joshellissh/UltimaGC/ultima-app/assets/images/car_lights_off.png

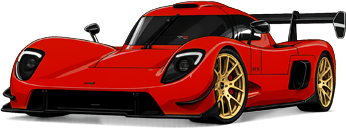
ultima-app/assets/images/car_lights_off.png
