joshellissh/UltimaGC/ultima-app/assets/images/car_lights_on.png

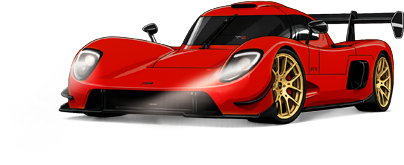
ultima-app/assets/images/car_lights_on.png
