joshellissh/UltimaGC/camdriver/nvp6324-1080p25-regseq.md

# NVP6324 — AHD20_1080P_25P register sequence (porting spec for nvp6324.c)

Validated extraction from the vendor reference (chip-only files) for **channel 0,
AHD 2.0 1080p25, 4-lane MIPI CSI-2 UYVY**. This is the spec to port into
`nvp6324_setup_mipi()` / `nvp6324_setup_channel()` (replacing the M0 stubs).

Format: `{bank, reg} = value`. Slave 0x60 (7-bit 0x30 in the ref; **this board is
0x31**). Bank select = reg 0xFF. 8-bit/8-bit. **Order matters** where noted.

## Critical gotchas (do these right)
- **OMIT the test pattern.** The ref calls `vd_pattern_enable()` unconditionally
  (bank0 0x1C-0x1F=0x1A; bank5/6/7/8 0x6A=0x80) → color bars. Do NOT port it, or we
  get bars instead of live video.
- **Use the net-final values** (List 4) where the EQ stage overwrites a seq value —
  a regmap driver writes each reg once.
- **`h_mask_sel` is bank(0x05+ch) 0x38 bits[3:0]=0x03, NOT bank0 0x8E** (my
  `nvp6324_regs.h` comment was wrong — fix it). `ahd_mode`=bank0 0x08=0x03 ✓,
  `burst_dec_c`=bank5 0xD1=0x30 ✓.
- **Bank-cache bug in the ref** (do the intended thing): CLK_AUTO must clear
  **bank1 0x7C bit(ch)** — the ref accidentally writes it in bank 0x13. Program
  bank1 0x7C[ch]=0 explicitly.
- Bitfield writes = `regmap_update_bits` (RMW): 01/7C[ch], 05/69[0], 05/38[4] &
  [3:0], 00/14[4]+CHID, 05/53[3:2], EQ 00/6C[3:0], bank13 0x30/0x31/0x32
  (clear bit ch & ch+4), bank21 0x3E nibble, bank20 0x01 [2ch +:2].

## Channel-index arithmetic (ch0 → ch1-3)
- per-ch decoder bank = `0x05 + ch`; bank0 color/timing regs `addr + ch`
  (0x00,0x08,0x14,0x20,0x68 families); bank9 H-scaler `addr + 0x20*ch`,
  FSC_EXT_VAL `0x50 + 4*ch`, FSC_DET `0x40+ch`; bank1 clocks `addr + ch`
  (0x84,0x88,0x8C,0xC8,0xCC,0xEC), CLK_AUTO 0x7C bit(ch); bankA/B EQ
  `bank = 0x0A + ((ch)/2)`, `addr = base + (ch%2)*0x80`; MIPI datatype 0x38+ch;
  arb enable `en_param |= 0x11 << ch`.

---

## LIST 1 — COMMON init (once)

### 1A video_decoder_init
- bank0x04: 0xA0..0xC3 = 0x24 (36 writes)
- bank0x01: 0xCC,0xCD,0xCE,0xCF = 0x64  (later zeroed by 1D — net 0x00)
- bank0x21: 0x07=0x80 then 0x07=0x00 (MIPI reset pulse)
- bank0x0A: 0x77=0x8F, 0xF7=0x8F ; bank0x0B: 0x77=0x8F, 0xF7=0x8F

### 1B mipi_tx_init (1080p / ~1242 MHz) — KEEP THIS ORDER (0x44/0x49 is a lock pulse)
bank0x21:
```
40=B4 41=00 42=03 43=43            (PLL)
11=08 10=13 12=0B 13=12 17=02 18=12 15=07 14=2D 16=0B 19=09 1A=15 1B=11 1C=0E  (D-PHY timing)
44=00 49=F3 49=F0 44=02            (PLL/reset latch pulse)
08=40 0F=01                        (frame-cnt en)
38=1E 39=1E 3A=1E 3B=1E            (VC0-3 datatype YUV422)
07=0F                              (4-lane enable)
2D=01
```

### 1C arb_init
bank0x20: 00=00 ; 40=01 ; 0F=00 ; 0D=01 ; 40=00 ; 00=en_param (0x11 ch0-only, 0xFF all 4)

### 1D disable_parallel
bank0x01: 0xC8..0xCF = 0x00 (8 writes)

### 1E vd_pattern_enable — **DO NOT PORT** (test pattern)

---

## LIST 2 — PER-CHANNEL (ch0, 1080p25), full-byte unless [pos:size]
(values already reconciled = final; †marked ones get overwritten by EQ → see LIST 4)
```
00/00=10                           per-ch soft-set
00/18=13                           EX_CBAR_ON
05/00=D0  05/01=A2†  05/92=00      AFE single-ended (05/01 → 2C final)
01/EC=00  01/C8=30                 VO yc-merge, vport_out_sel=4mux
13/30 &= ~0x11  13/31 &= ~0x11  13/32 &= ~0x01   (det-en clear, ch0)  [manual RMW]
01/7C[0]=0                         CLK_AUTO_1 off (bank1! see gotcha)
05/32=10  05/B9=B2†  05/6E=00 05/6F=00           (05/B9 → 72 final)
09/44=00
05/00=D0 05/02=0C 05/1E=00 05/58=00† 05/59=00 05/5A=00 05/5B=41 05/5C=78 05/94=00 05/95=00 05/65=80†   (vafe seq2; 58→77, 65→00 final)
00/10=20  00/0C=00  00/04=00  00/08=03  05/69[0]=0  05/62=20   (format seq3; ahd_mode=03)
00/5C=82  05/28=90†  05/25=DC  05/90=01                        (chroma; 28→80 final)
00/68=48  00/6C=00  00/60=10  00/78=80†  05/38[4]=1 05/38[3:0]=3  00/64=00†  00/14[4]=0  05/64=00 05/47=EE 05/A9=00   (h-timing; 78→21,64→05 final,05/38→0x13)
05/53[3:2]=0  09/96=00 09/97=00 09/98=00 09/99=00 09/9E=00      (h-scaler seq6)
05/50=C6  05/B8=39  05/BB=0F  05/B7=FC                          (hpll seq7)
00/20=00 00/24=86 00/28=80 00/58=80 00/40=00 00/44=00 00/48=00 00/4C=F8† 00/50=F8† 05/2B=A8 05/24=2A 05/5F=00 05/D1=30   (color seq8; 4C→FE,50→FB final)
09/44=00 09/50=30 09/51=6F 09/52=67 09/53=48                    (FSC_EXT_VAL)
05/26=40  05/B8=39  09/40=00  05/B5=80
00/14 = (old&0x10)|CHID(0)                                       (port ch id, RMW)
01/84=44†  01/88=01  01/8C=02  05/01=2C  05/05=24  05/1D=0C     (clock seq9; 84→04 final)
# then per-ch mipi glue:
21/3E low-nibble=0 (RMW)   20/01 [1:0]=0 (RMW, arb_scale=0)
```

## LIST 3 — Cable-EQ (STAGE_0/CABLE_A/SINGLE_ENDED, ch0) — runs AFTER list 2
```
05/65=00 05/58=77 05/5C=78 0A/3D=00 0A/3C=00
0A/30=AC 0A/31=78 0A/32=17 0A/33=C1 0A/34=40 0A/35=00 0A/36=C3 0A/37=0A 0A/38=00 0A/39=02 0A/3A=00 0A/3B=B2   (deqA_01..12)
00/24=86 00/30=00 00/34=00 05/31=82 00/5C=82 00/40=00 00/44=00 00/48=00 00/4C=FE 00/50=FB 00/28=80 05/27=57 05/28=80 05/2B=A8 05/24=2A 05/5F=00 05/D1=30 05/D5=80 0A/25=10 0A/27=1E   (color)
00/68=48 05/38=13 00/6C[3:0]=0 00/64=05          (timing_a)
01/84=04 01/88=01 01/8C=02                        (clk — 84→04 wins)
09/96..9E=00 (9 regs) 09/40=00 05/90=01 05/B9=72 05/57=00 05/25=DC 00/04=00 00/08=03 00/0C=00 00/78=21 05/1D=0C 05/01=2C 05/05=24   (timing_b)
```

## LIST 4 — net-final where seq vs EQ disagree (use these)
01/84=04 · 05/65=00 · 05/58=77 · 05/01=2C · 05/B9=72 · 05/28=80 · 00/4C=FE · 00/50=FB · 00/64=05 · 00/78=21

Source refs: mipi_dev_nvp6324.c:139-415, jaguar1_mipi.c:157-257, jaguar1_video.c:790-893,
jaguar1_video_table.h:773-853, jaguar1_video_eq.c:166-210, jaguar1_cableA_video_eq_table.h:741-830.
