joshellissh/UltimaGC/PSD Files/360 car.png

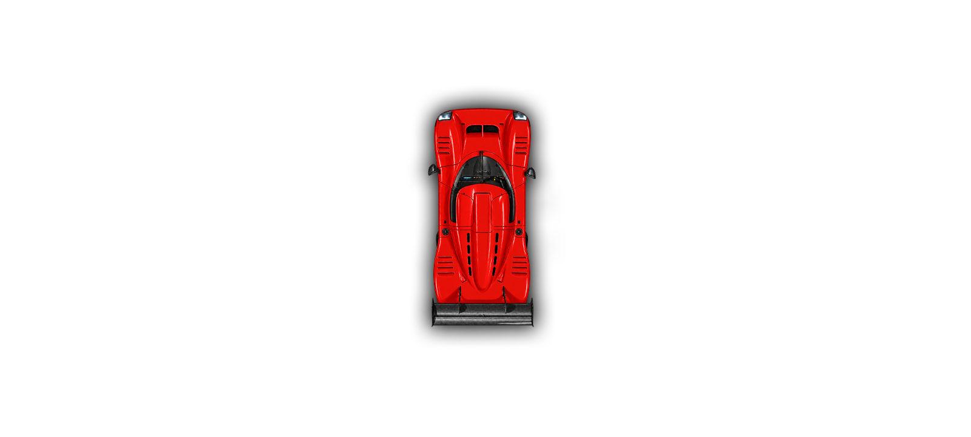
PSD Files/360 car.png
