joshellissh/UltimaGC/PSD Files/360 Top View.png

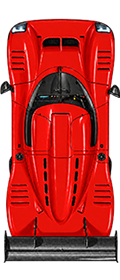
PSD Files/360 Top View.png
