joshellissh/UltimaGC/PSD Files/background overlay.png

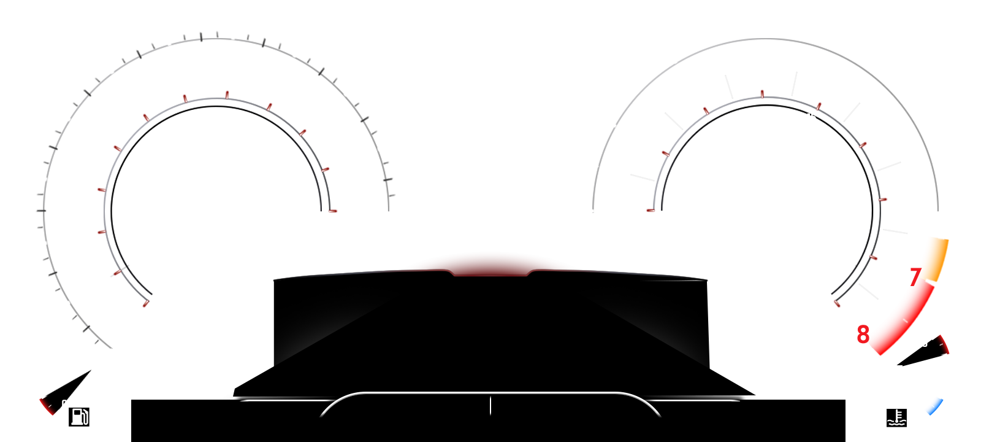
PSD Files/background overlay.png
