joshellissh/UltimaGC/PSD Files/boost circle.png

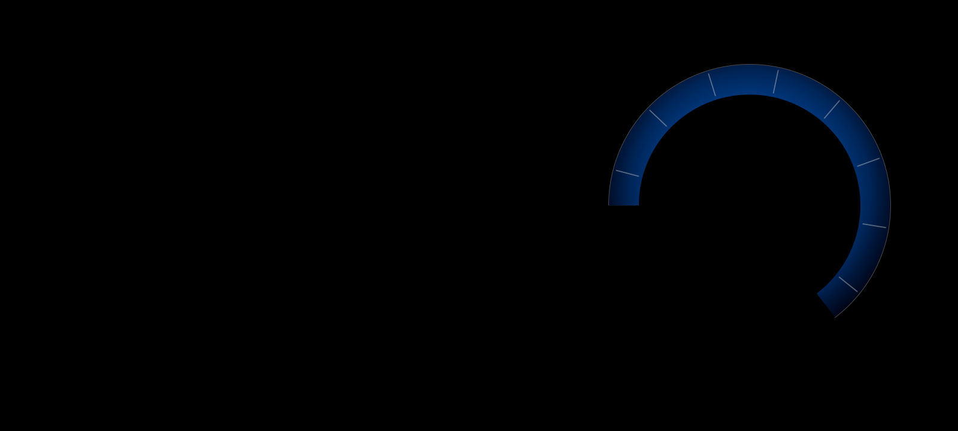
PSD Files/boost circle.png
