joshellissh/UltimaGC/PSD Files/car lights off.png

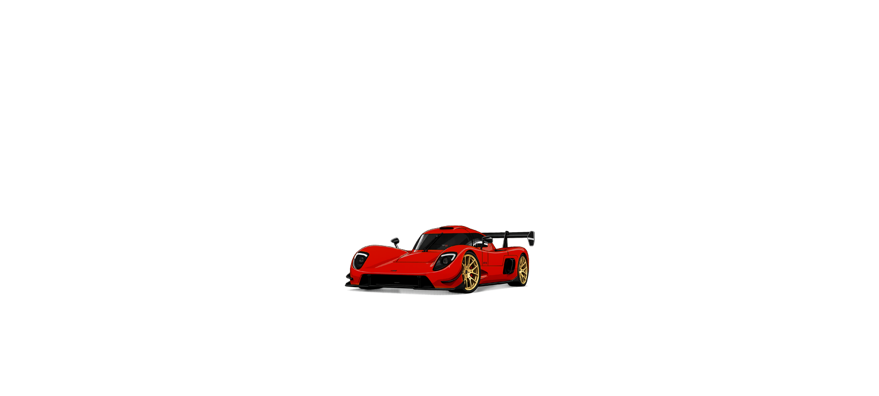
PSD Files/car lights off.png
