joshellissh/UltimaGC/PSD Files/cel shaded Ultima.png

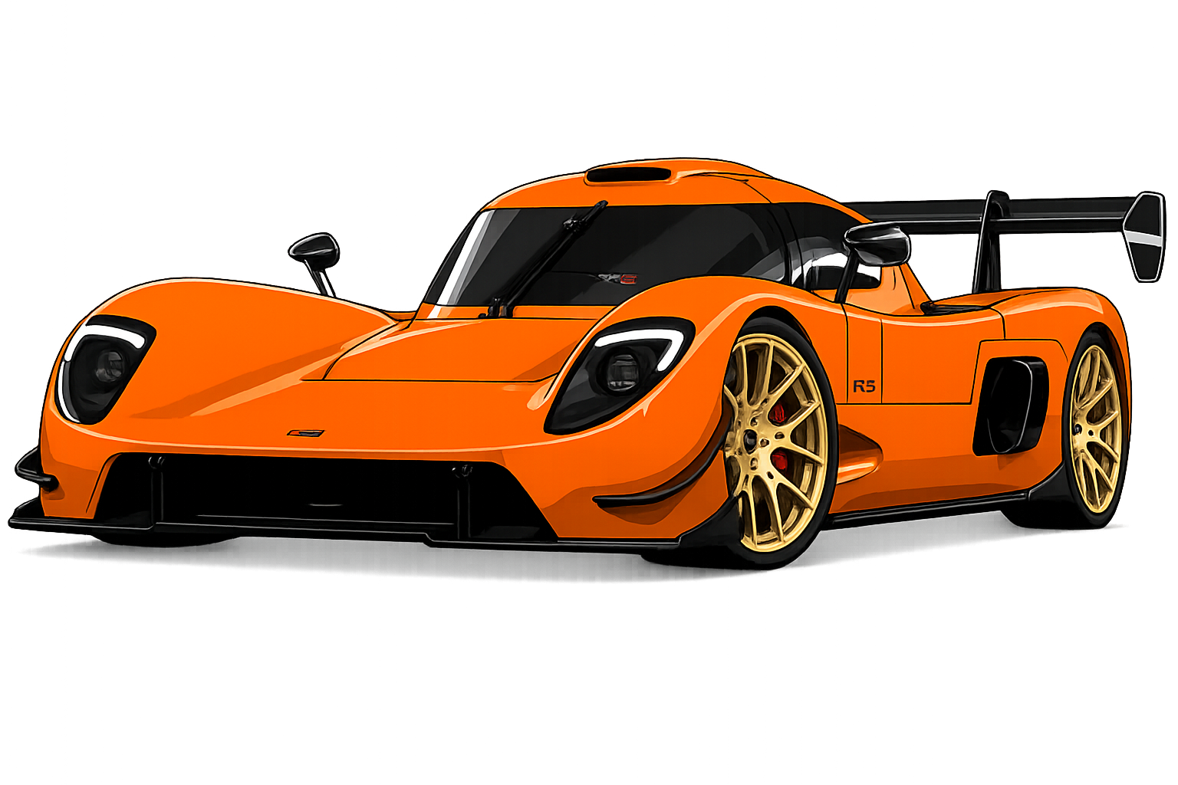
PSD Files/cel shaded Ultima.png
