joshellissh/UltimaGC/PSD Files/ChatGPT Image Jul 31, 2026, 09_45_48 AM.png

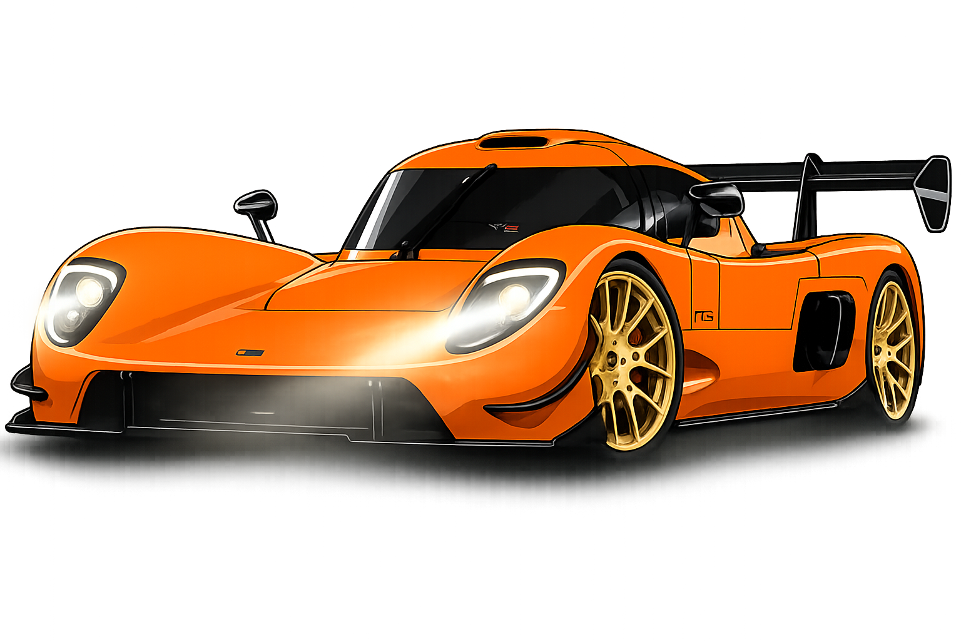
PSD Files/ChatGPT Image Jul 31, 2026, 09_45_48 AM.png
