joshellissh/UltimaGC/PSD Files/RS top view.png

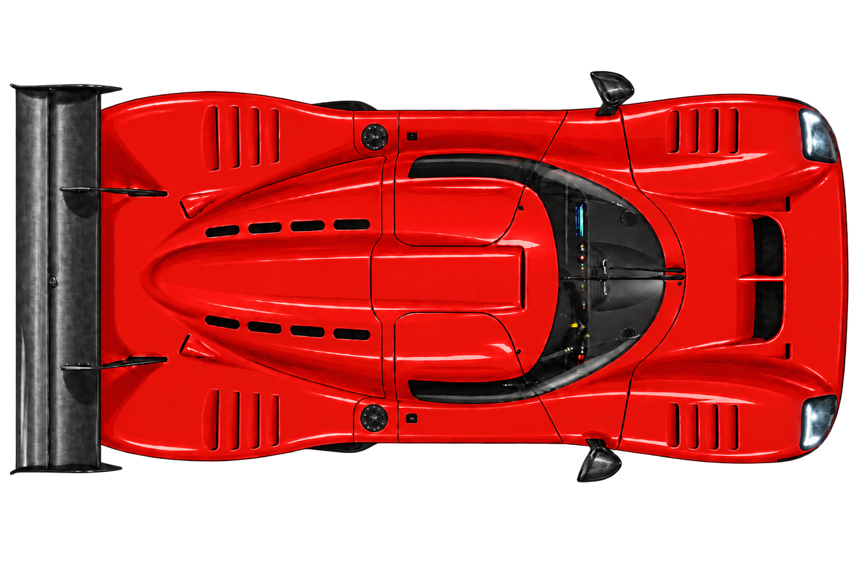
PSD Files/RS top view.png
