joshellissh/UltimaGC/PSD Files/three quarter wireframe outline.png

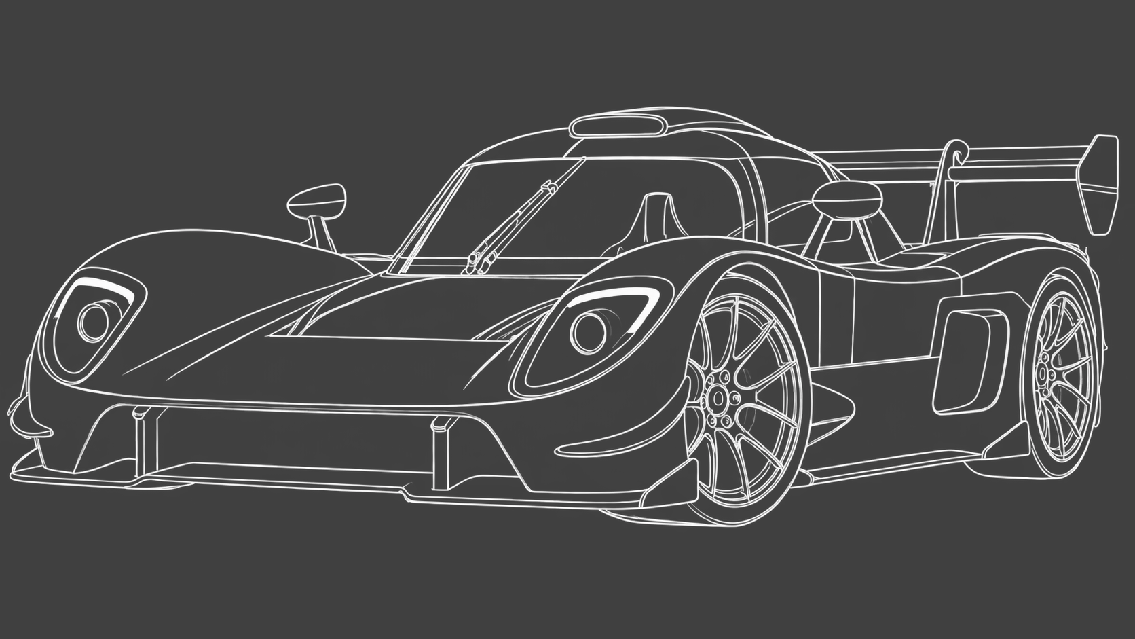
PSD Files/three quarter wireframe outline.png
