joshellissh/UltimaGC/enclosure/MCE18 Dummy.stl

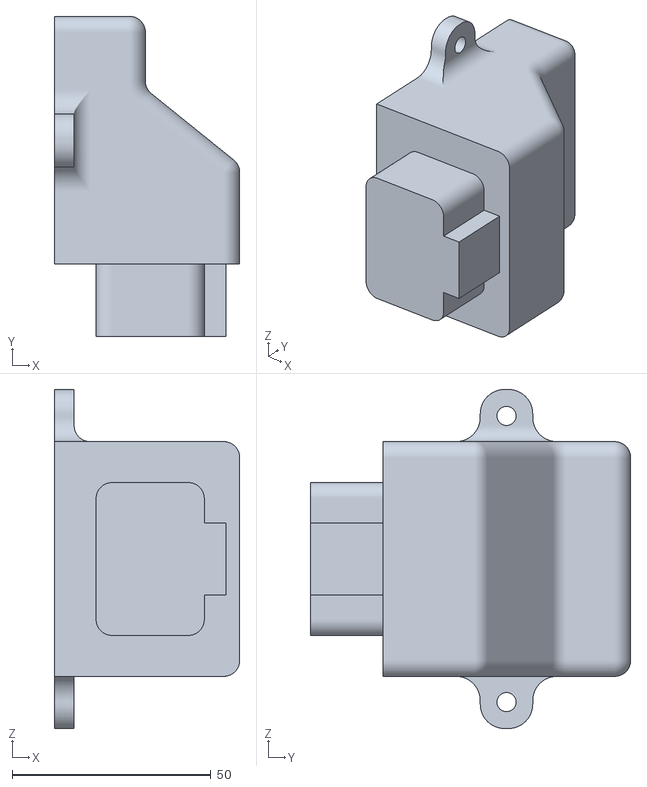
[picture p12: CAD file, 2026-08-24, last stored version]
enclosure/MCE18 Dummy.stl
46.6 x 80.5 x 85.2
