joshellissh/UltimaGC/enclosure/print files/Enclosure Base.step

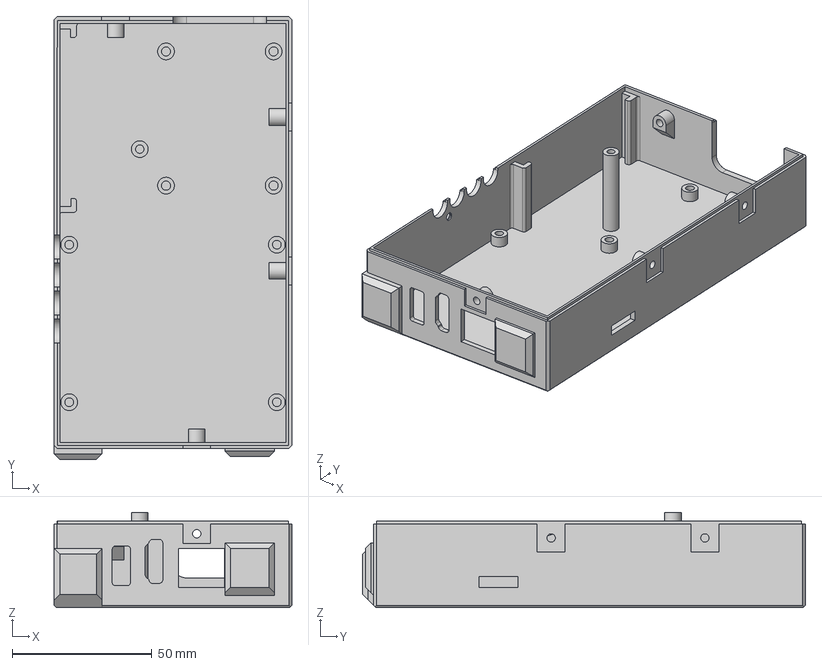
[picture p13: CAD file, 2026-08-26, last stored version]
enclosure/print files/Enclosure Base.step
85.0 x 158.5 x 34.0 mm
