joshellissh/UltimaGC/enclosure/print files/MY-CAM Holder bottom.step

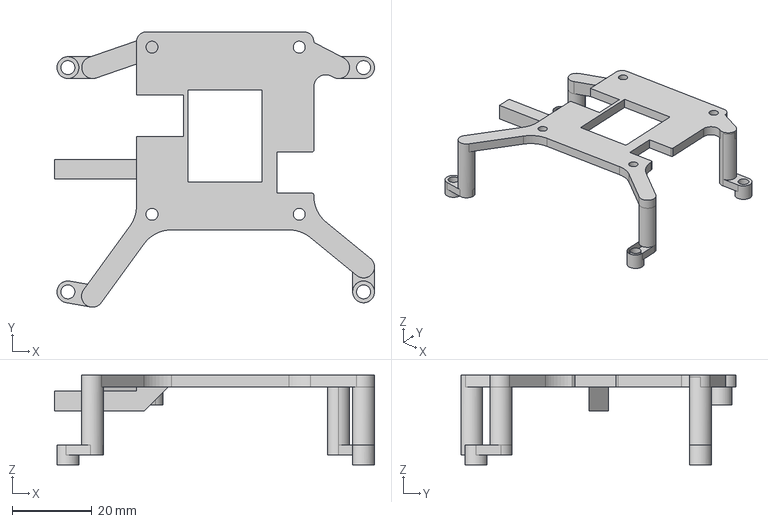
[picture p14: CAD file, 2026-08-25, last stored version]
enclosure/print files/MY-CAM Holder bottom.step
80.4 x 69.2 x 22.5 mm
