joshellissh/UltimaGC/enclosure/CAN_SPI_click_3.3V_v100.step

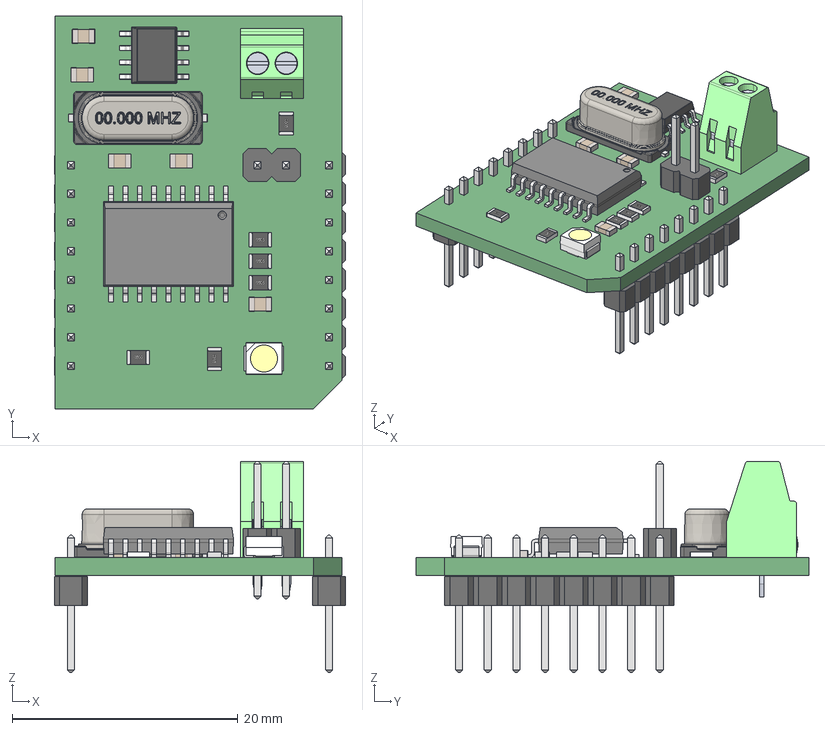
[picture p15: CAD file, 2026-08-24, last stored version]
enclosure/CAN_SPI_click_3.3V_v100.step
25.8 x 34.8 x 18.7 mm
Board
User_Library-SOIC18-300
User_Library-SMD_CAPACITOR0805 x 5
User_Library-Pin_Header_Strip_1x2 x 9
ScrewTerminal_2.54
SOIC08_narrow
User_Library-Everlight_67-21SRC-TR8_Imported
User_Library-Everlight_67-21SRC-TR8_Imported_2
User_Library-Everlight_67-21SRC-TR8_Imported_3
User_Library-Everlight_67-21SRC-TR8_Imported_4
User_Library-HC-49S
User_Library-R_0805 x 6
