joshellissh/UltimaGC/enclosure/print files/MY-CAM Holder.step

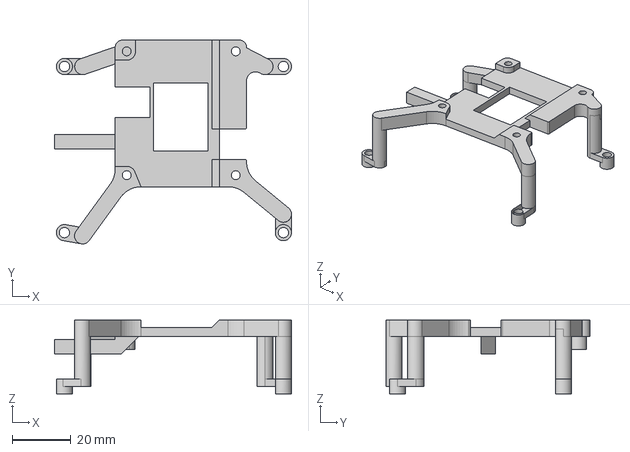
[picture p16: CAD file, 2026-08-25, last stored version]
enclosure/print files/MY-CAM Holder.step
80.4 x 69.2 x 25.0 mm
