joshellissh/UltimaGC/enclosure/print files/MY-CAM Holder Top.step

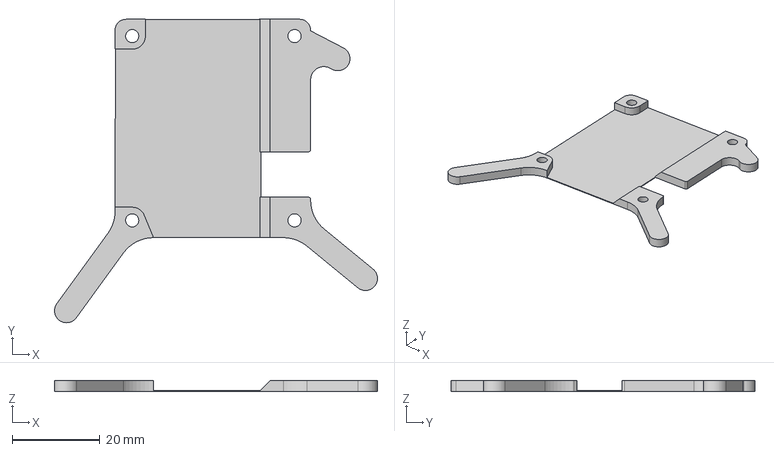
[picture p17: CAD file, 2026-08-25, last stored version]
enclosure/print files/MY-CAM Holder Top.step
73.6 x 69.2 x 2.50 mm
