joshellissh/UltimaGC/enclosure/pxc_1803277_05_01_MC-1-5-2-G-3-81_3D.stp

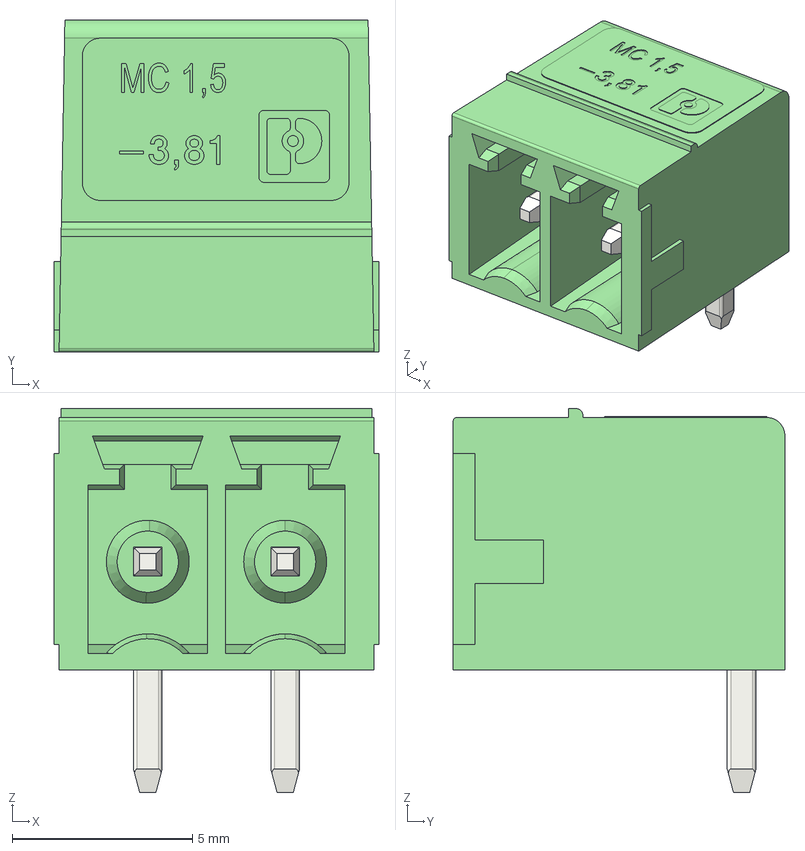
[picture p18: CAD file, 2026-08-24, last stored version]
enclosure/pxc_1803277_05_01_MC-1-5-2-G-3-81_3D.stp
9.01 x 9.20 x 10.7 mm
