joshellissh/UltimaGC/enclosure/Enclosure rev1.step

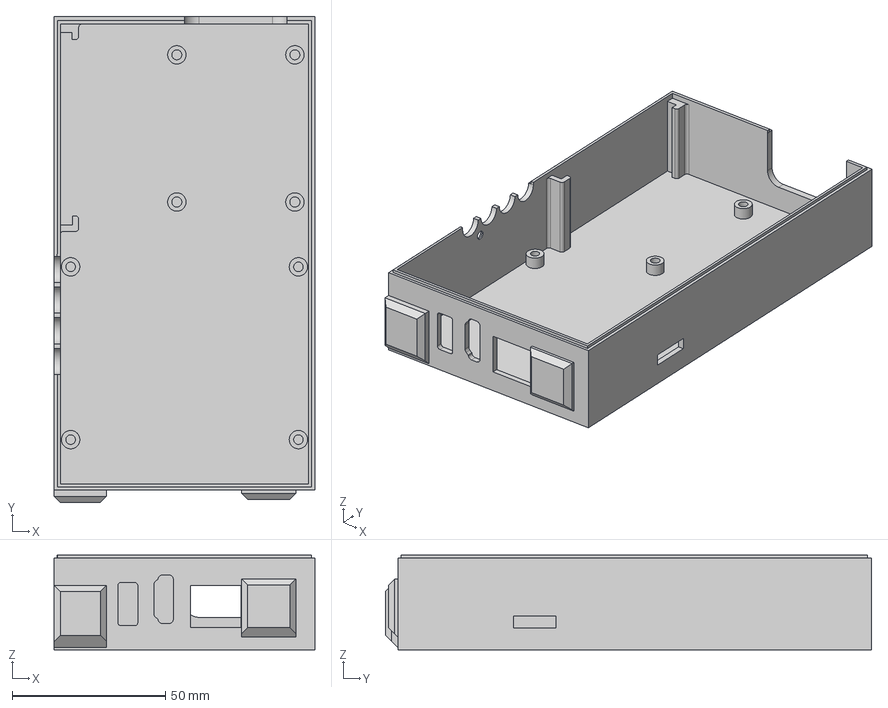
[picture p19: CAD file, 2026-08-24, last stored version]
enclosure/Enclosure rev1.step
85.0 x 158.5 x 30.9 mm
