joshellissh/UltimaGC/enclosure/print files/bust_1.stl

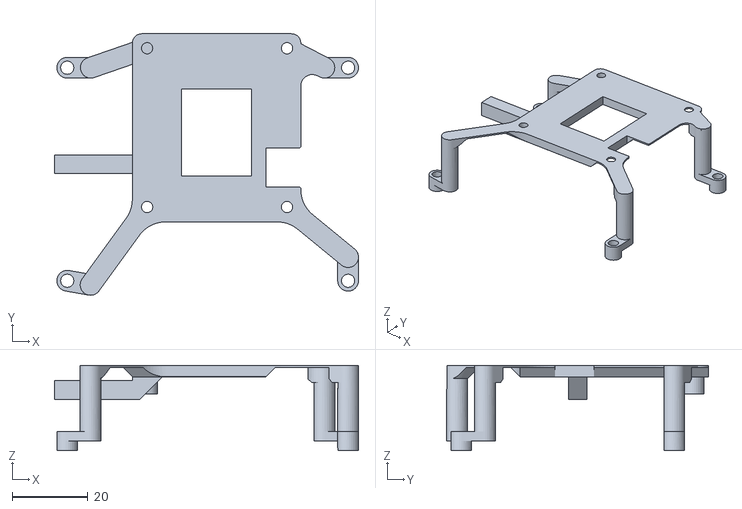
[picture p20: CAD file, 2026-08-25, last stored version]
enclosure/print files/bust_1.stl
80.4 x 69.2 x 22.5
