joshellissh/UltimaGC/enclosure/print files/USB Hub Support.step

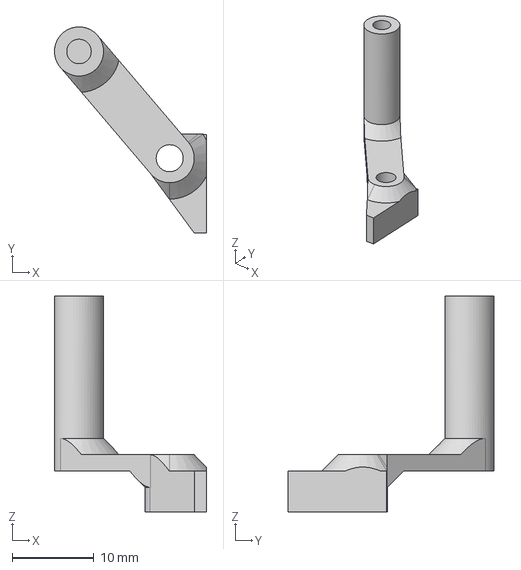
[picture p21: CAD file, 2026-08-25, last stored version]
enclosure/print files/USB Hub Support.step
18.6 x 25.2 x 26.4 mm
