joshellissh/UltimaGC/enclosure/TE 6437288-1.stp

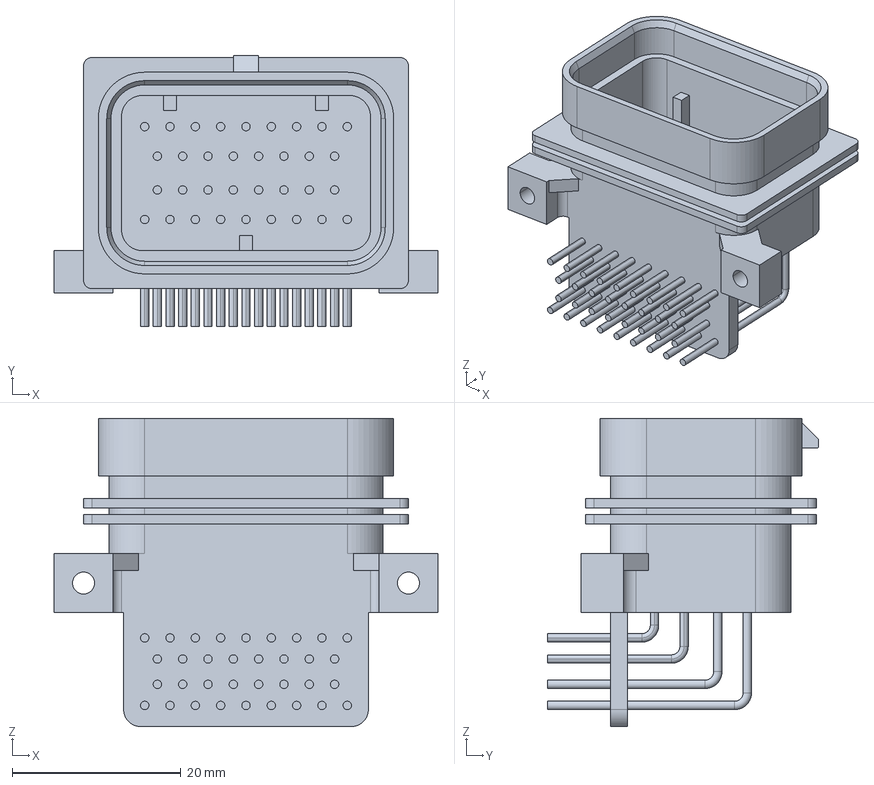
[picture p22: CAD file, 2026-08-24, last stored version]
enclosure/TE 6437288-1.stp
45.5 x 32.1 x 36.5 mm
