joshellissh/UltimaGC/enclosure/MY-CAM004M_PCB_65x50x1p6.step

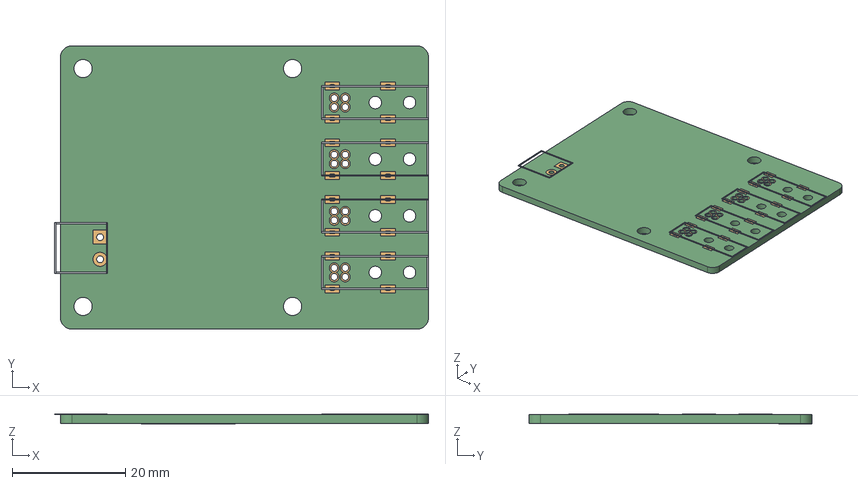
[picture p23: CAD file, 2026-08-24, last stored version]
enclosure/MY-CAM004M_PCB_65x50x1p6.step
66.0 x 50.0 x 1.84 mm
PCB
CON1_outline_1
CON1_outline_2
CON1_outline_3
CON1_outline_4
CON1_pinpad_1
CON1_pinpad_2
CON1_pinpad_3
CON1_pinpad_4
CON1_slotpad_1
CON1_slotpad_2
CON1_slotpad_3
CON1_slotpad_4
CON2_outline_1
CON2_outline_2
CON2_outline_3
CON2_outline_4
CON2_pinpad_1
CON2_pinpad_2
CON2_pinpad_3
CON2_pinpad_4
CON2_slotpad_1
CON2_slotpad_2
CON2_slotpad_3
CON2_slotpad_4
CON3_outline_1
CON3_outline_2
CON3_outline_3
CON3_outline_4
CON3_pinpad_1
CON3_pinpad_2
CON3_pinpad_3
CON3_pinpad_4
CON3_slotpad_1
CON3_slotpad_2
CON3_slotpad_3
CON3_slotpad_4
CON4_outline_1
CON4_outline_2
CON4_outline_3
CON4_outline_4
CON4_pinpad_1
CON4_pinpad_2
CON4_pinpad_3
CON4_pinpad_4
CON4_slotpad_1
CON4_slotpad_2
CON4_slotpad_3
CON4_slotpad_4
J6_outline_1
J6_outline_2
J6_outline_3
J6_outline_4
J6_pin1_pad
J6_pin2_pad
J7_outline_1
J7_outline_2
J7_outline_3
J7_outline_4
J7_pad_01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
