joshellissh/UltimaGC/enclosure/print files/bust_2.stl

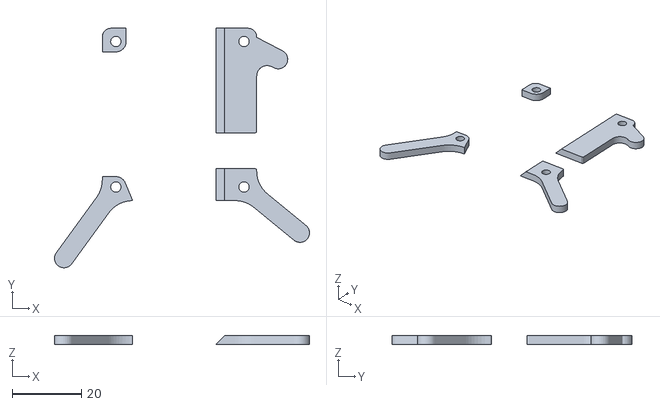
[picture p24: CAD file, 2026-08-25, last stored version]
enclosure/print files/bust_2.stl
73.6 x 69.2 x 2.50
