joshellissh/UltimaGC/enclosure/SJ-43514-SMT-TR--3DModel-STEP-1.STEP

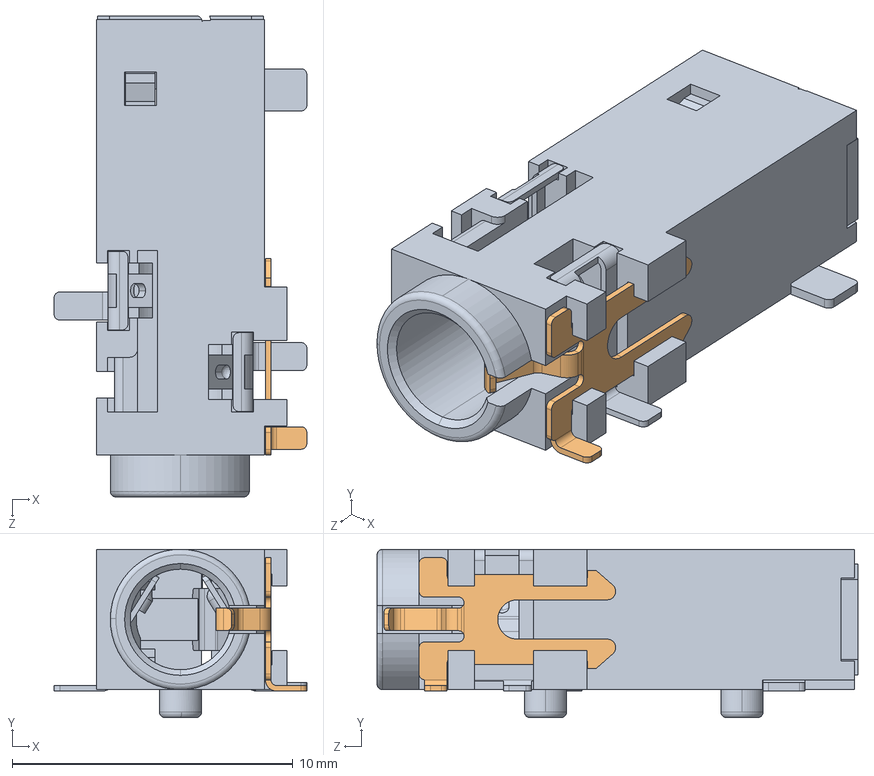
[picture p25: CAD file, 2026-08-24, last stored version]
enclosure/SJ-43514-SMT-TR--3DModel-STEP-1.STEP
9.00 x 6.00 x 17.1 mm
