joshellissh/UltimaGC/enclosure/FH12-24S-0.5SH.stp

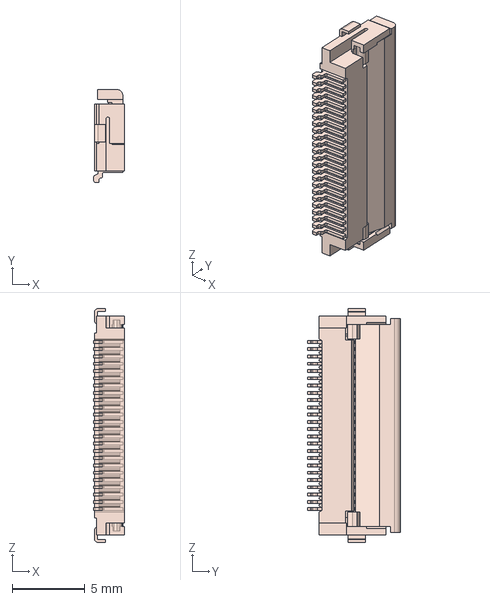
[picture p26: CAD file, 2026-08-24, last stored version]
enclosure/FH12-24S-0.5SH.stp
2.10 x 6.40 x 16.1 mm
