joshellissh/UltimaGC/enclosure/usb_hub_pcb_40x30_fused.step

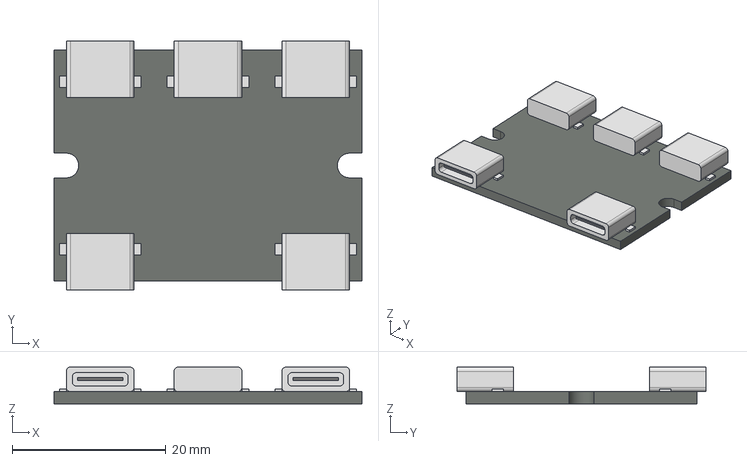
[picture p27: CAD file, 2026-08-24, last stored version]
enclosure/usb_hub_pcb_40x30_fused.step
40.0 x 32.4 x 4.80 mm
