joshellissh/UltimaGC/enclosure/687124149022_Wurth_24pin_0p5_bottom_hinge.stp

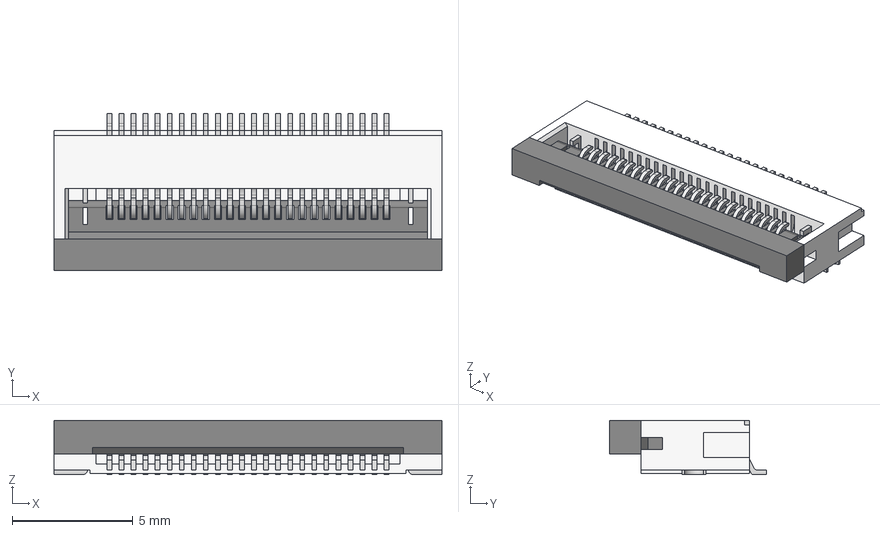
[picture p28: CAD file, 2026-08-24, last stored version]
enclosure/687124149022_Wurth_24pin_0p5_bottom_hinge.stp
16.1 x 6.50 x 2.25 mm
6871xx149022_Pin x 24
6871xx149022_Patte
6871xx149022_Patte2
687124149022_Actuator
