joshellissh/UltimaGC/(list of files, cad)

Other CAD files:
enclosure/MY-CAM Holder.step
enclosure/MY-CAM Holder.stl
enclosure/print files/MY-CAM Holder.iges
