joshellissh/UltimaGC/docs/MY-CAM to BeaglePlay Pin Mapping.pdf

1 | GND
2 | D0_N

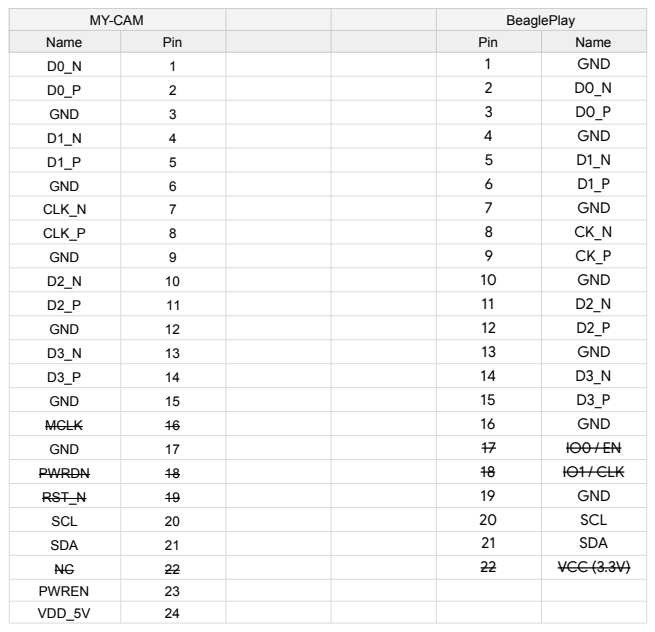
[picture p29: page 1]
MY-CAM; BeaglePlay; Name; Pin; GND; CLK_N; CLK_P; MCLK; PWRDN; IO1 / CLK; RST_N; SCL; SDA; VCC (3.3V); PWREN; VDD_5V
