joshellissh/UltimaGC/docs/MY-CAM004M/my-cam004m-20230725.pdf

## DVDD>=2.5V SEL18=Low

# Camera

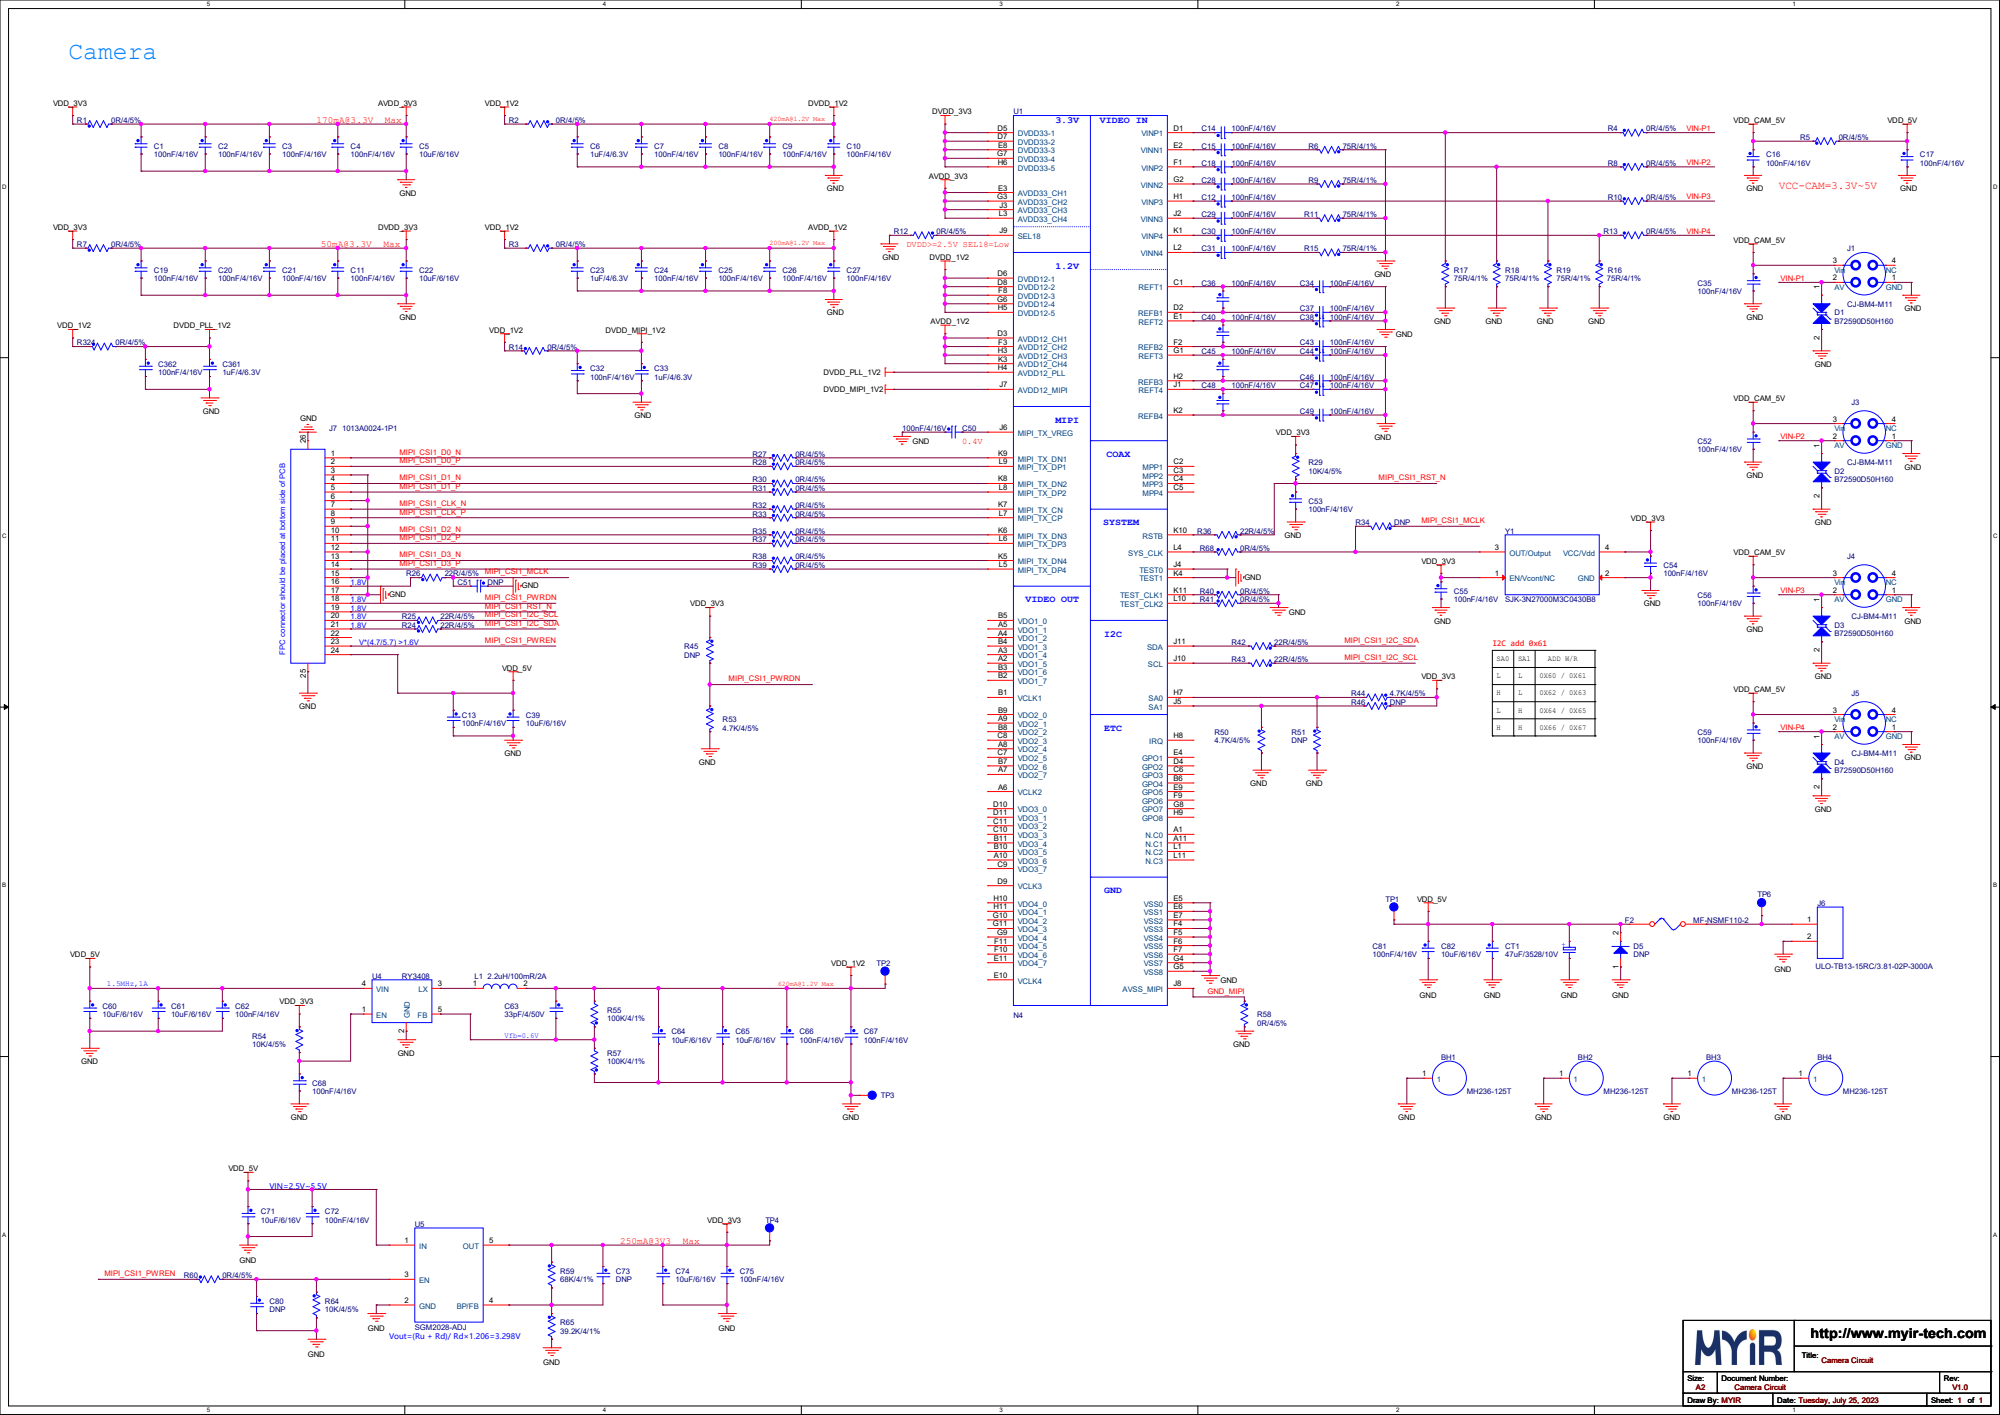
[picture p30: page 1]

FPC connector should be placed at bottom side of PCB

SA0 | SA1 | ADD W/R
L | L | 0X60 / 0X61
H | L | 0X62 / 0X63
L | H | 0X64 / 0X65
H | H | 0X66 / 0X67

SGM2028-ADJ
Vout=(Ru + Rd)/ Rd×1.206=3.298V

http://www.myir-tech.com
