joshellissh/UltimaGC/ultima-app/canbus.cpp

#include "canbus.h"
#include "odostore.h"

#include <QDateTime>
#include <QtGlobal>
#if !defined(__linux__) || defined(ULTIMA_SIMULATE)
#include <QRandomGenerator>
#include <cmath>
#include <algorithm>
#include <QStringList>
#include <QVariantMap>
#endif

#include <stdio.h>

#ifdef __linux__
#include <sys/socket.h>
#include <sys/ioctl.h>
#include <linux/can.h>
#include <linux/can/raw.h>
#include <net/if.h>
#include <unistd.h>
#include <fcntl.h>
#include <errno.h>
#include <string.h>
#endif

// Syvecs S7+ CAN frames are 8 bytes carrying four 16-bit big-endian quantities
// in slots 1..4 at byte offsets 0-1, 2-3, 4-5, 6-7. This car's CAN2 layout is
// a custom Generic CAN Transmit config (NOT a mirror of the CAN1 fixed stream
// DBC); verified frame map below was read from SCal Datastreams → Generic CAN
// Transmit → Transmit Content. Channel scalings/signedness are the Syvecs
// per-channel defaults documented in the published S7 Fixed Stream v3 DBC.

static inline quint16 be_u16(const quint8 *d, int off) {
    return (quint16(d[off]) << 8) | quint16(d[off + 1]);
}
static inline qint16 be_s16(const quint8 *d, int off) {
    return qint16(be_u16(d, off));
}

// MCE18 CAN bus expander (CANchecked-protocol) — supplies the analog/digital
// inputs the Syvecs S7+ has no channel for at all (fuel sender, turn
// signals, beams, axle lift). See docs/MCE18-manual_V3+V4.pdf and
// GAUGE-CLUSTER.md's MCE18 section for the full frame layout. Unit is
// configured via DSS (confirmed 2026-08-21): "CANchecked 0-5000mV" protocol,
// TX Base ID 0x700 (datasheet default), CAN speed 1 Mbit/s to match Syvecs
// CAN2 and can0's udev-configured bitrate. The AIN0-8/DIN0-7/AUX1-3 frame
// layout (this frame + Base ID+2 below) is identical between the
// "0-1023bit" and "0-5000mV" protocol options — only the frequency-channel
// frames at Base ID+3 onward (unused here) differ — so this TX Base ID and
// byte layout aren't protocol-dependent, just the protocol choice below.
static constexpr quint32 kMce18Base = 0x700;
// AIN0-8 are millivolts (0-5000mV) directly under the configured
// "CANchecked 0-5000mV" protocol — the unit does its own ADC-to-voltage
// conversion internally, no raw-counts-to-mV scaling needed on our end.
// Fuel sender: 1V empty, 4V full (per sender spec) — narrower than the AIN's
// own 0-5V range, so this is still a conversion against the sender's own
// linear span, just no longer stacked on top of a raw-to-mV one.
static constexpr double kFuelSenderEmptyMv = 1000.0;
static constexpr double kFuelSenderFullScaleMv = 4000.0;

CanBus::CanBus(OdoStore *odo, const QString &iface, QObject *parent)
    : QObject(parent), m_odo(odo), m_iface(iface)
{
    if (m_odo) {
        m_totalOdo = m_odo->totalOdo();
        m_tripOdo = m_odo->tripOdo();
    }
    m_ind[IndLeft].level = &m_leftIndicator;
    m_ind[IndLeft].changed = &CanBus::leftIndicatorChanged;
    m_ind[IndRight].level = &m_rightIndicator;
    m_ind[IndRight].changed = &CanBus::rightIndicatorChanged;
    m_ind[IndHazard].level = &m_hazard;
    m_ind[IndHazard].changed = &CanBus::hazardChanged;
    m_reconnectTimer.setInterval(1000);
    connect(&m_reconnectTimer, &QTimer::timeout, this, &CanBus::tryConnect);
    tryConnect();
}

CanBus::~CanBus()
{
    closeSocket();
}

void CanBus::closeSocket()
{
#ifdef __linux__
    if (m_notifier) {
        m_notifier->setEnabled(false);
        m_notifier->deleteLater();
        m_notifier = nullptr;
    }
    if (m_fd >= 0) {
        ::close(m_fd);
        m_fd = -1;
    }
#endif
}

void CanBus::tryConnect()
{
#if defined(__linux__) && !defined(ULTIMA_SIMULATE)
    if (m_fd >= 0)
        return;

    int fd = ::socket(PF_CAN, SOCK_RAW | SOCK_NONBLOCK, CAN_RAW);
    if (fd < 0) {
        fprintf(stderr, "[canbus] socket(PF_CAN): %s\n", strerror(errno));
        m_reconnectTimer.start();
        return;
    }

    struct ifreq ifr;
    memset(&ifr, 0, sizeof(ifr));
    strncpy(ifr.ifr_name, m_iface.toLocal8Bit().constData(), IFNAMSIZ - 1);
    if (::ioctl(fd, SIOCGIFINDEX, &ifr) < 0) {
        // Interface not present yet — udev hasn't brought it up.
        ::close(fd);
        m_reconnectTimer.start();
        return;
    }

    struct sockaddr_can addr;
    memset(&addr, 0, sizeof(addr));
    addr.can_family = AF_CAN;
    addr.can_ifindex = ifr.ifr_ifindex;
    if (::bind(fd, (struct sockaddr *)&addr, sizeof(addr)) < 0) {
        // Most common reason here: link is administratively down.
        fprintf(stderr, "[canbus] bind(%s): %s\n",
                qPrintable(m_iface), strerror(errno));
        ::close(fd);
        m_reconnectTimer.start();
        return;
    }

    m_fd = fd;
    m_notifier = new QSocketNotifier(fd, QSocketNotifier::Read, this);
    connect(m_notifier, &QSocketNotifier::activated, this, &CanBus::onReadable);
    m_reconnectTimer.stop();
    fprintf(stderr, "[canbus] connected to %s\n", qPrintable(m_iface));
#else
    // SocketCAN is Linux-only, and even on Linux this branch only compiles
    // for dev builds (CONFIG+=ultima_dev_sim). Drive the gauges with a
    // simulated data stream instead (see simulateTick()) so the QML can be
    // exercised without real CAN hardware. tryConnect() only runs once here
    // (nothing re-triggers it), so this wiring happens exactly once.
    fprintf(stderr, "[canbus] SocketCAN unavailable/disabled for this build — simulating data\n");
    connect(&m_simTimer, &QTimer::timeout, this, &CanBus::simulateTick);
    m_simTimer.start(60);
#endif
}

void CanBus::onReadable()
{
#ifdef __linux__
    struct can_frame frame;
    for (int i = 0; i < 64; ++i) {     // drain up to 64 per wake
        ssize_t n = ::read(m_fd, &frame, sizeof(frame));
        if (n < 0) {
            if (errno == EAGAIN || errno == EWOULDBLOCK)
                return;
            // Bus error / interface went down — close and retry.
            fprintf(stderr, "[canbus] read: %s — reconnecting\n", strerror(errno));
            closeSocket();
            m_reconnectTimer.start();
            return;
        }
        if (n != (ssize_t)sizeof(frame))
            return;
        // Skip error/RTR/extended frames — Syvecs uses 11-bit data frames.
        if (frame.can_id & (CAN_ERR_FLAG | CAN_RTR_FLAG | CAN_EFF_FLAG))
            continue;
        decodeFrame(frame.can_id & CAN_SFF_MASK, frame.data, frame.can_dlc);
    }
#endif
}

void CanBus::accumulateOdometer()
{
    qint64 now = QDateTime::currentMSecsSinceEpoch();
    if (m_lastSpeedMs != 0 && m_speed > 0) {
        double dt = (now - m_lastSpeedMs) / 1000.0;
        if (dt > 0 && dt < 1.0) {           // ignore stalls
            double miles = m_speed * dt / 3600.0;
            m_totalOdo += miles;
            m_tripOdo += miles;
            emit totalOdoChanged();
            emit tripOdoChanged();
        }
    }
    m_lastSpeedMs = now;
}

// Syvecs limpMode enum (Frame 5/0x604 slot 4), from the "Enum Values" column of
// docs/Auto Bionics CAN2 Mapping.xlsx. 1-6 are limps (power reduced); 100+ are
// trips (engine shut down). name is the sheet's label (Diagnostic screen);
// message is the plain-English text for the dash's limp box. Neither says
// which way a sensor tripped (too high or too low) — the sheet doesn't either.
// Codes not in the sheet show as "LIMP n" / "Limp code n" rather than being
// hidden. Ascending — debugCycleLimpMode() steps through it in order.
struct LimpModeEntry { int code; const char *name; const char *message; };
static const LimpModeEntry kLimpModes[] = {
    {   0, "OFF",                  "" },
    {   1, "LIMP SWITCH ON",       "Limp switch on" },
    {   2, "ECT COLD",             "Engine coolant cold" },
    {   3, "EOT COLD",             "Engine oil cold" },
    {   4, "SENSOR WARNING LEVEL", "Sensor warning" },
    {   5, "AUTO TRANS",           "Transmission fault" },
    {   6, "VEHICLE SPEED FAULT",  "Vehicle speed fault" },
    { 100, "EOP TRIP",             "Oil pressure trip" },
    { 101, "CCP TRIP",             "Crankcase pressure trip" },
    { 102, "KNOCK SHUTDOWN",       "Knock shutdown" },
    { 103, "EOT TRIP",             "Oil temperature trip" },
    { 104, "ECT TRIP",             "Coolant temperature trip" },
    { 105, "FP TRIP",              "Fuel pressure trip" },
    { 106, "PREIGN SHUTDOWN",      "Pre-ignition shutdown" },
    { 107, "TIME ON LOAD LIMIT",   "Time on load limit" },
    { 108, "TRQ TRIP",             "Torque trip" },
    { 109, "VVT FAIL",             "VVT failure" },
    { 110, "VBAT TRIP",            "Battery voltage trip" },
    { 111, "LEAN TRIP",            "Lean mixture trip" },
    { 112, "ACT TRIP",             "Air charge temp trip" },
    { 113, "ECP TRIP",             "Coolant pressure trip" },
};

static const LimpModeEntry *findLimpMode(int code)
{
    for (const LimpModeEntry &e : kLimpModes) {
        if (e.code == code)
            return &e;
    }
    return nullptr;
}

QString CanBus::limpModeName() const
{
    const LimpModeEntry *e = findLimpMode(m_limpMode);
    return e ? QString::fromLatin1(e->name) : QStringLiteral("LIMP %1").arg(m_limpMode);
}

QString CanBus::limpModeMessage() const
{
    const LimpModeEntry *e = findLimpMode(m_limpMode);
    return e ? QString::fromLatin1(e->message) : QStringLiteral("Limp code %1").arg(m_limpMode);
}

// Human-readable converted values for one frame, for the diagnostics screen's
// raw-frame monitor. Applies the same scalings as decodeFrame() below (keep the
// two in step) but shows every decoded slot's engineering value plus its raw
// count where the conversion is non-trivial, without touching any state.
static QString describeFrame(quint32 id, const quint8 *d, int dlc)
{
    if (dlc < 8)
        return QStringLiteral("short frame (dlc %1)").arg(dlc);
    auto n = [](double v, int dec) { return QString::number(v, 'f', dec); };

    switch (id) {
    case 0x600: {
        double mapMbar = be_s16(d, 6);
        return QStringLiteral("rpm %1 | TPS %4% | MAP %2 mbar (boost %3 psi)")
            .arg(qMax(0, int(be_s16(d, 0))))
            .arg(mapMbar, 0, 'f', 0)
            .arg(qMax(0.0, (mapMbar - 1013.25) * 0.0145038), 0, 'f', 1)
            .arg(be_s16(d, 4) / 81.92, 0, 'f', 1);
    }
    case 0x601: {
        int v = be_u16(d, 0);
        static const char *names[] = { "OFF", "ON", "ACTIVE" };
        return QStringLiteral("cruise %1 (raw %2)").arg(v <= 2 ? names[v] : "?").arg(v);
    }
    case 0x604: {
        int v = be_u16(d, 6);
        const LimpModeEntry *e = findLimpMode(v);
        return QStringLiteral("limp %1 (raw %2)").arg(e ? QString::fromLatin1(e->name) : QStringLiteral("unknown")).arg(v);
    }
    case 0x605: {
        double c = be_s16(d, 2) * 0.1;
        int ma = be_u16(d, 4);
        return QStringLiteral("ECT %1 F (%2 C) | man/auto raw %3 (%4)")
            .arg(n(c * 1.8 + 32.0, 1), n(c, 1)).arg(ma).arg(ma ? "MANUAL" : "AUTO");
    }
    case 0x608: {
        double kpa = be_s16(d, 0) * 0.1;
        return QStringLiteral("EOP %1 psi (%2 kPa)").arg(n(kpa * 0.145038, 1), n(kpa, 1));
    }
    case 0x60A:
        return QStringLiteral("cal select %1 | TC switch %2").arg(be_s16(d, 2)).arg(be_s16(d, 4));
    case 0x60E: {
        int g = be_s16(d, 2);
        QString gn = g == 0 ? QStringLiteral("Unknown") : g == 1 ? QStringLiteral("R")
                   : g == 2 ? QStringLiteral("N") : QStringLiteral("%1").arg(g - 2);
        return QStringLiteral("gear %1 (raw %2) | vbat %3 V").arg(gn).arg(g).arg(n(be_u16(d, 4) * 0.001, 2));
    }
    case 0x60F: {
        double kph = be_s16(d, 0) * 0.036;
        return QStringLiteral("speed %1 mph (%2 kph)").arg(n(qMax(0.0, kph * 0.621371), 1), n(kph, 1));
    }
    case kMce18Base: {
        double fuel = qBound(0.0, (be_u16(d, 0) - kFuelSenderEmptyMv) / (kFuelSenderFullScaleMv - kFuelSenderEmptyMv), 1.0);
        return QStringLiteral("AIN0 %1 mV (fuel %2%) | AIN1 %3 | AIN2 %4 | AIN3 %5 mV")
            .arg(be_u16(d, 0)).arg(fuel * 100.0, 0, 'f', 0).arg(be_u16(d, 2)).arg(be_u16(d, 4)).arg(be_u16(d, 6));
    }
    case kMce18Base + 2: {
        static const char *din[] = { "leftInd", "rightInd", "axleLift", "lowBeams", "highBeams", "DIN5", "DIN6", "hazard" };
        QStringList on;
        for (int i = 0; i < 8; ++i)
            if (d[2] & (1 << i)) on << QString::fromLatin1(din[i]);
        return QStringLiteral("AIN8 %1 mV | DIN 0x%2: %3")
            .arg(be_u16(d, 0)).arg(d[2], 2, 16, QLatin1Char('0')).arg(on.isEmpty() ? QStringLiteral("none") : on.join(','));
    }
    default:
        return QString();
    }
}

void CanBus::recordRawFrame(quint32 id, const quint8 *d, int dlc)
{
    RawFrame &f = m_rawFrames[id];
    f.dlc = qBound(0, dlc, 8);
    memcpy(f.data, d, f.dlc);
    f.count++;
    f.lastMs = QDateTime::currentMSecsSinceEpoch();
}

QVariantList CanBus::rawFrames()
{
    const qint64 now = QDateTime::currentMSecsSinceEpoch();
    const double dt = m_rawSnapMs ? (now - m_rawSnapMs) / 1000.0 : 0.0;
    m_rawSnapMs = now;

    QList<quint32> ids = m_rawFrames.keys();
    std::sort(ids.begin(), ids.end());
    QVariantList out;
    for (quint32 id : ids) {
        RawFrame &f = m_rawFrames[id];
        QStringList bytes;
        for (int i = 0; i < f.dlc; ++i)
            bytes << QStringLiteral("%1").arg(f.data[i], 2, 16, QLatin1Char('0')).toUpper();
        QVariantMap m;
        m["id"] = QStringLiteral("0x") + QStringLiteral("%1").arg(id, 3, 16, QLatin1Char('0')).toUpper();
        m["data"] = bytes.join(' ');
        m["values"] = describeFrame(id, f.data, f.dlc);
        m["count"] = QVariant::fromValue(f.count);
        m["hz"] = dt > 0 ? (f.count - f.snapCount) / dt : 0.0;
        m["ageMs"] = now - f.lastMs;
        f.snapCount = f.count;
        out << m;
    }
    return out;
}

void CanBus::decodeFrame(quint32 id, const quint8 *d, int dlc)
{
    recordRawFrame(id, d, dlc);
    if (dlc < 8)
        return;

    switch (id) {
    case 0x600: {                                       // Frame 1: rpm @ slot 1, map1A @ slot 4
        double v = qMax(0, int(be_s16(d, 0)));
        if (v != m_rpm) { m_rpm = v; emit rpmChanged(); }

        // tps1 (SCal Slot 3/Frame 1): y=(x/81.92)+0, %. The CAN2 mapping sheet
        // leaves the Sign column blank for it; read as signed so a slightly
        // negative raw shows ~0 rather than wrapping to ~800%.
        double tps = be_s16(d, 4) / 81.92;
        if (!qFuzzyCompare(1.0 + tps, 1.0 + m_tps)) { m_tps = tps; emit tpsChanged(); }

        // map1A (SCal Slot 4/Frame 1): y=(1*x)+0, signed, absolute MAP in
        // mbar. Signed matters — near vacuum a raw negative read through an
        // unsigned decode would wrap to ~65500 and peg the gauge. Subtract
        // standard atmosphere (1013.25 mbar) to get boost above ambient.
        double mapMbar = be_s16(d, 6);
        double boostPsi = qMax(0.0, (mapMbar - 1013.25) * 0.0145038);
        if (!qFuzzyCompare(1.0 + boostPsi, 1.0 + m_boostPsi)) {
            m_boostPsi = boostPsi;
            emit boostChanged();
        }
        break;
    }
    case 0x601: {                                       // Frame 2: cruiseState @ slot 1
        // cruiseState: SCal enum 0=OFF 1=ON 2=ACTIVE. Icon only
        // distinguishes OFF/ACTIVE — ON (armed but not actively
        // controlling) reads as not-lit, same as OFF.
        int cruiseStateRaw = be_u16(d, 0);
        static const QString kCruiseStateNames[] = { QStringLiteral("OFF"), QStringLiteral("ON"), QStringLiteral("ACTIVE") };
        QString cruiseState = (cruiseStateRaw <= 2) ? kCruiseStateNames[cruiseStateRaw] : QStringLiteral("?");
        if (cruiseState != m_cruiseState) { m_cruiseState = cruiseState; emit cruiseStateChanged(); }
        bool cruiseActive = (cruiseStateRaw == 2);
        if (cruiseActive != m_cruiseControl) { m_cruiseControl = cruiseActive; emit cruiseControlChanged(); }
        break;
    }
    case 0x604: {                                       // Frame 5: limpMode @ slot 4
        int limp = be_u16(d, 6);
        if (limp != m_limpMode) { m_limpMode = limp; emit limpModeChanged(); }
        // sensorWarningLevel is not on CAN2 in this config — derive
        // checkEngine from limpMode alone.
        bool ce = (limp != 0);
        if (ce != m_checkEngine) { m_checkEngine = ce; emit checkEngineChanged(); }
        break;
    }
    case 0x605: {                                       // Frame 6: ect1 @ slot 2, ManualAuto_U12 @ slot 3
        double c = be_s16(d, 2) * 0.1;
        double f = c * 1.8 + 32.0;
        if (!qFuzzyCompare(1.0 + f, 1.0 + m_coolantTempF)) {
            m_coolantTempF = f;
            emit coolantTempChanged();
        }
        bool warn = f > 220.0;
        if (warn != m_coolantWarn) { m_coolantWarn = warn; emit coolantWarnChanged(); }

        // ManualAuto_U12: raw TCM enum. Observed on the car: 0 = Automatic,
        // 8192 (0x2000) = Manual. Test == 0 rather than != 8192 so any other
        // non-zero value still reads as Manual.
        bool transAuto = be_u16(d, 4) == 0;
        if (transAuto != m_transmissionAuto) { m_transmissionAuto = transAuto; emit transmissionAutoChanged(); }
        break;
    }
    case 0x608: {                                       // Frame 9: eop1 @ slot 1
        double eopKpa = be_s16(d, 0) * 0.1;
        double eopPsi = eopKpa * 0.145038;
        if (!qFuzzyCompare(1.0 + eopPsi, 1.0 + m_oilPressurePsi)) {
            m_oilPressurePsi = eopPsi;
            emit oilPressureChanged();
        }
        bool warn = (m_rpm >= 600.0) && (eopPsi <= 40.0);
        if (warn != m_oilPressureWarn) {
            m_oilPressureWarn = warn;
            emit oilPressureWarnChanged();
        }
        break;
    }
    case 0x60A: {                                       // Frame 11: calSelect @ slot 2, tcSwitch @ slot 3
        // Both y=(1*x)+0 per the CAN2 mapping sheet; calSelect is a signed
        // enum 0-11, tcSwitch leaves Sign blank (read as signed, like tps1).
        int cal = be_s16(d, 2);
        if (cal != m_calSelect) { m_calSelect = cal; emit calSelectChanged(); }
        // 0/1/2/3 = Valet/Sport/Sport+/Race on the dash; other enum values have
        // no known meaning yet, so the indicator goes blank rather than
        // showing a stale or wrong mode. (Before the first 0x60A frame it
        // shows the VALET default.)
        static const QString calModes[] = { QStringLiteral("VALET"), QStringLiteral("SPORT"), QStringLiteral("SPORT+"), QStringLiteral("RACE") };
        const QString mode = (cal >= 0 && cal <= 3) ? calModes[cal] : QString();
        if (mode != m_driveMode) { m_driveMode = mode; emit driveModeChanged(); }
        int tc = be_s16(d, 4);
        if (tc != m_tcSwitch) { m_tcSwitch = tc; emit tcSwitchChanged(); }
        break;
    }
    case 0x60E: {                                       // Frame 15: gear @ slot 2, vbat @ slot 3
        int g = be_s16(d, 2);
        // Syvecs: 0=Unknown 1=Reverse 2=Neutral 3=1st .. 10=8th (this car
        // only has 7 forward gears — see main.qml's "PRN1234567" comment).
        // QML:    0=P 1=R 2=N 3..9=1st..7th — Syvecs' 3=1st..9=7th already
        // equals the QML index directly, no offset needed. Syvecs has no
        // Park value at all (TCM range, not something this standalone ECU
        // tracks) so qmlGear 0 is unreachable from real CAN, same as before
        // this encoding change — only debugToggle-free, simulateTick()
        // (dev builds) can produce it.
        int qmlGear;
        if (g == 1)                  qmlGear = 1;        // Reverse
        else if (g >= 3 && g <= 9)   qmlGear = g;         // 1st..7th
        else                         qmlGear = 2;         // Neutral, Unknown, or unsupported 8th (10)
        if (qmlGear != m_gear) { m_gear = qmlGear; emit gearChanged(); }

        double vbat = be_u16(d, 4) * 0.001;
        if (!qFuzzyCompare(1.0 + vbat, 1.0 + m_vbat)) { m_vbat = vbat; emit vbatChanged(); }
        bool warn = vbat < 12.5;
        if (warn != m_batteryWarn) { m_batteryWarn = warn; emit batteryWarnChanged(); }
        break;
    }
    case 0x60F: {                                       // Frame 16: vehicleSpeed @ slot 1
        // Slots 2/3/4 also carry vehicleSpeed (driven/gps/etc.); slot 1 is the
        // primary reading and what drives the gauge + odometer.
        accumulateOdometer();
        double kph = be_s16(d, 0) * 0.036;
        double mph = qMax(0.0, kph * 0.621371);
        if (!qFuzzyCompare(1.0 + mph, 1.0 + m_speed)) {
            m_speed = mph;
            emit speedChanged();
        }
        break;
    }
    // flvlA isn't broadcast on the ECU's CAN2 config — fuel level instead
    // comes from the MCE18 expander below (AIN0), not the Syvecs frames.
    case kMce18Base: {                                   // MCE18 frame 1: AIN0-3
        // Only AIN0 (fuel sender) is wired up; AIN1-3 unused for now.
        // AIN0 arrives as millivolts directly (0-5000mV protocol). Fuel
        // sender is 1V empty / 4V full (linear, per sender spec) — scale
        // against that narrower span.
        double mv = be_u16(d, 0);
        double fuel = qBound(0.0, (mv - kFuelSenderEmptyMv) / (kFuelSenderFullScaleMv - kFuelSenderEmptyMv), 1.0);
        if (!qFuzzyCompare(1.0 + fuel, 1.0 + m_fuelLevel)) {
            m_fuelLevel = fuel;
            emit fuelLevelChanged();
        }
        bool lowFuel = fuel < 0.25;
        if (lowFuel != m_lowFuelWarn) { m_lowFuelWarn = lowFuel; emit lowFuelWarnChanged(); }
        break;
    }
    case kMce18Base + 2: {                               // MCE18 frame @ Base ID+2: AIN8, DIN0-7 mask @ byte 2
        // Bit N = DIN N (assumed — datasheet doesn't spell out bit order).
        // DIN5 is left unassigned: cruise comes from the Syvecs stream
        // instead (see the 0x601 case above), not this expander. DIN6 is
        // also unassigned: the datasheet's Frequency-1 input reuses that
        // same pin (**TX Base ID+3, "Frequency 1 - DIN6"), so it's kept free
        // rather than double-booked. DIN7 is hazard — same treatment as
        // DIN0/DIN1 (leftInd/rightInd): confirmed a static "switch pressed"
        // level (on while engaged, off the instant it's cancelled), not the
        // flasher's own on/off waveform — so this is a plain pass-through
        // with no debounce/synthesis. The dash's visible blink is
        // synthesized from this level in QML instead (see main.qml's
        // blinkTimer) rather than read off the CAN signal directly.
        quint8 dinMask = d[2];
        bool leftInd = dinMask & (1 << 0);
        bool rightInd = dinMask & (1 << 1);
        bool axleLiftIn = dinMask & (1 << 2);
        bool lowBeamsIn = dinMask & (1 << 3);
        bool highBeamsIn = dinMask & (1 << 4);
        bool hazardIn = dinMask & (1 << 7);

        applyCanIndicator(IndLeft, leftInd);
        applyCanIndicator(IndRight, rightInd);
        if (axleLiftIn != m_axleLift) { m_axleLift = axleLiftIn; emit axleLiftChanged(); }
        if (lowBeamsIn != m_lowBeams) { m_lowBeams = lowBeamsIn; emit lowBeamsChanged(); }
        if (highBeamsIn != m_highBeams) { m_highBeams = highBeamsIn; emit highBeamsChanged(); }
        applyCanIndicator(IndHazard, hazardIn);
        break;
    }
    default:
        break;
    }
}

void CanBus::setTotalOdo(double v)
{
    if (qFuzzyCompare(1.0 + v, 1.0 + m_totalOdo))
        return;
    m_totalOdo = v;
    emit totalOdoChanged();
}

void CanBus::setTripOdo(double v)
{
    if (qFuzzyCompare(1.0 + v, 1.0 + m_tripOdo))
        return;
    m_tripOdo = v;
    emit tripOdoChanged();
}

void CanBus::save()
{
    if (!m_odo)
        return;
    m_odo->setTotalOdo(m_totalOdo);
    m_odo->setTripOdo(m_tripOdo);
    m_odo->save();
}

#if !defined(__linux__) || defined(ULTIMA_SIMULATE)
// Dev-build data simulator. Ports SimEngine.qml's phase-based driving
// profile (random city/stop/suburban/highway/spirited legs) onto CanBus's
// mph/°F/psi units so main.qml's gauges animate without real CAN hardware.
void CanBus::simulateTick()
{
    const double dt = 0.06; // matches m_simTimer interval (60 ms)
    const double kTwoPi = 6.283185307179586;
    auto rnd = []() { return QRandomGenerator::global()->generateDouble(); };

    m_simElapsedS += dt;

    // Headlights: toggle low beams on/off every 2s so the car art and
    // low-beam icon can be exercised without real CAN hardware. Skipped for
    // good once debugCycleHeadlights() sets m_simHeadlightsManualOverride —
    // see canbus.h's comment on it (same pattern as the gear auto-cycle).
    if (!m_simHeadlightsManualOverride) {
        bool lowBeams = std::fmod(m_simElapsedS, 4.0) < 2.0;
        if (lowBeams != m_lowBeams) { m_lowBeams = lowBeams; emit lowBeamsChanged(); }
    }

    // Cruise control: always engaged in the simulator so the icon can be
    // exercised without real CAN hardware.
    if (!m_cruiseControl) { m_cruiseControl = true; emit cruiseControlChanged(); }
    if (m_cruiseState != QStringLiteral("ACTIVE")) { m_cruiseState = QStringLiteral("ACTIVE"); emit cruiseStateChanged(); }

    // Transmission mode: flip Automatic/Manual every few seconds so the
    // gear indicator's A/M badge can be exercised without real CAN hardware.
    bool transmissionAuto = std::fmod(m_simElapsedS, 6.0) < 3.0;
    if (transmissionAuto != m_transmissionAuto) {
        m_transmissionAuto = transmissionAuto;
        emit transmissionAutoChanged();
    }

    // Drive mode: step through VALET -> SPORT -> SPORT+ -> RACE on a slow cycle so
    // the indicator can be exercised without real CAN hardware.
    static const QString driveModes[] = { QStringLiteral("VALET"), QStringLiteral("SPORT"), QStringLiteral("SPORT+"), QStringLiteral("RACE") };
    int driveModeIndex = int(std::fmod(m_simElapsedS / 5.0, 4.0));
    if (driveModes[driveModeIndex] != m_driveMode) {
        m_driveMode = driveModes[driveModeIndex];
        emit driveModeChanged();
    }

    // Fuel/coolant: sweep the full gauge range on independent slow sine
    // waves (real hardware doesn't broadcast fuel level at all, and
    // coolant only wanders a few degrees in practice — this is purely so
    // the gauges can be seen sweeping end-to-end during layout review).
    double fuelLevel = 0.5 + 0.5 * std::sin(kTwoPi * m_simElapsedS / 24.0);
    if (!qFuzzyCompare(1.0 + fuelLevel, 1.0 + m_fuelLevel)) {
        m_fuelLevel = fuelLevel;
        emit fuelLevelChanged();
    }
    bool lowFuelWarn = m_fuelLevel < 0.25;
    if (lowFuelWarn != m_lowFuelWarn) { m_lowFuelWarn = lowFuelWarn; emit lowFuelWarnChanged(); }

    m_simPhaseTimer -= dt;
    if (m_simPhaseTimer <= 0.0) {
        struct Phase { double target, dur; };
        const Phase phases[] = {
            { 20.0 + rnd() * 15.0,  8.0 + rnd() * 6.0  },  // city
            { 0.0,                  3.0 + rnd() * 3.0  },  // stop
            { 35.0 + rnd() * 20.0, 10.0 + rnd() * 8.0  },  // suburban
            { 55.0 + rnd() * 30.0, 12.0 + rnd() * 10.0 }, // highway
            { 75.0 + rnd() * 45.0,  8.0 + rnd() * 6.0  },  // spirited
        };
        const Phase &phase = phases[int(rnd() * 5)];
        m_simTargetSpeed = phase.target;
        m_simPhaseTimer = phase.dur;

        if (rnd() < 0.3) m_simOilFault = !m_simOilFault;
        if (!m_simLimpManualOverride && rnd() < 0.4) {
            m_checkEngine = !m_checkEngine;
            emit checkEngineChanged();
            int limp = m_checkEngine ? 1 : 0;
            if (limp != m_limpMode) { m_limpMode = limp; emit limpModeChanged(); }
        }
        if (rnd() < 0.3) m_simBattFault = !m_simBattFault;
    }

    accumulateOdometer(); // uses m_speed/timestamp from before this tick's update

    m_simAccel = (m_simTargetSpeed - m_speed) * 0.02;
    double noise = (rnd() - 0.5) * 0.6;
    double newSpeed = qBound(0.0, m_speed + m_simAccel + noise, 160.0);
    if (!qFuzzyCompare(1.0 + newSpeed, 1.0 + m_speed)) { m_speed = newSpeed; emit speedChanged(); }

    // Gear: cycle R N P 1..7 on a fixed timer (independent of simulated
    // speed) so the gear indicator and transmission-mode badge can be
    // exercised for every glyph without real CAN hardware. Values are
    // indices into "PRN1234567" (see canbus.h's gear Q_PROPERTY comment):
    // 0=P 1=R 2=N 3..9=1st..7th. Skipped for good once debugGearUp()/
    // debugGearDown() sets m_simGearManualOverride — see canbus.h's comment
    // on those.
    m_simGearCycleTimer -= dt;
    if (!m_simGearManualOverride && m_simGearCycleTimer <= 0.0) {
        static const int gearSequence[] = { 1, 2, 0, 3, 4, 5, 6, 7, 8, 9 };
        const int gearSequenceLen = int(sizeof(gearSequence) / sizeof(gearSequence[0]));
        int newGear = gearSequence[m_simGearCycleIndex];
        if (newGear != m_gear) { m_gear = newGear; emit gearChanged(); }
        m_simGearCycleIndex = (m_simGearCycleIndex + 1) % gearSequenceLen;
        m_simGearCycleTimer = 2.0;
    }

    double newRpm;
    if (m_gear < 3) {
        newRpm = 800.0 + rnd() * 100.0;
    } else {
        static const double ratios[] = { 0, 3.5, 2.5, 1.8, 1.4, 1.1, 0.9, 0.75 }; // [0] unused, [1..7]=1st..7th
        double base = m_speed * ratios[m_gear - 2] * 30.0;
        newRpm = qBound(800.0, base + (rnd() - 0.5) * 200.0, 7200.0);
    }
    if (!qFuzzyCompare(1.0 + newRpm, 1.0 + m_rpm)) { m_rpm = newRpm; emit rpmChanged(); }

    double targetCoolant = 200.0 + 40.0 * std::sin(kTwoPi * m_simElapsedS / 30.0) + (rnd() - 0.5) * 2.0;
    double newCoolant = m_coolantTempF + (targetCoolant - m_coolantTempF) * 0.01;
    if (!qFuzzyCompare(1.0 + newCoolant, 1.0 + m_coolantTempF)) {
        m_coolantTempF = newCoolant;
        emit coolantTempChanged();
    }
    bool coolantWarn = m_coolantTempF > 220.0;
    if (coolantWarn != m_coolantWarn) { m_coolantWarn = coolantWarn; emit coolantWarnChanged(); }

    double boostTarget = 0.0;
    if (m_speed > 20.0 && m_simAccel > 0.0)
        boostTarget = qMin(20.0, m_simAccel * 200.0 + m_rpm / 300.0);
    double newBoost = m_boostPsi + (boostTarget - m_boostPsi) * 0.05;
    if (!qFuzzyCompare(1.0 + newBoost, 1.0 + m_boostPsi)) { m_boostPsi = newBoost; emit boostChanged(); }

    // Oil pressure: rises with rpm, same threshold decodeFrame() uses to
    // derive the warn boolean (rpm >= 600 && psi <= 40) — m_simOilFault
    // (flipped in the phase-random block above) forces a dip so the warn
    // icon can still be exercised without real CAN hardware.
    double targetOilPressure = 40.0 + (m_rpm / 7200.0) * 50.0;
    if (m_simOilFault) targetOilPressure *= 0.3;
    if (!qFuzzyCompare(1.0 + targetOilPressure, 1.0 + m_oilPressurePsi)) {
        m_oilPressurePsi = targetOilPressure;
        emit oilPressureChanged();
    }
    bool oilWarn = (m_rpm >= 600.0) && (m_oilPressurePsi <= 40.0);
    if (oilWarn != m_oilPressureWarn) { m_oilPressureWarn = oilWarn; emit oilPressureWarnChanged(); }

    // Battery voltage: steady alternator output, same 12.5V threshold
    // decodeFrame() uses — m_simBattFault forces a dip to exercise the warn
    // icon.
    double targetVbat = m_simBattFault ? 11.8 : 13.8;
    double newVbat = m_vbat + (targetVbat - m_vbat) * 0.1;
    if (!qFuzzyCompare(1.0 + newVbat, 1.0 + m_vbat)) { m_vbat = newVbat; emit vbatChanged(); }
    bool battWarn = m_vbat < 12.5;
    if (battWarn != m_batteryWarn) { m_batteryWarn = battWarn; emit batteryWarnChanged(); }
}
#endif

// Not simulate-only — see the Q_INVOKABLE declarations in canbus.h for why
// these must work on every build, real hardware included. Plain level
// flips, matching real CAN's DIN pass-through (decodeFrame()'s
// kMce18Base+2 case) — the visible blink is synthesized from the level in
// QML (main.qml's blinkTimer), not here.
void CanBus::setIndicatorLevel(int i, bool v)
{
    IndicatorSlot &s = m_ind[i];
    if (*s.level == v)
        return;
    *s.level = v;
    emit (this->*s.changed)();
}

// CAN side: always remember the real level. A debug-key latch holds the
// visible level until CAN actually *changes* this signal (the real
// stalk/hazard switch moved), then hands control back; repeats of the same
// level — the normal MCE18 stream — never release it.
void CanBus::applyCanIndicator(int i, bool canLevel)
{
    IndicatorSlot &s = m_ind[i];
    const bool edge = canLevel != s.canLevel;
    s.canLevel = canLevel;
    if (s.overridden) {
        if (!edge)
            return;
        s.overridden = false;
    }
    setIndicatorLevel(i, canLevel);
}

// Debug-key side: flip the visible level and latch it so CAN can't revert it.
void CanBus::toggleIndicatorOverride(int i)
{
    IndicatorSlot &s = m_ind[i];
    s.overridden = true;
    setIndicatorLevel(i, !*s.level);
}

void CanBus::debugToggleLeftIndicator()  { toggleIndicatorOverride(IndLeft); }
void CanBus::debugToggleRightIndicator() { toggleIndicatorOverride(IndRight); }
void CanBus::debugToggleHazard()         { toggleIndicatorOverride(IndHazard); }

void CanBus::debugGearUp()
{
    int newGear = qBound(0, m_gear + 1, 9);
#if !defined(__linux__) || defined(ULTIMA_SIMULATE)
    m_simGearManualOverride = true;
#endif
    if (newGear != m_gear) { m_gear = newGear; emit gearChanged(); }
}

void CanBus::debugGearDown()
{
    int newGear = qBound(0, m_gear - 1, 9);
#if !defined(__linux__) || defined(ULTIMA_SIMULATE)
    m_simGearManualOverride = true;
#endif
    if (newGear != m_gear) { m_gear = newGear; emit gearChanged(); }
}

// off -> low -> high -> off, mutually exclusive (see canbus.h's comment on
// why this doesn't layer high beams on top of low beams).
void CanBus::debugCycleHeadlights()
{
#if !defined(__linux__) || defined(ULTIMA_SIMULATE)
    m_simHeadlightsManualOverride = true;
#endif
    bool newLow = m_lowBeams;
    bool newHigh = m_highBeams;
    if (!m_lowBeams && !m_highBeams) {
        newLow = true;
    } else if (m_lowBeams) {
        newLow = false;
        newHigh = true;
    } else {
        newHigh = false;
    }
    if (newLow != m_lowBeams) { m_lowBeams = newLow; emit lowBeamsChanged(); }
    if (newHigh != m_highBeams) { m_highBeams = newHigh; emit highBeamsChanged(); }
}

// Next code in kLimpModes above the current one, wrapping to 0 (OFF) after
// the last. Comparing by value rather than by index also handles a
// m_limpMode that isn't in the table (an unknown code off real CAN).
void CanBus::debugCycleLimpMode()
{
#if !defined(__linux__) || defined(ULTIMA_SIMULATE)
    m_simLimpManualOverride = true;
#endif
    int next = kLimpModes[0].code;
    for (const LimpModeEntry &e : kLimpModes) {
        if (e.code > m_limpMode) { next = e.code; break; }
    }
    if (next != m_limpMode) { m_limpMode = next; emit limpModeChanged(); }
    // Same derivation as decodeFrame()'s 0x604 case.
    bool ce = (m_limpMode != 0);
    if (ce != m_checkEngine) { m_checkEngine = ce; emit checkEngineChanged(); }
}

void CanBus::debugToggleSim()
{
#if !defined(__linux__) || defined(ULTIMA_SIMULATE)
    // start() with no argument reuses the 60 ms interval tryConnect() set.
    if (m_simTimer.isActive()) m_simTimer.stop(); else m_simTimer.start();
    fprintf(stderr, "[canbus] simulation %s\n", m_simTimer.isActive() ? "resumed" : "paused");
#endif
}
