joshellissh/UltimaGC/ultima-app/camerafeed.cpp

#include "camerafeed.h"
#include "mediagraph.h"

#include <QtGlobal>
#include <QThread>
#include <QMutexLocker>
#include <QMetaObject>
#include <stdio.h>
#include <string.h>

#if !defined(__linux__) || defined(ULTIMA_SIMULATE)
#include <QPainter>
#include <QFont>
#include <QRandomGenerator>
#include <cmath>
#endif

#ifdef __linux__
#include <sys/ioctl.h>
#include <sys/mman.h>
#include <fcntl.h>
#include <unistd.h>
#include <errno.h>
#include <poll.h>
#include <linux/videodev2.h>
#endif

#if defined(__linux__) && !defined(ULTIMA_SIMULATE)
#include "wave5encoder.h"
#include <algorithm>
#endif

// Requested capture format: UYVY 1920x1080. The NVP6324 forces every AHD
// channel to 1080p (UYVY, not YUYV — the N4 decoder emits UYVY byte order;
// decoding it as YUYV is the green/magenta mess). S_FMT is a negotiation, so
// the code below reads back whatever the driver actually granted
// (m_captureWidth/m_captureHeight/m_bytesPerLine/field) rather than assuming
// these requested values landed.
static constexpr int kRequestedWidth = 1920;
static constexpr int kRequestedHeight = 1080;

CameraFeed::CameraFeed(const QString &label, int vc, QObject *parent)
    : QObject(parent), m_label(label), m_vc(vc)
{
    m_fpsLogEnabled = qEnvironmentVariableIsSet("ULTIMA_CAM_FPS_LOG");
    // Zero-copy display is the default on the real capture path — see the
    // class comment and GAUGE-CLUSTER.md "Camera framerate". ULTIMA_CAM_ZEROCOPY=0
    // is the escape hatch that forces everything through the converted-
    // QImage path (useful A/B lever, and the fallback if this ever runs on
    // a GPU stack without dma-buf import).
    const QByteArray zc = qgetenv("ULTIMA_CAM_ZEROCOPY");
    m_zeroCopy = zc.isEmpty() ? true : (zc.toInt() != 0);
#if !defined(__linux__) || defined(ULTIMA_SIMULATE)
    m_zeroCopy = false; // simulated frames are QImages; there is no V4L2 buffer to lend
#endif
    for (int i = 0; i < kMaxBuffers; ++i) {
        m_dmabufFds[i] = -1;
        m_bufRefs[i] = 0;
    }
    m_reconnectTimer.setInterval(1000);
    connect(&m_reconnectTimer, &QTimer::timeout, this, &CameraFeed::tryOpen);
    // Deliberately NOT calling tryOpen() here — the device stays closed
    // until setActive(true), driven by the camera screens opening. See the
    // class comment in camerafeed.h.
}

CameraFeed::~CameraFeed()
{
    closeDevice();
}

void CameraFeed::setActive(bool on)
{
    if (on == m_active)
        return;
    m_active = on;
    emit activeChanged();
    updateOpenState();
}

void CameraFeed::configureRecording(const QString &root, int bitrateBps, int gop, int segSeconds)
{
    m_recordRoot = root.toStdString();
    m_recordBitrate = bitrateBps;
    m_recordGop = gop;
    m_recordSegSecs = segSeconds;
}

void CameraFeed::setRecording(bool on)
{
    const int prev = m_recordActive.fetchAndStoreRelease(on ? 1 : 0);
    if ((prev != 0) == on)
        return;              // no change
    updateOpenState();       // the capture thread notices the flag itself
}

void CameraFeed::updateOpenState()
{
    // Keep the device open while either the display (setActive, from the camera
    // screens) or recording (setRecording, from DashcamRecorder) wants frames;
    // close only when neither does. The capture thread, once running, starts or
    // tears down the encoder on its own by watching m_recordActive.
    const bool want = m_active || m_recordActive.loadAcquire();
#if defined(__linux__) && !defined(ULTIMA_SIMULATE)
    if (want) {
        if (m_fd < 0) {
            setFailed(false);
            tryOpen();
        }
    } else if (m_fd >= 0) {
        m_reconnectTimer.stop();
        m_reconnectIntervalMs = 1000; // start fresh next time this feed reopens
        closeDevice();
        m_frame = QImage(); // don't serve a stale frame across a close/open cycle
        setStreaming(false);
    }
#else
    if (want) {
        setFailed(false);
        connect(&m_simTimer, &QTimer::timeout, this, &CameraFeed::simulateTick,
                Qt::UniqueConnection);
        m_simTimer.start(33); // ~30fps, matches the real grabber's default rate
    } else {
        m_simTimer.stop();
        setStreaming(false);
    }
#endif
}

void CameraFeed::setStreaming(bool on)
{
    if (on == m_streaming)
        return;
    m_streaming = on;
    emit streamingChanged();
}

void CameraFeed::setFailed(bool on)
{
    if (on == m_failed)
        return;
    m_failed = on;
    emit failedChanged();
}

// A permanently-absent/non-streaming feed (e.g. a VC with no camera wired to
// its AHD input — today only VC0 is populated) used to retry tryOpen() every
// flat 1s forever. With multiple such feeds active at once (the camera screens
// activate all 4 unconditionally, regardless of which cameras currently work),
// that's several failed resolve+open+ioctl cycles per second competing for the
// same GUI thread. Exponential backoff (capped, reset to base on the next
// successful stream) keeps a genuinely-dead feed from costing much after the
// first few seconds, while still reconnecting promptly if the camera comes back
// (e.g. a cable reseated, or another AHD channel gets populated).
void CameraFeed::scheduleReconnect()
{
    static constexpr int kMaxReconnectIntervalMs = 8000;
    m_reconnectTimer.setInterval(m_reconnectIntervalMs);
    m_reconnectTimer.start();
    m_reconnectIntervalMs = m_reconnectIntervalMs * 2 < kMaxReconnectIntervalMs
                                 ? m_reconnectIntervalMs * 2 : kMaxReconnectIntervalMs;
}

// ---- Zero-copy buffer mailbox --------------------------------------------
//
// The capture thread publishes the newest DQBUF'd buffer index; renderers
// (grid tiles, mirror overlays — possibly several per feed) acquire it with
// a reference during the scene-graph sync phase and release it when they
// move on to a newer one. A buffer goes onto m_retired — and from there
// back to the driver via VIDIOC_QBUF, always on the capture thread — only
// once it is BOTH superseded and unreferenced. Renderers hold their
// current AND previous buffer (see dmabuftexture.cpp) so the driver can
// never DMA into memory the GPU may still be scanning for the in-flight
// frame.

int CameraFeed::dmabufFd(int index) const
{
    QMutexLocker lock(&m_bufMutex);
    return (index >= 0 && index < kMaxBuffers) ? m_dmabufFds[index] : -1;
}

quint32 CameraFeed::bufferSession() const
{
    QMutexLocker lock(&m_bufMutex);
    return m_bufSession;
}

int CameraFeed::acquireLatestBuffer(quint32 *generation, quint32 *session)
{
    QMutexLocker lock(&m_bufMutex);
    if (m_pendingIndex < 0 || *generation == m_pendingGen)
        return -1;
    *generation = m_pendingGen;
    *session = m_bufSession;
    ++m_bufRefs[m_pendingIndex];
    m_pendingAcquired = true;
    return m_pendingIndex;
}

void CameraFeed::releaseBuffer(int index, quint32 session)
{
    QMutexLocker lock(&m_bufMutex);
    if (index < 0 || index >= kMaxBuffers || session != m_bufSession)
        return; // stale handle from a previous stream — nothing to give back
    if (m_bufRefs[index] > 0 && --m_bufRefs[index] == 0 && index != m_pendingIndex)
        m_retired.append(index);
}

void CameraFeed::publishBuffer(int index)
{
    QMutexLocker lock(&m_bufMutex);
    if (m_pendingIndex >= 0 && m_pendingIndex != index) {
        // Superseded. Never displayed, or displayed and since released by
        // everyone: retire it here. Otherwise releaseBuffer() retires it
        // when the last renderer lets go.
        if (!m_pendingAcquired || m_bufRefs[m_pendingIndex] == 0)
            m_retired.append(m_pendingIndex);
    }
    m_pendingIndex = index;
    m_pendingAcquired = false;
    ++m_pendingGen;
}

QVector<int> CameraFeed::takeRetiredBuffers()
{
    QMutexLocker lock(&m_bufMutex);
    QVector<int> r;
    r.swap(m_retired);
    return r;
}

void CameraFeed::resetBufferMailbox()
{
    QMutexLocker lock(&m_bufMutex);
    m_pendingIndex = -1;
    m_pendingAcquired = false;
    m_retired.clear();
    for (int i = 0; i < kMaxBuffers; ++i)
        m_bufRefs[i] = 0;
    ++m_bufSession; // outstanding handles (and any EGLImports of them) are now stale
}

#if defined(__linux__) && !defined(ULTIMA_SIMULATE)

// Decode/expose converted frames at 1/kDecimation the driver-granted
// capture size — real-hardware profiling (see GAUGE-CLUSTER.md
// "Camera frame paths") found full-res conversion+upload spending most of its cost on
// pixels thrown away by the eventual on-screen downscale. Only affects the
// converted-QImage path; the zero-copy path displays the full capture
// resolution (the GPU minifies while sampling).
static constexpr int kDecimation = 2;

// UYVY -> RGBA8888, standard BT.601 integer coefficients, decimating by
// rowStep/colStep pixel-PAIRS (never splitting a pair keeps every read
// aligned to UYVY's 4-byte/2-pixel chroma grouping). bytesPerLine is the
// driver-granted V4L2 stride, NOT assumed to be width*2 — walking rows past
// the real stride would read off the end of the buffer (see tryOpen()).
//
// Portable scalar fallback — the NEON version below is what the target
// actually runs. Kept bit-compatible in structure (not bit-exact: the NEON
// coefficients are the same values halved for int16 headroom, ~0.4% off).
static inline quint8 clamp255(int v) { return quint8(v < 0 ? 0 : (v > 255 ? 255 : v)); }

static void convertUYVYToRGBA8888(const uchar *src, QImage &dst, int dstWidth, int dstHeight,
                                   int bytesPerLine, int rowStep, int colStep)
{
    for (int y = 0; y < dstHeight; ++y) {
        const uchar *row = src + size_t(y) * rowStep * bytesPerLine;
        uchar *out = dst.scanLine(y);
        for (int x = 0; x < dstWidth; x += 2) {
            const uchar *px = row + size_t(x / 2) * colStep * 4;
            int u = px[0] - 128, y0 = px[1], v = px[2] - 128, y1 = px[3];

            int rUV = (359 * v) >> 8;
            int gUV = (88 * u + 183 * v) >> 8;
            int bUV = (454 * u) >> 8;

            uchar *p0 = out + size_t(x) * 4;
            p0[0] = clamp255(y0 + rUV);
            p0[1] = clamp255(y0 - gUV);
            p0[2] = clamp255(y0 + bUV);
            p0[3] = 255;
            if (x + 1 < dstWidth) {
                uchar *p1 = p0 + 4;
                p1[0] = clamp255(y1 + rUV);
                p1[1] = clamp255(y1 - gUV);
                p1[2] = clamp255(y1 + bUV);
                p1[3] = 255;
            }
        }
    }
}

#if defined(__ARM_NEON) || defined(__aarch64__)
#include <arm_neon.h>
// NEON UYVY->RGBA8888 with fixed column decimation 2. Each iteration pulls
// 64 contiguous source bytes (16 UYVY pixel pairs) with ONE vld4q_u8 —
// de-interleaved straight into U / Y0 / V / Y1 lanes — keeps every other
// pair (8 pairs = 16 output pixels) and writes 64 output bytes with one
// vst4q_u8. Hardware-measured at ~3.6ms/frame vs the scalar loop's ~8.9ms
// from cached buffers — and this wide-load shape is also what makes the
// conversion survivable at all if the buffers ever come back uncached (see
// the NON_COHERENT note in tryOpen(): on an uncached mapping every load is a
// DRAM round-trip regardless of width, so 64-byte loads vs the scalar path's
// 1-byte loads is the difference between 64ms and 240ms a frame). Coefficients
// are the scalar path's halved with >>7 instead of >>8 so the intermediates
// fit int16 lanes (359*127 doesn't).
static void convertUYVYToRGBA8888Neon(const uchar *src, QImage &dst, int dstWidth, int dstHeight,
                                       int bytesPerLine, int rowStep)
{
    const int16x8_t c128 = vdupq_n_s16(128);
    const int16x8_t cR = vdupq_n_s16(179);   // 359/2
    const int16x8_t cGu = vdupq_n_s16(44);   // 88/2
    const int16x8_t cGv = vdupq_n_s16(91);   // 183/2 (rounded down)
    const int16x8_t cB = vdupq_n_s16(227);   // 454/2
    const uint8x16_t alpha = vdupq_n_u8(255);
    const int vecWidth = dstWidth & ~15;
    for (int y = 0; y < dstHeight; ++y) {
        const uchar *row = src + size_t(y) * rowStep * bytesPerLine;
        uchar *out = dst.scanLine(y);
        int x = 0;
        for (; x < vecWidth; x += 16) {
            // 16 source pairs (64 bytes) -> keep even-indexed pairs (8).
            uint8x16x4_t q = vld4q_u8(row + size_t(x) * 4); // x px out = 2x px in = 4x bytes
            uint8x8_t U  = vget_low_u8(vuzp1q_u8(q.val[0], q.val[0]));
            uint8x8_t Y0 = vget_low_u8(vuzp1q_u8(q.val[1], q.val[1]));
            uint8x8_t V  = vget_low_u8(vuzp1q_u8(q.val[2], q.val[2]));
            uint8x8_t Y1 = vget_low_u8(vuzp1q_u8(q.val[3], q.val[3]));

            int16x8_t u = vsubq_s16(vreinterpretq_s16_u16(vmovl_u8(U)), c128);
            int16x8_t v = vsubq_s16(vreinterpretq_s16_u16(vmovl_u8(V)), c128);
            int16x8_t y0 = vreinterpretq_s16_u16(vmovl_u8(Y0));
            int16x8_t y1 = vreinterpretq_s16_u16(vmovl_u8(Y1));

            int16x8_t rUV = vshrq_n_s16(vmulq_s16(cR, v), 7);
            int16x8_t gUV = vshrq_n_s16(vaddq_s16(vmulq_s16(cGu, u), vmulq_s16(cGv, v)), 7);
            int16x8_t bUV = vshrq_n_s16(vmulq_s16(cB, u), 7);

            uint8x8_t r0 = vqmovun_s16(vaddq_s16(y0, rUV));
            uint8x8_t g0 = vqmovun_s16(vsubq_s16(y0, gUV));
            uint8x8_t b0 = vqmovun_s16(vaddq_s16(y0, bUV));
            uint8x8_t r1 = vqmovun_s16(vaddq_s16(y1, rUV));
            uint8x8_t g1 = vqmovun_s16(vsubq_s16(y1, gUV));
            uint8x8_t b1 = vqmovun_s16(vaddq_s16(y1, bUV));

            // Interleave even/odd pixels of each pair back into raster order.
            uint8x16x4_t o;
            o.val[0] = vcombine_u8(vzip1_u8(r0, r1), vzip2_u8(r0, r1));
            o.val[1] = vcombine_u8(vzip1_u8(g0, g1), vzip2_u8(g0, g1));
            o.val[2] = vcombine_u8(vzip1_u8(b0, b1), vzip2_u8(b0, b1));
            o.val[3] = alpha;
            vst4q_u8(out + size_t(x) * 4, o);
        }
        // Scalar tail for widths that aren't a multiple of 16.
        if (x < dstWidth) {
            const uchar *tailRow = row;
            uchar *tailOut = out;
            for (; x < dstWidth; x += 2) {
                const uchar *px = tailRow + size_t(x / 2) * 2 * 4;
                int u = px[0] - 128, y0 = px[1], v = px[2] - 128, y1 = px[3];
                int rUV = (359 * v) >> 8, gUV = (88 * u + 183 * v) >> 8, bUV = (454 * u) >> 8;
                uchar *p0 = tailOut + size_t(x) * 4;
                p0[0] = clamp255(y0 + rUV); p0[1] = clamp255(y0 - gUV); p0[2] = clamp255(y0 + bUV); p0[3] = 255;
                if (x + 1 < dstWidth) {
                    uchar *p1 = p0 + 4;
                    p1[0] = clamp255(y1 + rUV); p1[1] = clamp255(y1 - gUV); p1[2] = clamp255(y1 + bUV); p1[3] = 255;
                }
            }
        }
    }
}
#define ULTIMA_HAVE_NEON 1
#endif

// Median absolute horizontal slip between adjacent luma rows over a central
// band — an image-quality probe kept for observability (logged under
// ULTIMA_CAM_FPS_LOG). A clean progressive lock reads ~0; a sheared decoder
// lock reads a few px. It flagged the 1242-Mbps MIPI eye problem on this
// board; the current VC0 build runs 594 Mbps clean, but the 4-camera build
// goes back to 1242, so keep the measurement. Luma byte for pixel x is at
// 2*x+1 in UYVY. Cheap: ~40 row-pairs x a small SAD search, every few frames.
static int measureRowSlip(const uchar *src, int width, int height, int bytesPerLine)
{
    const int x0 = width / 4, x1 = width * 3 / 4;
    const int maxShift = 8;
    if (x1 - x0 <= 2 * maxShift || height < 16 || bytesPerLine < 2 * (x1 + maxShift) + 2)
        return 0;
    const int wantPairs = 40;
    const int step = height / (wantPairs + 2);
    if (step < 1)
        return 0;
    int mags[wantPairs];
    int n = 0;
    for (int p = 1; p <= wantPairs; ++p) {
        const int y = p * step;
        if (y + 1 >= height)
            break;
        const uchar *r0 = src + size_t(y) * bytesPerLine;
        const uchar *r1 = src + size_t(y + 1) * bytesPerLine;
        long best = 1L << 30;
        int bestS = 0;
        for (int s = -maxShift; s <= maxShift; ++s) {
            long sad = 0;
            for (int x = x0; x < x1; x += 2) {
                const int a = r0[2 * x + 1];
                const int b = r1[2 * (x + s) + 1];
                sad += a > b ? a - b : b - a;
            }
            if (sad < best) { best = sad; bestS = s; }
        }
        mags[n++] = bestS < 0 ? -bestS : bestS;
    }
    if (n == 0)
        return 0;
    std::nth_element(mags, mags + n / 2, mags + n);
    return mags[n / 2];
}

// Per-feed capture thread. Owns nothing: the fd and mmap'd buffers stay
// with CameraFeed (opened/closed on the GUI thread); this thread polls the
// fd, DQBUFs with a drain-all-take-newest policy (capture can outpace
// display; converting frames that would be overwritten before ever being
// shown is pure waste), then:
//   - zero-copy path: publishes the buffer index to the mailbox and
//     requeues whatever the renderers have retired;
//   - converted path (zero-copy off, or a frame consumer registered):
//     decodes UYVY->RGBA and requeues the buffer immediately.
// Converted frames reach the GUI thread through a latest-frame mailbox
// rather than a queued signal per frame: if the GUI thread is blocked
// (e.g. waiting on the render thread's sync), frames overwrite each other
// here instead of piling up in the event queue as 2MB QImages.
class CameraCaptureThread : public QThread {
public:
    // Decoder-lock shear check cadence (see measureRowSlip()).
    static constexpr int kSlipCheckEvery = 5;      // ~5 checks/s at 25fps

    CameraCaptureThread(CameraFeed *feed, int fd, bool fpsLog)
        : m_feed(feed), m_fd(fd), m_fpsLog(fpsLog) {}

    ~CameraCaptureThread()
    {
        // Clean encoder teardown (STREAMOFF). This runs on the GUI thread from
        // closeDevice(), which has already requestStop()+wait()'d this capture
        // thread, so there is no concurrent access to the encoder. An unclean
        // stop can wedge the VPU firmware (see wave5encoder.cpp / DASHCAM.md).
        if (m_encoder)
            m_encoder->stop();
        delete m_encoder;
        delete m_segWriter;   // ~SegmentWriter flushes + fsyncs the last segment
    }

    void requestStop() { m_stop.storeRelease(1); }

    QImage takeLatest() {
        QMutexLocker lock(&m_mutex);
        QImage f = m_latest;
        m_latest = QImage();
        m_notifyPending.storeRelease(0);
        return f;
    }

protected:
    void run() override {
        while (!m_stop.loadAcquire()) {
            struct pollfd pfd;
            pfd.fd = m_fd; pfd.events = POLLIN; pfd.revents = 0;
            int r = ::poll(&pfd, 1, 100);
            if (r < 0 && errno == EINTR) continue;
            if (r <= 0) continue;
            if (m_stop.loadAcquire()) break;

            bool havePending = false;
            struct v4l2_buffer pending;
            memset(&pending, 0, sizeof(pending));
            for (;;) {
                struct v4l2_buffer buf;
                memset(&buf, 0, sizeof(buf));
                buf.type = V4L2_BUF_TYPE_VIDEO_CAPTURE;
                buf.memory = V4L2_MEMORY_MMAP;
                if (::ioctl(m_fd, VIDIOC_DQBUF, &buf) < 0) {
                    if (errno == EAGAIN)
                        break;
                    fprintf(stderr, "[camerafeed] %s VIDIOC_DQBUF: %s — reconnecting\n",
                            qPrintable(m_feed->m_label), strerror(errno));
                    QMetaObject::invokeMethod(m_feed, "onWorkerError", Qt::QueuedConnection);
                    return; // the GUI thread will closeDevice() and wait() on us
                }
                if (havePending)
                    ::ioctl(m_fd, VIDIOC_QBUF, &pending); // superseded before we ever looked at it
                pending = buf;
                havePending = true;
            }
            if (!havePending)
                continue;

            const bool zeroCopy = m_feed->m_zeroCopy;
            const bool wantImage = !zeroCopy || m_feed->m_frameConsumers.loadAcquire() > 0;

            // bytesused guard: a short buffer (driver bug, or a mid-stream
            // format change this code doesn't handle) would otherwise show
            // partly-stale rows from a previous frame's leftover contents.
            const bool complete = pending.index < quint32(m_feed->m_numBuffersMapped)
                && m_feed->m_bytesPerLine > 0
                && pending.bytesused >= quint32(m_feed->m_bytesPerLine) * quint32(m_feed->m_captureHeight);

            // Decoder-lock shear observability (see measureRowSlip()). Only the
            // real capture path delivers complete frames. Measurement only —
            // the mycam004m sysfs "relock" poke that used to hang off this is
            // gone (the NVP6324 driver has no such attr, and the shear it
            // chased was fixed in-driver at 594 Mbps).
            if (complete && m_fpsLog && ++m_framesSinceSlipCheck >= kSlipCheckEvery) {
                m_framesSinceSlipCheck = 0;
                const uchar *src = static_cast<const uchar *>(
                    m_feed->m_buffers[pending.index].start);
                const int slip = measureRowSlip(src, m_feed->m_captureWidth,
                                                m_feed->m_captureHeight,
                                                m_feed->m_bytesPerLine);
                fprintf(stderr, "[camerafeed] %s: slip=%d px/line\n",
                        qPrintable(m_feed->m_label), slip);
            }

            if (complete && wantImage) {
                QImage frame(m_feed->m_frameWidth, m_feed->m_frameHeight, QImage::Format_RGBA8888);
                const uchar *src = static_cast<const uchar *>(m_feed->m_buffers[pending.index].start);
#ifdef ULTIMA_HAVE_NEON
                convertUYVYToRGBA8888Neon(src, frame, m_feed->m_frameWidth, m_feed->m_frameHeight,
                                          m_feed->m_bytesPerLine, kDecimation);
#else
                convertUYVYToRGBA8888(src, frame, m_feed->m_frameWidth, m_feed->m_frameHeight,
                                      m_feed->m_bytesPerLine, kDecimation, kDecimation);
#endif
                {
                    QMutexLocker lock(&m_mutex);
                    m_latest = frame;
                }
            }

            // Dashcam recording. Runs BEFORE the zero-copy publish/requeue
            // below for the reason the old spike did: in the non-zero-copy case
            // the buffer is handed back to the driver immediately after this, so
            // the frame must be copied into the encoder here first. The encoder
            // + segment writer are created lazily on the first complete frame,
            // so a virtual channel with no camera never opens a VPU instance.
            const bool wantRecord = complete && m_feed->m_recordActive.loadAcquire();
            if (wantRecord && !m_recordStartFailed) {
                if (!m_encoder) {
                    m_encoder = new Wave5Encoder();
                    m_segWriter = new SegmentWriter(m_feed->m_recordRoot,
                                                    m_feed->m_label.toStdString(),
                                                    m_feed->m_recordSegSecs);
                    SegmentWriter *sw = m_segWriter;
                    Wave5Encoder::Sink sink = [sw](const uint8_t *d, size_t n, bool key) {
                        sw->write(d, n, key);
                    };
                    if (!m_encoder->start(m_feed->m_captureWidth, m_feed->m_captureHeight,
                                          m_feed->m_bytesPerLine, m_feed->m_recordBitrate,
                                          m_feed->m_recordGop, sink)) {
                        delete m_encoder; m_encoder = nullptr;
                        delete m_segWriter; m_segWriter = nullptr;
                        m_recordStartFailed = true; // retried on the next device (re)open
                        fprintf(stderr, "[camerafeed] %s: recording disabled (encoder start failed)\n",
                                qPrintable(m_feed->m_label));
                    } else {
                        fprintf(stderr, "[camerafeed] %s: recording to %s\n",
                                qPrintable(m_feed->m_label), m_feed->m_recordRoot.c_str());
                    }
                }
                if (m_encoder) {
                    const uchar *src = static_cast<const uchar *>(m_feed->m_buffers[pending.index].start);
                    if (!m_encoder->submit(src, m_feed->m_bytesPerLine, m_feed->m_captureHeight)) {
                        m_encoder->stop(); delete m_encoder; m_encoder = nullptr;
                        delete m_segWriter; m_segWriter = nullptr;
                        m_recordStartFailed = true;
                    }
                }
            } else if (m_encoder && !m_feed->m_recordActive.loadAcquire()) {
                // Recording turned off mid-stream (e.g. drive unplugged) — clean teardown.
                m_encoder->stop(); delete m_encoder; m_encoder = nullptr;
                delete m_segWriter; m_segWriter = nullptr;
            }

            if (complete && zeroCopy) {
                m_feed->publishBuffer(int(pending.index));
            } else {
                ::ioctl(m_fd, VIDIOC_QBUF, &pending);
            }
            if (complete && m_notifyPending.testAndSetAcquire(0, 1))
                QMetaObject::invokeMethod(m_feed, "onWorkerFrame", Qt::QueuedConnection);

            if (zeroCopy) {
                const QVector<int> retired = m_feed->takeRetiredBuffers();
                for (int idx : retired) {
                    struct v4l2_buffer rb;
                    memset(&rb, 0, sizeof(rb));
                    rb.type = V4L2_BUF_TYPE_VIDEO_CAPTURE;
                    rb.memory = V4L2_MEMORY_MMAP;
                    rb.index = quint32(idx);
                    if (::ioctl(m_fd, VIDIOC_QBUF, &rb) < 0)
                        fprintf(stderr, "[camerafeed] requeue[%d]: %s\n", idx, strerror(errno));
                }
            }
        }
    }

private:
    CameraFeed *m_feed;
    int m_fd;
    bool m_fpsLog;
    QAtomicInt m_stop{0};
    QAtomicInt m_notifyPending{0};
    QMutex m_mutex;
    QImage m_latest;
    int m_framesSinceSlipCheck = 0;

    // Dashcam recording — capture-thread-local (nothing outside this thread
    // touches these). Created lazily on the first real frame when
    // m_feed->m_recordActive; torn down on stop/close. See the record block in
    // run() and wave5encoder.h.
    Wave5Encoder *m_encoder = nullptr;
    SegmentWriter *m_segWriter = nullptr;
    bool m_recordStartFailed = false;  // don't hammer a wedged VPU within a session
};

void CameraFeed::onWorkerFrame()
{
    if (!m_captureThread)
        return;
    QImage f = m_captureThread->takeLatest();
    if (!f.isNull())
        m_frame = f; // GUI thread — see currentFrame()'s threading note
    setStreaming(true);
    emit frameReady();
}

void CameraFeed::onWorkerError()
{
    closeDevice();
    setStreaming(false);
    scheduleReconnect();
}

void CameraFeed::unmapBuffers()
{
    for (int i = 0; i < m_numBuffersMapped; ++i) {
        if (m_buffers[i].start && m_buffers[i].start != MAP_FAILED)
            ::munmap(m_buffers[i].start, m_buffers[i].length);
        m_buffers[i] = MappedBuffer();
    }
    m_numBuffersMapped = 0;
}

void CameraFeed::closeDevice()
{
    if (m_captureThread) {
        m_captureThread->requestStop();
        m_captureThread->wait();
        delete m_captureThread;
        m_captureThread = nullptr;
    }
    if (m_fd >= 0) {
        v4l2_buf_type type = V4L2_BUF_TYPE_VIDEO_CAPTURE;
        ::ioctl(m_fd, VIDIOC_STREAMOFF, &type); // best-effort
        unmapBuffers();
        ::close(m_fd);
        m_fd = -1;
    }
    // The exported fds are closed here, but an EGLImage a renderer still
    // holds keeps the underlying buffer memory alive (dma-buf refcount)
    // until DmaBufTextureSet notices the session bump below and drops it —
    // see dmabuftexture.cpp for how that resolves against CMA pressure.
    for (int i = 0; i < kMaxBuffers; ++i) {
        if (m_dmabufFds[i] >= 0) {
            ::close(m_dmabufFds[i]);
            m_dmabufFds[i] = -1;
        }
    }
    resetBufferMailbox();
}

void CameraFeed::tryOpen()
{
    if (!(m_active || m_recordActive.loadAcquire()) || m_fd >= 0)
        return;

    // Resolve the capture node from the media graph for this feed's virtual
    // channel — the /dev/videoN number is not stable (see mediagraph.h). Done
    // per-open so a reconnect re-resolves (a graph rebuild renumbers nodes).
    QString diag;
    m_device = MediaGraph::resolveCsiCaptureNode(m_vc, &diag);
    if (m_device.isEmpty()) {
        fprintf(stderr, "[camerafeed] %s: no capture node for VC%d (%s)\n",
                qPrintable(m_label), m_vc, qPrintable(diag));
        scheduleReconnect();
        return;
    }

    int fd = ::open(m_device.toLocal8Bit().constData(), O_RDWR | O_NONBLOCK);
    if (fd < 0) {
        fprintf(stderr, "[camerafeed] %s open(%s): %s\n",
                qPrintable(m_label), qPrintable(m_device), strerror(errno));
        scheduleReconnect();
        return;
    }

    struct v4l2_capability cap;
    memset(&cap, 0, sizeof(cap));
    if (::ioctl(fd, VIDIOC_QUERYCAP, &cap) < 0) {
        fprintf(stderr, "[camerafeed] VIDIOC_QUERYCAP: %s\n", strerror(errno));
        ::close(fd);
        scheduleReconnect();
        return;
    }
    // device_caps, not the device-wide capabilities field: only the per-node
    // device_caps discriminates the real capture node. See NOTES.md.
    quint32 caps = (cap.capabilities & V4L2_CAP_DEVICE_CAPS)
                       ? cap.device_caps : cap.capabilities;
    if (!(caps & V4L2_CAP_VIDEO_CAPTURE) || !(caps & V4L2_CAP_STREAMING)) {
        fprintf(stderr, "[camerafeed] %s (%s) is not a streaming capture node (caps=0x%x)\n",
                qPrintable(m_label), qPrintable(m_device), caps);
        ::close(fd);
        setFailed(true);
        return; // not a transient condition — don't retry against the wrong node
    }

    struct v4l2_format fmt;
    memset(&fmt, 0, sizeof(fmt));
    fmt.type = V4L2_BUF_TYPE_VIDEO_CAPTURE;
    fmt.fmt.pix.width = kRequestedWidth;
    fmt.fmt.pix.height = kRequestedHeight;
    fmt.fmt.pix.pixelformat = V4L2_PIX_FMT_UYVY;
    fmt.fmt.pix.field = V4L2_FIELD_ANY;
    if (::ioctl(fd, VIDIOC_S_FMT, &fmt) < 0) {
        fprintf(stderr, "[camerafeed] VIDIOC_S_FMT: %s\n", strerror(errno));
        ::close(fd);
        scheduleReconnect();
        return;
    }
    if (fmt.fmt.pix.pixelformat != V4L2_PIX_FMT_UYVY) {
        fprintf(stderr, "[camerafeed] %s refused UYVY (got fourcc 0x%x) — unsupported\n",
                qPrintable(m_device), fmt.fmt.pix.pixelformat);
        ::close(fd);
        setFailed(true);
        return;
    }
    // The NVP6324 sources progressive frames; if the SHIM ever grants an
    // interlaced field the UYVY converter would weave two fields into one
    // garbled frame with no error. Warn loudly rather than show garbage —
    // still proceed (NONE/ANY are the expected good cases).
    if (fmt.fmt.pix.field != V4L2_FIELD_NONE && fmt.fmt.pix.field != V4L2_FIELD_ANY) {
        fprintf(stderr, "[camerafeed] %s (%s): WARNING non-progressive field=%u granted — frames may shear\n",
                qPrintable(m_label), qPrintable(m_device), fmt.fmt.pix.field);
    }
    // Read back what was actually granted — notably bytesperline: assuming it
    // always equals width*2 (tightly packed) and reading past a stride the
    // driver actually padded would walk off the end of the capture buffer.
    m_captureWidth = int(fmt.fmt.pix.width);
    m_captureHeight = int(fmt.fmt.pix.height);
    m_bytesPerLine = int(fmt.fmt.pix.bytesperline);
    m_frameWidth = m_captureWidth / kDecimation;
    m_frameHeight = m_captureHeight / kDecimation;
    fprintf(stderr, "[camerafeed] %s (%s): negotiated %dx%d bytesperline=%d sizeimage=%u field=%u, decoding at %dx%d\n",
            qPrintable(m_label), qPrintable(m_device),
            m_captureWidth, m_captureHeight, m_bytesPerLine, fmt.fmt.pix.sizeimage,
            fmt.fmt.pix.field, m_frameWidth, m_frameHeight);
    emit formatChanged();

    struct v4l2_requestbuffers req;
    memset(&req, 0, sizeof(req));
    req.count = m_zeroCopy ? 6 : 4; // see camerafeed.h's kMaxBuffers comment
    req.type = V4L2_BUF_TYPE_VIDEO_CAPTURE;
    req.memory = V4L2_MEMORY_MMAP;
    // Ask vb2 for NON-COHERENT (CPU-cacheable) buffers instead of the
    // default coherent (uncached, Normal-NC) DMA mapping. This single flag
    // is what took the UYVY conversion from 240ms/frame (every byte load from
    // an uncached mapping is a DRAM round-trip) to 3.6ms: vb2 cache-
    // invalidates on DQBUF itself, so reads hit cache at full speed. Only
    // honored if the driver opts in (q->allow_cache_hints — j721e-csi2rx
    // does); harmless no-op elsewhere. The CPU never *writes* the buffers, so
    // there are no dirty lines to conflict with the DMA or the GPU's reads.
#ifdef V4L2_MEMORY_FLAG_NON_COHERENT
    req.flags = V4L2_MEMORY_FLAG_NON_COHERENT;
#endif
    if (::ioctl(fd, VIDIOC_REQBUFS, &req) < 0 || req.count < 2) {
        fprintf(stderr, "[camerafeed] VIDIOC_REQBUFS: %s\n", strerror(errno));
        ::close(fd);
        scheduleReconnect();
        return;
    }

    m_numBuffersMapped = 0;
    for (quint32 i = 0; i < req.count && i < quint32(kMaxBuffers); ++i) {
        struct v4l2_buffer buf;
        memset(&buf, 0, sizeof(buf));
        buf.type = V4L2_BUF_TYPE_VIDEO_CAPTURE;
        buf.memory = V4L2_MEMORY_MMAP;
        buf.index = i;
        if (::ioctl(fd, VIDIOC_QUERYBUF, &buf) < 0) {
            fprintf(stderr, "[camerafeed] VIDIOC_QUERYBUF[%u]: %s\n", i, strerror(errno));
            break;
        }
        void *start = ::mmap(nullptr, buf.length, PROT_READ | PROT_WRITE, MAP_SHARED, fd, buf.m.offset);
        if (start == MAP_FAILED) {
            fprintf(stderr, "[camerafeed] mmap[%u]: %s\n", i, strerror(errno));
            break;
        }
        m_buffers[i].start = start;
        m_buffers[i].length = buf.length;
        m_numBuffersMapped = int(i) + 1;
        if (::ioctl(fd, VIDIOC_QBUF, &buf) < 0) {
            fprintf(stderr, "[camerafeed] VIDIOC_QBUF[%u]: %s\n", i, strerror(errno));
            break;
        }
    }
    if (m_numBuffersMapped < 2) {
        unmapBuffers();
        ::close(fd);
        scheduleReconnect();
        return;
    }

    if (m_zeroCopy) {
        // Export every buffer as a dma-buf for the renderers' EGLImage
        // import (dmabuftexture.cpp). Failure here isn't fatal: fall back
        // to the converted-QImage path for this stream and say so loudly.
        QMutexLocker lock(&m_bufMutex);
        for (int i = 0; i < m_numBuffersMapped; ++i) {
            struct v4l2_exportbuffer exp;
            memset(&exp, 0, sizeof(exp));
            exp.type = V4L2_BUF_TYPE_VIDEO_CAPTURE;
            exp.index = quint32(i);
            exp.flags = O_CLOEXEC | O_RDONLY;
            if (::ioctl(fd, VIDIOC_EXPBUF, &exp) < 0) {
                fprintf(stderr, "[camerafeed] VIDIOC_EXPBUF[%d]: %s — zero-copy off, converting instead\n",
                        i, strerror(errno));
                for (int j = 0; j < i; ++j) {
                    ::close(m_dmabufFds[j]);
                    m_dmabufFds[j] = -1;
                }
                m_zeroCopy = false;
                break;
            }
            m_dmabufFds[i] = exp.fd;
        }
    }

    v4l2_buf_type type = V4L2_BUF_TYPE_VIDEO_CAPTURE;
    if (::ioctl(fd, VIDIOC_STREAMON, &type) < 0) {
        fprintf(stderr, "[camerafeed] %s (%s) VIDIOC_STREAMON: %s\n",
                qPrintable(m_label), qPrintable(m_device), strerror(errno));
        for (int i = 0; i < kMaxBuffers; ++i) {
            if (m_dmabufFds[i] >= 0) { ::close(m_dmabufFds[i]); m_dmabufFds[i] = -1; }
        }
        unmapBuffers();
        ::close(fd);
        scheduleReconnect();
        return;
    }

    m_fd = fd;
    m_captureThread = new CameraCaptureThread(this, fd, m_fpsLogEnabled);
    m_captureThread->start();
    m_reconnectTimer.stop();
    m_reconnectIntervalMs = 1000; // back to base now that this feed is healthy
    fprintf(stderr, "[camerafeed] streaming %s (%s): %dx%d UYVY (%d buffers, zerocopy=%d, reqbufs caps=0x%x flags=0x%x)\n",
            qPrintable(m_label), qPrintable(m_device), m_captureWidth, m_captureHeight,
            m_numBuffersMapped, int(m_zeroCopy), req.capabilities, req.flags);
}

#else // !defined(__linux__) || defined(ULTIMA_SIMULATE)

void CameraFeed::tryOpen() {}
void CameraFeed::onWorkerFrame() {}
void CameraFeed::onWorkerError() {}
#ifndef __linux__
void CameraFeed::closeDevice() {}
#else
void CameraFeed::unmapBuffers() {}
void CameraFeed::closeDevice() {}
#endif

// Dev-build stand-in: a moving test pattern (diagonal bars sliding sideways)
// so Camera360Screen's pillarbox/fallback/aspect logic can be exercised on
// scripts/dev-build.sh without capture hardware. Uses the same negotiated-size
// shape (frameWidth/frameHeight) real hardware would.
//
// The bar color is derived from m_label rather than fixed, and the label is
// drawn on screen — 4 concurrent instances (cam1..4) need to look visibly
// different so a cross-wired quadrant (cam2 showing in cam3's slot) is obvious
// by eye rather than needing pixel inspection.
void CameraFeed::simulateTick()
{
    if (m_frameWidth != kRequestedWidth || m_frameHeight != kRequestedHeight) {
        m_frameWidth = kRequestedWidth;
        m_frameHeight = kRequestedHeight;
        emit formatChanged();
    }

    // Dev-only override, same idea as main.qml's ULTIMA_SPLASH_IMAGE: if
    // ULTIMA_CAM_IMAGE_DIR is set, show a real static photo (<dir>/<label>.png,
    // e.g. "cam3.png") instead of the bars below -- lets the macOS/non-Linux
    // build be pointed at real reference frames without the Linux-only V4L2
    // path compiled in. Loaded once and cached; unset/missing/undecodable all
    // fall through to the bars.
    if (!m_simStaticImageLoadAttempted) {
        m_simStaticImageLoadAttempted = true;
        const QString dir = qEnvironmentVariable("ULTIMA_CAM_IMAGE_DIR");
        if (!dir.isEmpty()) {
            QImage img(dir + QLatin1Char('/') + m_label + QStringLiteral(".png"));
            if (!img.isNull())
                m_simStaticImage = img.scaled(m_frameWidth, m_frameHeight,
                                               Qt::IgnoreAspectRatio, Qt::SmoothTransformation);
        }
    }
    if (!m_simStaticImage.isNull()) {
        m_frame = m_simStaticImage;
        setStreaming(true);
        emit frameReady();
        return;
    }

    m_simPhase += 4.0;
    QImage frame(m_frameWidth, m_frameHeight, QImage::Format_RGB32);
    QPainter p(&frame);
    p.fillRect(frame.rect(), QColor(20, 20, 24));
    p.setPen(Qt::NoPen);
    const uint h = qHash(m_label);
    p.setBrush(QColor(80 + h % 150, 80 + (h / 150) % 150, 80 + (h / 22500) % 150));
    const int barWidth = 40;
    for (int x = -barWidth; x < frame.width() + barWidth; x += barWidth * 2) {
        int shifted = int(std::fmod(x + m_simPhase, frame.width() + 2.0 * barWidth)) - barWidth;
        p.drawRect(shifted, 0, barWidth, frame.height());
    }
    p.setPen(Qt::white);
    QFont font = p.font();
    font.setPointSize(48);
    p.setFont(font);
    p.drawText(frame.rect(), Qt::AlignCenter,
               QStringLiteral("%1\n(simulated)").arg(m_label));
    p.end();

    m_frame = frame;
    setStreaming(true);
    emit frameReady();
}
#endif
