joshellissh/UltimaGC/docs/MY-CAM004M/MYD-LT527/MYD-LT527-N4-BSP/bsp/drivers/vin/modules/sensor/nvp6324_2/jaguar1_cableA_video_eq_table2.h

/* SPDX-License-Identifier: GPL-2.0-or-later */
/* Copyright(c) 2020 - 2023 Allwinner Technology Co.,Ltd. All rights reserved. */
/*
 * A V4L2 driver for nvp6324 cameras and AHD Coax protocol.
 *
 * Copyright (c) 2017 by Allwinnertech Co., Ltd.  http://www.allwinnertech.com
 *
 * Authors:  Li Huiyu <lihuiyu@allwinnertech.com>
 *
 * This program is free software; you can redistribute it and/or modify
 * it under the terms of the GNU General Public License version 2 as
 * published by the Free Software Foundation.
 */

#ifndef _CABLE_A_VIDEO_EQ_TABLE2_H_
#define _CABLE_A_VIDEO_EQ_TABLE2_H_

#include "jaguar1_common2.h"
#include "jaguar1_video_eq2.h"

/*=====================================================================================
 * Cable : 3C2V
 *=====================================================================================*/
_jaguar1_video_eq_value_table_s equalizer_value_fmtdef_cableA2[] = {
	[AHD20_SD_H720_NT_SINGLE_ENDED] = {
		.name         = "AHD20_SD_H720_NT_SINGLE_ENDED",
		.video_fmt    = AHD20_SD_SH720_NT,
		.analog_input = SINGLE_ENDED,


		/* base */
		{
			.eq_bypass = {0x0, 0x0, 0x0, 0x0, 0x0, 0x0},
			.eq_band_sel = {0x00, 0x00, 0x00, 0x00, 0x00, 0x00},
			.eq_gain_sel = {0x78, 0x78, 0x78, 0x78, 0x78, 0x78},
			.deq_a_on = {0x0, 0x0, 0x0, 0x0, 0x0, 0x0 },
			.deq_a_sel = {0x0, 0x0, 0x0, 0x0, 0x0, 0x0},
		},
		/* coeff_ */
		{
			.deqA_01 = {0xac, 0xac, 0xac, 0xac, 0xac, 0xac},
			.deqA_02 = {0x78, 0x78, 0x78, 0x78, 0x78, 0x78},
			.deqA_03 = {0x17, 0x17, 0x17, 0x17, 0x17, 0x17},
			.deqA_04 = {0xc1, 0xc1, 0xc1, 0xc1, 0xc1, 0xc1},
			.deqA_05 = {0x40, 0x40, 0x40, 0x40, 0x40, 0x40},
			.deqA_06 = {0x0, 0x0, 0x0, 0x0, 0x0, 0x0},
			.deqA_07 = {0xc3, 0xc3, 0xc3, 0xc3, 0xc3, 0xc3},
			.deqA_08 = {0xa, 0xa, 0xa, 0xa, 0xa, 0xa},
			.deqA_09 = {0x0, 0x0, 0x0, 0x0, 0x0, 0x0},
			.deqA_10 = {0x2, 0x2, 0x2, 0x2, 0x2, 0x2},
			.deqA_11 = {0x0, 0x0, 0x0, 0x0, 0x0, 0x0},
			.deqA_12 = {0xb2, 0xb2, 0xb2, 0xb2, 0xb2, 0xb2},
		},
		/* color */
		{
			.contrast = {0x90, 0x90, 0x90, 0x90, 0x90, 0x90},
			.y_peaking_mode = {0x0, 0x0, 0x0, 0x0, 0x0, 0x0},
			.y_fir_mode = {0x00, 0x00, 0x00, 0x00, 0x00, 0x00},
			.c_filter = {0x82, 0x82, 0x82, 0x82, 0x82, 0x82},
			.pal_cm_off = {0x82, 0x82, 0x82, 0x82, 0x82, 0x82},
			.hue = {0x0, 0x0, 0x0, 0x0, 0x0, 0x0},
			.u_gain = {0x0, 0x0, 0x0, 0x0, 0x0, 0x0},
			.v_gain = {0x0, 0x0, 0x0, 0x0, 0x0, 0x0},
			.u_offset = {0x0, 0x0, 0x0, 0x0, 0x0, 0x0},
			.v_offset = {0x0, 0x0, 0x0, 0x0, 0x0, 0x0},
			.black_level = {0x90, 0x90, 0x90, 0x90, 0x90, 0x90},
			.acc_ref = {0x57, 0x57, 0x57, 0x57, 0x57, 0x57},
			.cti_delay = {0x80, 0x80, 0x80, 0x80, 0x80, 0x80},
			.saturation_b = {0xc0, 0xc0, 0xc0, 0xc0, 0xc0, 0xc0},
			.burst_dec_a = {0x2a, 0x2a, 0x2a, 0x2a, 0x2a, 0x2a},
			.burst_dec_b = {0x0, 0x0, 0x0, 0x0, 0x0, 0x0},
			.burst_dec_c = {0x30, 0x30, 0x30, 0x30, 0x30, 0x30},
			.c_option = {0x80, 0x80, 0x80, 0x80, 0x80, 0x80},
			.y_filter_b = {0x10, 0x10, 0x10, 0x10, 0x10, 0x10},
			.y_filter_b_sel = {0x1e, 0x1e, 0x1e, 0x1e, 0x1e, 0x1e},
		},
		/* timing_a */
		{
			.h_delay_a = {0xD4, 0xD4, 0xD4, 0xD4, 0xD4, 0xD4},
			.h_delay_b = {0x1d, 0x1d, 0x1d, 0x1d, 0x1d, 0x1d},
			.h_delay_c = {0x0, 0x0, 0x0, 0x0, 0x0, 0x0},
			.y_delay = {0x1c, 0x1c, 0x1c, 0x1c, 0x1c, 0x1c},
		},
		/* clock */
		{
			.clk_adc = {0x06, 0x06, 0x06, 0x06, 0x06, 0x06},
			.clk_adc_pre = {0x07, 0x07, 0x07, 0x07, 0x07, 0x07},
			.clk_adc_post = {0x01, 0x01, 0x01, 0x01, 0x01, 0x01},
		},
		/* timing_b */
		{
			.h_scaler1 = {0x10, 0x10, 0x10, 0x10, 0x10, 0x10},
			.h_scaler2 = {0x10, 0x10, 0x10, 0x10, 0x10, 0x10},
			.h_scaler3 = {0x0, 0x0, 0x0, 0x0, 0x0, 0x0},
			.h_scaler4 = {0x0, 0x0, 0x0, 0x0, 0x0, 0x0},
			.h_scaler5 = {0x0, 0x0, 0x0, 0x0, 0x0, 0x0},
			.h_scaler6 = {0x0, 0x0, 0x0, 0x0, 0x0, 0x0},
			.h_scaler7 = {0x0, 0x0, 0x0, 0x0, 0x0, 0x0},
			.h_scaler8 = {0x0, 0x0, 0x0, 0x0, 0x0, 0x0},
			.h_scaler9 = {0x0, 0x0, 0x0, 0x0, 0x0, 0x0},
			.pn_auto = {0x0, 0x0, 0x0, 0x0, 0x0, 0x0},
			.comb_mode = {0x1, 0x1, 0x1, 0x1, 0x1, 0x1},
			.h_pll_op_a = {0x72, 0x72, 0x72, 0x72, 0x72, 0x72},
			.mem_path = {0x00, 0x00, 0x00, 0x00, 0x00, 0x00},
			.fsc_lock_speed = {0xdc, 0xdc, 0xdc, 0xdc, 0xdc, 0xdc},
			.ahd_mode = {0x0, 0x0, 0x0, 0x0, 0x0, 0x0},
			.sd_mode = {0x04, 0x04, 0x04, 0x04, 0x04, 0x04},
			.spl_mode = {0x0, 0x0, 0x0, 0x0, 0x0, 0x0},
			.vblk_end = {0xc0, 0xc0, 0xc0, 0xc0, 0xc0, 0xc0},
			.afe_g_sel = {0x0c, 0x0c, 0x0c, 0x0c, 0x0c, 0x0c},
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
			.vblk_end = {0x21, 0x21, 0x21, 0x21, 0x21, 0x21},
			.afe_g_sel = {0x0c, 0x0c, 0x0c, 0x0c, 0x0c, 0x0c},
			.afe_ctr_clp = {0x2c, 0x2c, 0x2c, 0x2c, 0x2c, 0x2c},
			.d_agc_option = {0x24, 0x24, 0x24, 0x24, 0x24, 0x24},
		},
	},

	[CVI_HD_30P_EX_SINGLE_ENDED] = {
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
