joshellissh/UltimaGC/(commit log)

2026-03-14 Initial commit: Buildroot-based RPi5 image with Qt5 EGLFS, WiFi, and touchscreen
    Minimal Linux image targeting RPi5 with Waveshare 10.4" QLED display.
    Key components: BR2_EXTERNAL tree with defconfig, kernel fragments for
    built-in VC4/brcmfmac drivers, CYW43455 WiFi firmware, Qt5 EGLFS app,
    and init scripts for display, WiFi, and boot logging.
    [config.txt, genimage.cfg, kernel-fragments.cfg]
2026-03-26 Add BMW-style gauge cluster UI and USB boot support
    Replace hello-world Qt app with animated gauge cluster inspired by BMW
    RealDash theme: two circular gauges (speed + fuel consumption) with
    glowing arcs, animated needles, info bar, and decorative center element.
    Simulated driving data cycles through city/highway/stop phases.
    Also fix boot infrastructure for USB drives: use /dev/sda2 root device,
    add vfat kernel support for boot partition logs, auto-detect boot
    partition from root device, improve flash script with disk picker,
    and add dev-build script for local testing.
    [genimage.cfg, kernel-fragments.cfg]
2026-03-27 Getting closer
    [config.txt, kernel-fragments.cfg]
2026-03-27 Add setup guide, boot time display, and final boot optimizations
    Add comprehensive SETUP.md documenting the entire project setup for
    reproducibility. Add boot time indicator to the Qt app (reads
    /proc/uptime). Suppress kernel console output (console=tty3,
    logo.nologo), add black splash screen, enable force_turbo for
    faster CPU at boot, and add splash support to post-image.sh.
    [config.txt]
2026-03-27 Replace Canvas gauges with image-based needle rotation over background
    Switch from Canvas-drawn gauge arcs to a background image with rotated
    needle PNG overlay. Add fuel level and coolant temp gauges, remove
    InfoBar/CenterLine components, fix needle rotation formula, enable PNG
    support, and clean up splash/screenshot artifacts.
    [config.txt]
2026-03-27 Add touchscreen support and touch feedback indicator
    Use evdev touch handler instead of libinput (QT_QPA_EGLFS_NO_LIBINPUT=1),
    add udev rule for input device permissions, and add animated cyan dot on tap.
2026-03-28 Optimize boot time and add startup profiling
    - Disable unused NVMe PCIe port (dtparam=pciex1=off) and Bluetooth
    - Remove KVM, NFS, iSCSI, loop/RAM from kernel config
    - Add init script timing wrapper (logs to /tmp/boot-timing.log)
    - Add app startup timing (EGL init, QML load durations)
    - Fix boot partition mount (try mmcblk0p1/sda1 directly)
    Kernel-to-app render time reduced from 2.51s to 1.88s.
    [config.txt, kernel-fragments.cfg]
2026-03-30 Add gear indicator, dashboard warning icons, odometer, and WiFi debug logging
    - Gear indicator (P/R/N/1-7) centered on gauge cluster using Range font
    - ISO 7000 dashboard warning icons: oil pressure, check engine, battery,
    coolant temp, low beam, high beam (from Wikimedia Commons, public domain)
    - Odometer and trip odometer with touchscreen reset button
    - SimEngine extended: P/R/N/1-7 gear simulation, warning indicator states
    - S40network: added debug logging to /boot/wifi-debug.log
    - SETUP.md updated to reflect current image-based gauge cluster architecture
    - .gitignore: exclude .DS_Store files
2026-03-30 Add read-only root filesystem, persistent odometer, and UI refinements
    Root filesystem is now mounted read-only to prevent SD card corruption
    from power cuts. A separate 16MB ext4 data partition stores odometer
    state (saved every 30s and on SIGTERM). S00remountro remounts root ro
    after BusyBox init completes setup, preserving the normal boot flow.
    UI changes: Bahnschrift font for gear indicator, flashing red warning
    icons (300ms cycle), coolant warning random toggle, warning row moved
    up 10px.
    [main.cpp, odostore.cpp, odostore.h]
2026-04-02 Add boost gauge, reposition indicators to top row, and update background
    - Add boost gauge with trapezoid black overlay that recedes with boost pressure (0-30 PSI)
    - Add boost PSI readout (range font) and scale lines overlay asset
    - Add boost simulation to SimEngine (builds with throttle at higher RPM)
    - Move warning indicators (oil, CEL, beams, battery, coolant) to top row
    - Reposition gear indicator to upper center
    - Update background.png with new gauge layout including boost area
    - Add missing #include <unistd.h> in main.cpp
    - Update SETUP.md to document boost gauge and layout changes
    [main.cpp]
2026-04-04 Disable unused USB controller and enable UART debug console
    - Add disable-usb0.dts overlay to disable rp1_usb0 (touchscreen is on usb1)
    - Compile overlay in post-build.sh and load via config.txt
    - Switch cmdline.txt to UART console (ttyAMA10) with verbose logging for boot profiling
    - Saves ~700ms total boot time (640ms bootloader + 60ms kernel)
    [config.txt]
2026-04-04 Trim kernel and disable HDMI1 for faster boot
    - Disable HDMI1 via vc4-kms-v3d-pi5 nohdmi1 parameter
    - Disable CEC/IR remote control (CONFIG_RC_CORE, DRM_VC4_HDMI_CEC)
    - Disable camera/video codec (CONFIG_MEDIA_SUPPORT, CONFIG_VIDEO_DEV)
    - Disable wired ethernet (CONFIG_MACB) — WiFi only
    - Disable iSCSI/SCSI subsystem
    - Disable unused USB network drivers (r8152, lan78xx, smsc95xx)
    - Kernel image reduced from 23.2MB to 22.4MB
    - Saves ~210ms in kernel boot phase (vc4 DRM init + driver probing)
    [config.txt, kernel-fragments.cfg]
2026-04-04 Launch app before udev, disable NUMA/ftrace for faster boot
    - Move app launch from S11app to S00remountro (before udev coldplug)
    - Add numa=off to cmdline (eliminates 8 fake NUMA node overhead)
    - Disable ftrace (CONFIG_FTRACE) — saves 4.4MB kernel size + boot alloc
    - Disable GPIO memory mapping (unused)
    - Kernel image reduced from 22.4MB to 18.0MB
    - App launch 720ms faster in kernel/init phase (4.01s → 3.29s)
    [kernel-fragments.cfg]
2026-04-04 Disable KASLR, trim kernel subsystems for faster boot
    - Add nokaslr to cmdline (eliminates forced KPTI syscall overhead)
    - Disable KASLR (CONFIG_RANDOMIZE_BASE)
    - Disable unused IO schedulers (bfq, kyber — keep mq-deadline)
    - Disable FS-Cache, CacheFiles, disk quotas, PTP/PPS
    - Enable CONFIG_BASE_SMALL for smaller hash tables
    - Disable taskstats, audit, profiling, perf, debugfs, kallsyms
    - Kernel image reduced from 18.0MB to 17.2MB
    - App launch ~100ms faster (3.29s → 3.19s kernel time)
    - Bootloader 500ms faster this run (7.48s vs 8.04s)
    [kernel-fragments.cfg]
2026-04-04 Add embedded kernel optimizations (CONFIG_EMBEDDED, size opt, HZ=100)
    - Enable CONFIG_EMBEDDED and CONFIG_CC_OPTIMIZE_FOR_SIZE
    - Lower timer tick to 100Hz (CONFIG_HZ_100)
    - Clear CONFIG_SYSTEM_TRUSTED_KEYS (skip keyring probe)
    - Enable CONFIG_SLAB_MERGE_DEFAULT
    - Kernel image reduced from 17.2MB to 14.9MB
    - Kernel load from SD 350ms faster, but runtime ~200ms slower (size vs speed tradeoff)
    [kernel-fragments.cfg]
2026-04-04 Update SETUP.md with boot optimization details and current architecture
    Documents all boot optimizations applied: app launch in S00remountro (before
    udev), kernel config trimming, disable-usb0 DT overlay, EEPROM BOOT_ORDER=0xf1,
    cmdline numa=off/nokaslr. Adds boot timing numbers, hot-deploy workflow, and
    lessons learned (CMA limits, PID-1 failure). Updates boot sequence diagram and
    init script descriptions to reflect current S00remountro-based architecture.
2026-04-06 Reduce boot time from ~11.1s to ~9.2s with I2C fix and quiet console
    - Build I2C_BRCMSTB as built-in (=y) to eliminate ~1s of VC4 HDMI
    deferred probe retries (18 bind/unbind cycles waiting for DDC adapter)
    - Switch cmdline to loglevel=1 quiet to avoid ~1.7s serial console
    overhead (0.7s flush of buffered early-boot messages + 1s cumulative
    printk blocking at 115200 baud)
    - Silence init script output via rcS overlay (redirect to /dev/null)
    - Add silenced inittab overlay (remove swapon, getty)
    - Add APP_LAUNCH UART timing marker in S00remountro for boot profiling
    - Update SETUP.md with new boot timing, I2C notes, and quiet console docs
    [kernel-fragments.cfg]
2026-04-06 Fix stale references in SETUP.md after boot optimization changes
    - Update cmdline parameter table to match current loglevel=1 setting
    - Fix known issue 13 to reflect inittab overlay (not "do not modify")
    - Remove outdated "saving ~0.5s" claim from init optimization section
2026-07-17 Add CAN2 dash-data integration via new CanBus class
    Replaces SimEngine.qml as the live gauge data source: on Linux, CanBus
    opens a SocketCAN socket on can0, retrying until udev brings the
    interface up, and decodes Syvecs S7+ CAN2 frames (RPM, coolant, oil
    pressure, gear, battery, speed/odometer, boost). On macOS dev builds it
    falls back to a timer-driven simulation reproducing SimEngine's driving
    profile, so QML/layout iteration doesn't need real hardware.
    Also adds SocketCAN/gs_usb kernel config and can-utils for bring-up, a
    udev rule to auto-configure can0 on adapter plug-in, and documents the
    whole CAN2 frame map and ECU setup in SETUP.md.
    [kernel-fragments.cfg]
2026-07-18 Replace boost trapezoid overlay with pill gauge, add shift-light bar
    Swaps the old Canvas-drawn boost trapezoid and PSI text for a BoostGauge
    component matching the fuel/coolant dial style, and adds a ShiftLightBar
    that fills with rpm and blinks red at redline alongside the existing
    warning-light flash timer.
2026-07-18 Add WSL2/WSLg local dev-build script
    Windows equivalent of dev-build.sh: builds with Qt6 via qmake6 and
    launches through WSLg. Requires QT_QPA_PLATFORM=xcb — the wayland
    plugin hits an undefined symbol against WSLg's bundled libwayland.
2026-07-18 Add opt-in ULTIMA_SIMULATE flag for Linux dev builds
    CanBus's data simulator previously only compiled on non-Linux (#ifndef
    __linux__), so Linux dev builds (e.g. WSL, which has no CAN subsystem
    at all) just retried a nonexistent can0 forever with static gauges.
    Gate the simulator on a new ULTIMA_SIMULATE define instead, set via an
    opt-in ultima_dev_sim qmake CONFIG flag that dev-build-wsl.sh now
    passes. Off by default, so the Buildroot/Pi production build (plain
    `qmake ultima-app.pro`, no CONFIG flag) is unaffected and still uses
    real SocketCAN only. macOS dev builds are unaffected too — they still
    simulate unconditionally via the pre-existing !defined(__linux__) arm.
2026-08-04 Swap gauge cluster background for Bavarian layered art
    Replaces the single background.png with three stacked layers (boost
    circle, gauge overlay, car) plus a not-yet-shown lit-headlights
    variant for later wiring.
2026-08-04 Add axle lift indicator icon, force all top-row icons visible for layout review
    - New icon_axle_lift.png (orange, centered below gear readout at 800,558)
    - CanBus exposes axleLift as a CONSTANT-false placeholder, same as the
    other signals not present on this CAN2 config, until wired to a real
    frame
    - Turn/warning icons temporarily forced visible: true for dashboard
    layout review
2026-08-04 Reposition trip reset icon, add cruise control icon asset, ignore Qt Creator user state
    Trip reset button was overlapping the trip odometer text after the recent
    right-alignment change; nudge it left and shrink to match. Qt Creator's
    per-project .pro.user file is machine-local IDE state that shouldn't be
    tracked.
2026-08-04 Add drive mode indicator, cruise/transmission sim, gear cycle sim
    Wires cruise control icon and an A/M transmission badge next to the gear
    indicator, adds a color-coded SPORT/SPORT+/RACE drive mode text, and
    switches the dev-build gear simulator to a fixed R/N/P/1..7 cycle so every
    glyph and badge state can be exercised without real CAN hardware.
    [canbus.cpp, canbus.h]
2026-08-04 Split RPi5-specific docs/scripts ahead of BeaglePlay port
    Renames SETUP.md and the board-specific scripts to *-rpi5 so a future
    BeaglePlay target can sit alongside them without ambiguity, and updates
    CLAUDE.md/external.desc to describe the repo as multi-board. No change
    to br2-external/board/ultima-rpi5 or package/ultima-app — those were
    already correctly scoped/shared.
2026-08-04 Scaffold BeaglePlay (AM625) port: board dir, defconfig, setup guide
    Boot chain (R5 SPL/TF-A/OP-TEE/U-Boot, kernel 6.18.16) is copied from
    upstream Buildroot's proven beagleplay_defconfig rather than reinvented.
    Targets software Qt rendering (linuxfb + Qt Quick software backend) since
    no mature Buildroot-packaged GPU driver exists yet for the PowerVR
    AXE-1-16M under Qt5, HDMI display, and reuse of the existing ODrive
    USB-CAN adapter. Scaffolding only — not yet verified against real
    hardware; SETUP-BEAGLEPLAY.md tracks open questions.
    [genimage.cfg, kernel-fragments.cfg]
2026-08-07 Fix BeaglePlay HDMI boot race, add flash script, verify on real hardware
    First real-hardware boot (2026-08-07) failed immediately with "Unable to
    figure out framebuffer device": tidss's DRM probe is component-based
    (bridges, HDMI DDC/EDID reads over i2c) and hadn't finished by the time
    S00remountro's pre-udev app launch tried to open /dev/fb0, unlike RPi5's
    vc4 which probes fast enough that eglfs never needed this.
    A synchronous wait didn't hold up — 5s lost the race (fb0 at 8.28s per
    dmesg), and 15s lost it too on a different boot where a genuine deferred
    probe ("tidss: port 1 probe failed") pushed fb0 to 18.06s. Boot-to-boot
    variance in the HDMI/DDC probe is real. Backgrounding the wait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
2026-08-07 Add tap-to-set-time screen, wire up BeaglePlay's onboard RTC
    Tapping the dash clock opens a full-screen time-set overlay (new
    SetTimeScreen.qml) styled to match the gauge cluster — hour/minute
    steppers, AM/PM toggle, Cancel/Save. Save pushes the new time through a
    new SystemClock QObject (systemclock.h/cpp, exposed to QML as the
    systemClock context property): clock_settime() updates the running
    kernel clock, and a best-effort ioctl writes through to /dev/rtc0 if a
    hardware RTC is present.
    BeaglePlay has one: an onboard battery-backed BQ32002 (CR1220 coin cell)
    already wired into the mainline k3-am625-beagleplay.dts this board's
    kernel pin (6.10) uses, so no DT overlay is needed — just k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
    [kernel-fragments.cfg]
2026-08-07 Disable unused PowerVR GPU driver on BeaglePlay, cutting fb0 wait to 3.4s
    CONFIG_DRM_POWERVR was probing and failing (~2s) before tidss got a turn
    at the display, contributing to the boot-to-boot variance seen in the
    fb0/S00remountro race. With the driver not built, nothing probes that
    node. Verified on real hardware: fb0 now registers at 3.44s (down from
    7.11s-18.06s), zero PowerVR/GPU lines in dmesg.
    [kernel-fragments.cfg]
2026-08-07 Confirm PowerVR disable fixes fb0 boot-to-boot variance, not just latency
    Second reboot: fb0 at 3.58s (vs 3.44s first boot), zero PowerVR/GPU lines
    in dmesg both times. Two consistent runs closes out the open question —
    the old 18.06s deferred-probe variance is gone, not avoided by luck.
2026-08-07 Zero U-Boot's bootdelay on BeaglePlay, cutting ~2s off every boot
    CONFIG_BOOTDELAY defaulted to 2s (wait for keypress to interrupt
    autoboot) in the am62x_beagleplay_a53 defconfig - pure waste on a
    headless dash that nothing ever interrupts. Set to 0 via a new
    uboot-fragments.cfg, wired up the same way kernel-fragments.cfg layers
    onto the kernel defconfig.
    Verified on real hardware: heartbeat LED (kernel start) now lights at
    ~8s instead of ~10s, matching the expected savings almost exactly.
    The remaining ~8s before the kernel starts is still unaccounted for -
    dmesg timestamps only start once the kernel itself runs, so none of
    this is visible without a UART capture on the debug header. Docum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
    [uboot-fragments.cfg]
2026-08-08 BeaglePlay: silence U-Boot console, research and rule out Falcon mode
    Silence U-Boot proper's console (CONFIG_SILENT_CONSOLE +
    CONFIG_SPL_SILENT_CONSOLE + CONFIG_SILENT_U_BOOT_ONLY, default env
    silent=1 via a new patch to beagleplay.env) — it was printing a full
    banner and boot-progress lines to the 115200 UART on every boot with
    bootdelay=0 already removing any chance of someone reading them.
    CONFIG_SILENT_U_BOOT_ONLY keeps this scoped to U-Boot so the kernel's
    own console/earlycon (used by S00remountro's timing marker) still works.
    Hardware-verified: boots clean, no regressions, but no measurable change
    to the ~8s heartbeat-LED timing — UART banner suppression was only ever
    worth tens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
    [uboot-fragments.cfg]
2026-08-08 BeaglePlay: kernel boot-time trimming pass
    Disable unused subsystems in kernel-fragments.cfg — KVM, BT, NFS, SCSI,
    RC_CORE/CEC/media, FTRACE, RANDOMIZE_BASE, TASKSTATS/AUDIT, PROFILING,
    DEBUG_FS, KALLSYMS, IOSCHED_BFQ/KYBER, VGA_ARB, QUOTA, PPS/PTP, and SOUND.
    Modeled on RPi5's list but checked against this SoC's own Kconfig
    dependency graph rather than copied blindly (e.g. SOUND is safe here
    since DRM_TIDSS, unlike RPi5's DRM_VC4, doesn't depend on it; SCSI is
    only pulled in by USB storage/image drivers we don't use).
    Hardware-verified: boots clean, no dmesg errors, kernel Image 46.3MB ->
    43.3MB, fb0 registration 3.44-3.58s -> 3.26s. Real but modest win, not
    the multi-second one hoped fo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
    [kernel-fragments.cfg]
2026-08-09 Add BeaglePlay Yocto/Falcon build with ultima-app running on real hardware
    Falcon boot mode (R5 SPL straight to kernel, skipping A53 SPL/U-Boot
    proper/GRUB) needs logic that only exists in TI's downstream ti-u-boot
    fork, not mainline U-Boot, so this lives in its own Docker-based
    Yocto/TI-SDK build rather than a Buildroot config. Adds a Qt5 layer
    (linuxfb rendering, no GPU driver needed) and an ultima-app recipe that
    builds the same shared app source the RPi5 build uses, plus kernel
    fragments for the CAN adapter and a tidss module-load fix.
    Hardware-verified end to end: falcon boot, Qt5/linuxfb rendering, and
    the gauge cluster itself all confirmed working on the real board.
    [genimage.cfg, kernel-fragments.cfg, uboot-fragments.cfg, ultima-can.cfg, ultima-display.cfg]
2026-08-09 Document the RPi5=Buildroot / BeaglePlay=Yocto split, drop leftover refs
    Now that beagleplay-falcon/ is the working BeaglePlay path, tidy up what
    referenced the deleted Buildroot board config: setup-vm.sh's TF-A/OP-TEE-only
    host deps, external.desc's "BeaglePlay in progress" note, and
    SETUP-RPI5.md's cross-reference to the removed SETUP-BEAGLEPLAY.md.
    CLAUDE.md is rewritten to state the split plainly up front and fold in
    today's real hardware lessons (USR-hold timing, the tidss module bug, the
    SD-card write-error risk from a crash-loop) so they're not just buried in
    beagleplay-falcon/NOTES.md.
2026-08-10 Boot BeaglePlay's gauge cluster from eMMC by default, no USR held
    Falcon mode picks its boot device at compile time (two env vars baked
    into the R5 SPL), and the ROM reads eMMC's boot0/boot1 hardware
    partitions rather than the user area SD boot uses — neither of which
    the SD-only build accounted for. build-emmc-spl.sh produces the
    eMMC-targeting SPL; emmc-push.sh/emmc-install.sh install it and the
    rootfs over SSH (the image ships passwordless root dropbear with
    DHCP ethernet, so no serial console is required); flash.sh now gives
    every SD card a distinct MBR disk signature so it can't collide with
    the eMMC's PARTUUID.
    Verified on hardware: SPL payload byte-identical to the one booting
    the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
2026-08-10 Add poweroff.sh: clean BeaglePlay shutdown over SSH, no console needed
    Unclean power-off has corrupted this board's rootfs more than once
    (both SD and eMMC, in separate incidents). The image ships
    passwordless root dropbear with DHCP ethernet, so sync/poweroff no
    longer needs a serial console — just ./poweroff.sh.
2026-08-10 Measure real power-on-to-framebuffer boot time: ~8.9s, not eyeballed ~12.3s
    measure-boot.sh times every serial line against first-byte-received,
    auto-stopping past the tidss framebuffer-ready landmark instead of
    requiring a hand-read of a raw screenlog.0. Three runs landed within 30ms
    of each other, so the number in NOTES.md is now measured, not eyeballed.
2026-08-10 Cut BeaglePlay boot time from ~8.9s to ~2.3s framebuffer / ~6.9s rendering
    Root-caused the CONFIG_DRM_TIDSS silent-downgrade NOTES.md had flagged as
    unsolved: CONFIG_DRM=m was capping the whole Kconfig choice group. Forcing
    DRM/KMS_HELPER/TIDSS/IT66121 built-in moves tidss init from kernel-relative
    ~7.8s to ~0.5s, letting the kernel-module-tidss workaround be deleted
    entirely. Quieted the falcon boot cmdline by patching U-Boot's
    k3_falcon_fdt_fixup() directly (the kernel's own CMDLINE_EXTEND doesn't
    exist on this arch), removing ~3.3s of synchronous UART wire time. Trimmed
    docker/containerd/lldpd/netperf/telnetd/psplash from boot via
    SYSTEMD_AUTO_ENABLE=disable bbappends.
    Tried gating ultim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
    [ultima-display.cfg]
2026-08-10 Hide the blinking fbcon cursor on BeaglePlay's HDMI output before boot
    tidss brings up the display before ultima-app takes the framebuffer,
    leaving a blinking text cursor visible for a few seconds. Append
    vt.global_cursor_default=0 to the falcon cmdline alongside quiet, same
    fix RPi5/Buildroot already carries in cmdline.txt. Hardware-verified
    on both SD and eMMC boot.
2026-08-10 Draw SetTimeScreen's step arrows and the trip-reset icon on Canvas
    Both used Unicode glyphs (U+25B2/U+25BC triangles, U+21BA reset arrow) that
    neither bundled font (bahnschrift, range) contains, and this app has no
    guaranteed system fallback font to borrow them from — BeaglePlay's Yocto
    image ships none at all — so they rendered as missing-glyph boxes on
    target. Drawing them directly on a Canvas sidesteps font coverage entirely.
2026-08-10 Fix BeaglePlay dash clock not persisting a manual time set
    Two stacked causes, both confirmed on hardware:
    1. systemd-timesyncd was actively NTP-syncing over the wired Ethernet used
    for bench access, silently overwriting whatever SetTimeScreen just wrote
    via SystemClock::setTime() (the app calls clock_settime() directly, so
    timesyncd has no idea a manual override happened). Never a legitimate
    clock source for a car with no network in the field anyway. Masked the
    unit in the finished rootfs — it ships inside the base "systemd" package
    here rather than its own sub-package, so the usual
    SYSTEMD_AUTO_ENABLE:pn-<pkg> override has nothing to attach to.
    2. Nothing loaded th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
2026-08-10 Make OdoStore::save() power-loss safe with an atomic write
    Was QFile opened WriteOnly|Truncate, writing in place: a power cut
    mid-write left a truncated/unparseable odometer.json, which load()
    silently treats as "no data" and resets the odometer to the hardcoded
    default (2347.0) -- the single worst-case failure this whole
    read-only-rootfs effort exists to avoid, and it was sitting in the one
    write path outside root that survives it.
    Switched to QSaveFile (temp file in the same directory, atomic rename
    on commit) plus explicit fsync on both the file and its containing
    directory before the rename lands, so a cut mid-write leaves the
    previous value intact instead of garbage, and a cut immediat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
    [odostore.cpp]
2026-08-10 BeaglePlay: read-only-rootfs groundwork — /data partition, journald/coredump off disk, resize_rootfs masked
    Motivated by NOTES.md's documented crash-loop incident: dozens of rapid
    unclean restarts produced real I/O errors on the SD card's rootfs
    partition, with journald + likely systemd-coredump writing on every one
    of them, on a rootfs with no read-only protection. That's structurally
    the same event ignition-off does to this board in normal operation, just
    lower frequency — so this is no longer just a crash-loop edge case now
    that eMMC boot is the default (no USR held) and Falcon boots the R5 SPL
    straight off the eMMC's ext4 root, with no journal replay and no
    U-Boot-proper/GRUB fallbac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
2026-08-10 BeaglePlay: fix /data UUID collision between SD and eMMC
    wic's --use-uuid on /data's part line baked a UUID= fstab entry into the
    rootfs at build time — but SD and eMMC are dd'd from the exact same .wic
    image, so that UUID (and the LABEL, and a bare device-path fallback wic
    would otherwise pick) is byte-identical on both. Whenever both devices are
    visible at once — every emmc-install.sh run, or a production eMMC boot with
    an SD card left in the slot — systemd's UUID-keyed mount unit for /data
    could nondeterministically grab either device's partition 3.
    Traced wic's own fstab-injection logic (scripts/lib/wic/plugins/imager/
    direct.py) in the build container rather than guessing: there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
2026-08-10 BeaglePlay: enable read-only-rootfs (Phase 1 — build-verified, not yet flashed)
    Turns root (p2) read-only at mount time. Read oe-core's own
    rootfs-postcommands.bbclass rather than assuming what this needs: most of
    the mechanics are automatic once IMAGE_FEATURES has read-only-rootfs — ro
    on the kernel cmdline, /etc/fstab's root line rewritten to ro, an emptied
    /etc/machine-id for systemd's transient-ID support, and dropbear redirected
    to generate its host key under /var/lib/dropbear once it sees none baked
    into the image. The one gap this distro doesn't cover on its own is
    somewhere writable for that redirected state to land — volatile-binds
    (stock oe-core, absent from every TI/arago la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
2026-08-10 BeaglePlay: fix two read-only-rootfs regressions found by hardware boot
    Both only showed up on a real boot, not at build time — this is the
    follow-up to enabling read-only-rootfs.
    1. ultima-data-mount.service was missing DefaultDependencies=no. Every
    .service gets an implicit After=sysinit.target by default, which
    directly contradicts this unit's own Before=local-fs.target
    (local-fs.target itself precedes sysinit.target in the normal boot
    chain) -- a real dependency cycle. systemd breaks cycles by deleting an
    arbitrary job rather than refusing to boot, and on hardware it dropped
    systemd-tmpfiles-setup.service's start job instead of this unit's. That
    meant /var/volatil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
2026-08-10 BeaglePlay: document the read-only-rootfs work in NOTES.md
    wic/ultima-beagleplay.wks.in already referenced a "NOTES.md 'read-only
    rootfs' groundwork" section that never actually existed — this was a
    forward-reference from early in that work. Writes it up properly: what's
    in place, what oe-core's read-only-rootfs feature handles automatically,
    the two hardware-only regressions found and fixed (a systemd dependency
    cycle from a missing DefaultDependencies=no, and emmc-install.sh staging
    in /root which stopped being writable), and a verification checklist.
    Also updates the two older sections this supersedes in part — the
    crash-loop incident's "no read-only protection" lesson and the "Alway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
2026-08-11 Remove RPi5/Buildroot entirely; move ultima-app out of br2-external
    BeaglePlay is now the sole target — its Yocto/Falcon build has been
    hardware-verified and running end to end, making the Raspberry Pi 5 board
    and its whole Buildroot build system dead weight. Removed SETUP-RPI5.md,
    br2-external/board/ultima-rpi5/, the RPi5 defconfig, all Buildroot
    external-tree plumbing (external.desc/mk, Config.in, ultima-app.mk —
    Yocto has its own .bb recipe and never used these), and the RPi5-only
    scripts (build-rpi5.sh, flash-rpi5.sh, read-logs-rpi5.sh, setup-vm.sh —
    the last of these only ever cloned Buildroot, despite CLAUDE.md calling
    it "shared").
    Board-agnostic content that happened to live i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
    [config.txt, genimage.cfg, kernel-fragments.cfg]
2026-08-11 BeaglePlay: measure real power-on-to-first-Qt-frame time on hardware
    ultima-app now hooks QQuickWindow's afterRendering/frameSwapped to log
    the actual first paint (not just QML construction) to /dev/kmsg at
    level 3, which survives the falcon boot's quiet cmdline and lands on
    the serial console in the same timeline as power-on. measure-boot.sh
    picks up the new landmark. Two hardware runs put power-on to first Qt
    frame at 6.7-7.3s, replacing the old ~6.94s figure which was actually
    just ultima-app.service starting, not a rendered frame.
    Also fixes the fast app-deploy loop in NOTES.md, which predated
    read-only-rootfs and staged into what's now a read-only /root.
    [main.cpp]
2026-08-11 BeaglePlay: decouple ultima-app.service from multi-user.target, shave ~0.95s off first frame
    Hardware-measured on eMMC: first Qt frame drops from ~5.42s to ~4.47s
    kernel-clock (~18%). Biggest piece is ultima-app.service no longer waiting
    on systemd-resolved/D-Bus it never uses (DefaultDependencies=no, Wants=/
    After=ultima-data-mount.service, WantedBy=local-fs.target instead of
    multi-user.target) — ~1.10s of that wait was pure overhead, confirmed
    across 6+ boots. Wants= rather than Requires= on the data mount is
    deliberate: Requires= would take the whole cluster down on a failed /data
    mount instead of just falling back to the default odometer value.
    Also: shrink the boost-ring Canvas from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
    [ultima-no-wifi.cfg]
2026-08-11 BeaglePlay: confirm ~0.95s boot-time win with a real serial capture
    power-on to first Qt frame is 5.238s on eMMC, measured directly with
    measure-boot.sh (real power-on t=0, drain-to-2s-silence done first to
    rule out the stale-UART-backlog contamination this file already
    documents) — down from the 6.664s/7.298s baseline, 1.4-2.1s faster with
    the same instrument and landmark as the original measurement.
2026-08-11 BeaglePlay: drop a stale systemd-udevd dependency, another ~0.7s off boot
    ultima-data-mount.service and ultima-app.service both waited on
    systemd-udevd.service before starting, but the block device they actually
    need (/dev/mmcblk0p3) comes from devtmpfs at kernel driver-probe time
    (~0.48s), over a second before udevd finishes starting (~2.7s) — the same
    stale-holdover shape as the already-fixed fb0/tidss trap. Removing it moved
    first frame from kernel_ts 4.470s to 3.338s on eMMC, real serial-measured
    power-on-to-first-frame from 5.238s to 4.536s. Odometer-persistence
    re-verified clean twice (hand-edit and from-source builds) given this is the
    same ordering-sensitive area that's bitten the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
2026-08-11 BeaglePlay: correct rootfs read-only claim, document boot-splash investigation
    CLAUDE.md claimed the rootfs isn't read-only; confirmed on hardware it's
    mounted ro via a stock fstab, with /var/* tmpfs-backed and /data as the
    only persistent writable partition. Also record why: investigated a
    pre-cluster boot splash via fbcon's built-in CONFIG_LOGO, and confirmed on
    real hardware (zero-byte fb0 dump, tty1 write test) that it doesn't render
    despite full kernel config support — likely a fbcon/DRM-generic-fbdev
    incompatibility. Found and reverted a real getty@tty1/console-clobber bug
    along the way. Board confirmed back to a verified-good boot afterward.
2026-08-11 ultima-app: startup self-test — needle sweep + tell-tale flash, wire up dead icon bindings
    On launch, sweep every needle to full deflection and back (1s up, 200ms
    hold, 1s down) while flashing every tell-tale icon, like a normal car's
    cluster does on power-up. Falls back to live sim-driven bindings once the
    sequence completes.
    Also wires the icon visibility bindings that were previously hardcoded
    `visible: true` (turn signals, axle lift, oil/check-engine/beams/battery/
    coolant) to their real CanBus properties — oil/battery/coolant now blink
    at 300ms via the existing but previously-unused _warnFlash timer, matching
    what GAUGE-CLUSTER.md already described.
2026-08-12 ultima-app: retune warn thresholds, drop unverified boost decode
    Oil pressure warn now fires at rpm >= 600 && psi <= 40 (was rpm > 1200
    && kPa < 100). Coolant warn now fires at 220F (was ~230F/110C) and
    battery warn fires below 12.5V with no low-end floor (was 0.5V < vbat
    < 12.0V).
    Also pulls the 0x614/mapMax boost decode: GAUGE-CLUSTER.md documented
    it as verified, but the xlsx built from CAN2.png — the source of truth
    for this mapping — shows frame 21 as all SPARE. Boost gauge reads 0 on
    real hardware until the frame is re-confirmed against a current SCal
    screenshot.
2026-08-12 GAUGE-CLUSTER.md: sync with latest app changes, trim stale content
    car_lights_on.png is now wired to lowBeams/highBeams (was documented
    as unwired); added a note on the startup self-test that sweeps
    needles/flashes icons on boot. Neither made it into the doc when
    4d7ca08 landed.
    Also drops the needle-alignment table, which was already flagged
    stale and calibrated against dial art that no longer exists — points
    to main.qml directly instead of carrying numbers nobody should trust.
2026-08-12 ultima-app: add diagnostics screen — swipe-left grid of CAN2 channels not yet on the dash
    40 channels from the Auto Bionics CAN2 mapping sheet (pedal/throttle/DBW,
    ignition timing + per-cylinder knock, fuel system, drivetrain/torque, and an
    unconfirmed TCM group), laid out as a 10x4 grid of 130x130 tiles sized to
    fit the whole set on one screen with no paging. Each tile pairs a value with
    a vertical bar that fills for the live reading and paints a static red/amber
    zone wherever the channel has a warn/crit threshold.
    None of these are decoded from real CAN2 yet — CanBus exposes them as a
    bundled `diag` QVariantMap (see the Q_PROPERTY comment in canbus.h for why
    not ~40 individual typed p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
2026-08-12 BeaglePlay: enable PowerVR GPU via TI's rogue stack, hardware-verified
    Switches ultima-app from linuxfb/software rendering to eglfs_kms. Turns out
    meta-ti's BSP was already fully wired for GPU on beagleplay-ti — mesa-pvr,
    ti-img-rogue-driver, ti-img-rogue-umlibs all version-matched by TI, DT node
    enabled, Qt's default PACKAGECONFIG_GL already resolved to kms/gbm/gles2/
    eglfs. The only thing disabling it was our own qtbase bbappend, written on
    a "no usable GPU driver" assumption that predated actually reading the
    kernel source or the Yocto build volume. linuxfb stays built alongside as a
    same-image fallback (env-var-only revert, no rebuild).
    Out-of-tree pvrsrvkm.ko needs forcing via module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
    [ultima-display.cfg]
2026-08-12 NOTES.md: GPU boot-time regression investigation — root-caused, no fix found
    Isolated the +2.26s GPU-path boot-time cost to two app-internal phases
    (QGuiApplication creation, QML load) via a phase-by-phase diff against the
    saved pre-GPU baseline, using live SSH testing against the eMMC-booted
    board rather than guesswork.
    Tested and disproved two candidate fixes with real reboots, not just warm
    restarts: pointing Mesa's shader disk cache at /data (the driver's
    proprietary GLSL compiler never writes to it) and pinning eglfs_kms's
    connector/mode to skip DRM auto-probe (looked like a huge win on a warm
    systemctl restart, evaporated completely on a genuine reboot). That second
    result rules out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
2026-08-12 ultima-app: point Qt's shader/QML disk cache at /data, recover ~0.2s of GPU boot-time regression
    QOpenGLProgramBinaryCache (built into Qt since 5.9, glProgramBinary-based,
    unrelated to Mesa's cache already ruled out) only activates when
    QStandardPaths::CacheLocation is writable. ultima-app.service set neither
    HOME nor XDG_CACHE_HOME, so on this read-only rootfs it was almost
    certainly resolving to an unwritable path and never caching anything on
    any boot since GPU enablement.
    Pointed XDG_CACHE_HOME at /data (the one partition that survives a power
    cycle) and added the ExecStartPre mkdir. Verified across three independent
    real reboots, including the properly rebuilt and eMMC-flashed image, n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
2026-08-13 BeaglePlay: add boot splash — real artwork, hardware-verified
    Fills the black-screen gap before ultima-app starts (grew to ~7.4s on SD
    after GPU/eglfs_kms enablement) with the Ultima RS artwork instead of
    nothing. ultima-splash.service writes straight to /dev/fb0 early in boot
    and exits — the kernel's own fbcon logo path is confirmed dead on this
    DRM-fbdev-emulation stack (see NOTES.md), and this never opens
    /dev/dri/card0, so it can't interfere with ultima-app's later eglfs_kms
    DRM master acquisition. getty@tty1 is now permanently masked too — it was
    overwriting the framebuffer with a login prompt.
    Verified on real hardware across three power cycles: the image holds on
    screen from ~2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
2026-08-13 dev-build.sh: add --boot to simulate the splash-to-cluster boot flow
    Lets the whole boot sequence be screen-recorded on macOS without hardware:
    black, then the real splash art, then a hard cut into the gauge cluster's
    startup sweep, timed to match the hardware-measured numbers in
    beagleplay-falcon/NOTES.md. No-op without the flag.
2026-08-13 ultima-app: add 360-degree camera view screen
    Tappable 360 icon on the main dash (centered at 280,666) toggles a
    full-screen overlay: 82%-opacity black backdrop, simulated_cameras.png,
    car_360.png. Opens/closes with a 250ms cross-fade (Behavior on opacity)
    rather than snapping. Static placeholder art for now — no camera
    hardware wired in yet.
2026-08-13 canbus: wire map1A to the boost gauge
    SCal Datastreams → Generic CAN Transmit now carries map1A on Slot 4/Frame
    1 (0x600, bytes 6-7): signed, y=(1*x)+0, absolute MAP in mbar, 0..3000.
    Convert to gauge-relative psi by subtracting standard atmosphere and
    clamping >= 0, matching the boost ring's 0-30psi sweep. Supersedes the
    earlier mapMax/frame-21 attempt, which turned out to be an unused SPARE
    slot.
2026-08-13 DiagnosticScreen: hide the 360 icon while diagnostics is open
    The icon sits at the same on-screen spot as diagnostic content and
    toggling the camera view from there doesn't make sense mid-diagnostics.
2026-08-13 canbus: wire fuel level + turn/beam/cruise/axle/trans signals from MCE18
    Sources flvlA (fuel sender, AIN0) and the six signals that have no Syvecs
    channel at all (leftIndicator, rightIndicator, axleLift, lowBeams,
    highBeams, cruiseControl) plus transmissionAuto from a CANchecked-protocol
    MCE18 CAN bus expander instead of leaving them permanently unwired.
    leftIndicator/rightIndicator/axleLift move off CONSTANT properties since
    they now need to update at runtime.
    Frame IDs, DIN bit order, and the AIN analog protocol mode are all
    datasheet defaults, not yet confirmed against this car's actual MCE18
    config — see the new MCE18 section in GAUGE-CLUSTER.md for the full
    mapping and what's still u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
2026-08-13 canbus: calibrate fuel sender to its 0-4V range, not the AIN's 0-5V
    The MCE18's AIN0 full scale is 0-5000mV, but the fuel sender itself only
    outputs 0V empty to 4V full — reading raw counts straight against the
    AIN's full scale would peg the gauge below 100% full. Convert to mV
    against the AIN's own scale first, then scale that against the sender's
    narrower 0-4V range.
2026-08-13 canbus: revert Auto/Manual wiring off the MCE18
    transmissionAuto should come from the Syvecs stream once its CAN2
    message is identified, not the MCE18 expander. DIN7 goes back to
    unassigned; transmissionAuto stays untouched by decodeFrame() and
    keeps its Automatic default until the real Syvecs message is known.
    [canbus.cpp, canbus.h]
2026-08-13 canbus: decode transmissionAuto from ManualAuto_U12 (0x605 slot 3)
    Auto/Manual now comes from the Syvecs stream itself rather than
    staying unwired — frame 6 (0x605), slot 3, per the user. Polarity
    (nonzero = Automatic) is assumed and not yet confirmed against a SCal
    screenshot or candump.
2026-08-13 canbus: source cruiseControl from Syvecs cruiseState, not MCE18 DIN5
    CAN2 frame 2 (0x601) slot 1 is now configured in SCal as cruiseState:
    0=OFF 1=ON 2=ACTIVE. Icon lights only on ACTIVE — ON reads as not-lit,
    same as OFF. MCE18 DIN5 is unassigned now that cruise no longer comes
    from the expander.
    [canbus.cpp, canbus.h]
2026-08-13 DiagnosticScreen: replace speculative Auto Bionics grid with real CAN2 signals
    The old 40-channel grid (lambda, per-cylinder knock, traction control,
    torque estimates, ...) came from a sheet that was never actually decoded on
    this car — every tile read from a fake simulator-only map and stayed "--"
    forever on real hardware. Swap it for the 16 channels this build actually
    decodes today: the SCal-verified Syvecs frame map plus the MCE18 expander
    (still flagged unconfirmed). Add raw oilPressure/vbat/cruiseState/limpMode
    properties to CanBus so the screen can show the real reading behind each
    dash warn icon instead of just its boolean.
    [canbus.cpp, canbus.h]
2026-08-14 canbus: fuel sender is 1V empty, not 0V
    Sender spec is 1-4V, not 0-4V as previously assumed.
2026-08-14 Camera360Screen: live UVC camera feed, auto-open on reverse gear
    CameraFeed wraps a USB UVC capture card, lazily opened only when the
    360 screen is shown. Camera360Screen now renders that feed via a new
    CameraView QQuickPaintedItem instead of static placeholder art, with
    a bounded fallback timer so a missing/failed/slow-to-start feed
    degrades to simulated_cameras.png instead of showing nothing.
    main.qml auto-opens/closes the screen on reverse gear (sim.gear === -1),
    guarded against the boot self-test's gear sweep.
    ultima-app.bb pins kernel-module-uvcvideo into RDEPENDS for the same
    can't-silently-drop-from-the-image reason as ti-img-rogue-driver.
    [camerafeed.cpp, camerafeed.h, cameraview.cpp, cameraview.h, main.cpp]
2026-08-16 Camera360Screen: switch to mycam004m's 4-stream driver, quad grid
    CameraFeed/CameraView didn't need structural changes -- the class was
    already just "open a device path, negotiate a format, mmap N buffers"
    with no UVC-specific logic. main.cpp now constructs 4 instances against
    /dev/mycam/cam1..4 (mycam004m's stable symlinks) instead of one against
    the USB UVC grabber, and the format constants move to the driver's fixed
    1920x1080 YUYV.
    Camera360Screen is now a plain 2x2 grid, one quadrant per camera, each
    pillarboxed to its negotiated aspect ratio and labeled (CAM N / NO
    SIGNAL / FAILED) so a cross-wired quadrant is obvious by eye. No
    stitching into a birds-eye/360 view yet -- that's deferre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
    [camerafeed.cpp, camerafeed.h, main.cpp]
2026-08-16 Add camera grid screen, reached by swiping right from the main cluster
    Same 4-camera quad grid content as Camera360Screen (CAM 1..4 labels,
    active-gated feeds), but as a persistent swipeable screen mirroring
    DiagnosticScreen's slide mechanics instead of a tap/reverse-gear
    overlay. Feeds only go active while the screen is actually open, so
    the YUYV decode/convert cost stays zero otherwise. Camera360Screen is
    untouched — the two stay independent entry points to the same driver.
2026-08-17 Camera360Screen: rebuild as a real stitched 360 view, add on-device screenshot capture
    Replaces the flat 2x2 raw-feed grid with a proper top-down composite: a
    precomputed per-camera fisheye/ground-plane warp mesh feather-blended into
    one canvas, ported from test/avm-benchmark's hardware-validated design.
    Runs as a QQuickFramebufferObject, synchronous on the render thread, same
    pattern CameraView already established as crash-safe on this GPU. Uses a
    placeholder calibration rig pending real measured camera mount data.
    Also adds a debug on-device screenshot hook (main.cpp): touching
    /tmp/ultima-screenshot.request over ssh saves a PNG via
    QQuickWindow::grabWindow() within 250ms, since eglfs_kms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
    [cameracalibration.cpp, cameracalibration.h, main.cpp, shadermanager.cpp, shadermanager.h, surroundtexture.cpp, surroundtexture.h, surroundview.cpp]
2026-08-17 Camera360Screen: manual calibration settings UI + persistence
    Adds a gear-icon settings panel to the 360 view for live-tuning the
    SurroundView stitching parameters (per-camera position/yaw/pitch/FOV,
    vehicle dimensions, ground extent, wedge overlap) instead of relying on
    defaultCalibration()'s placeholder rig. CalibrationStore persists to
    /data/calibration.json (same load/save pattern as OdoStore) and every
    edit live re-warps the mesh via a new calibrationChanged() signal, no
    restart needed.
    Two real bugs were caught via on-device screenshots during verification:
    anchors.fill silently overriding the panel's slide-in x binding, and a
    missing minus-sign glyph on the target font (same class of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
    [calibrationstore.cpp, calibrationstore.h, cameracalibration.cpp, cameracalibration.h, main.cpp, surroundview.cpp, surroundview.h]
2026-08-17 main.qml: add FPS overlay, top-left, visible on every screen
    Counts real QQuickWindow::frameSwapped events and reports once a
    second, so it reflects genuine render-thread activity rather than a
    fixed-interval guess — verified on hardware reading ~1 FPS when idle
    (matching the clock's once-per-second tick, the only thing driving a
    redraw with no CAN data flowing) and ~35 FPS during active needle
    animation. Layered above every dash screen (diagnostic, camera grid,
    360 view + calibration panel, time-set), below only the boot splash.
2026-08-17 main.qml: crop car_lights overlays to their actual content
    car_lights_off.png/car_lights_on.png were composited as full 1600x720
    quads even though the car artwork only occupies a small box in the
    middle (96%/94% of each canvas was fully transparent margin). Cropped
    both assets to their real alpha bounding box and repositioned with
    fixed x/y instead of anchors.fill — verified pixel-identical by
    reconstructing the original from the crop plus offset before deploying.
    Found via QSG_RENDER_TIMING profiling on hardware while chasing why the
    new FPS overlay read ~35-40 on the main gauge cluster: sync/swap were
    cheap but render cost was consistently 15-22ms/frame, and it barely
    changed when other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
2026-08-17 Package mycam004m fake driver into the Yocto build, enabled by default
    Adds a kernel-module recipe building mycam004m.ko/mycam004m-fake.ko from
    the sibling ~/code/mycam004m repo, installs the fake backend's firmware
    and autoloads it at boot, and runs select-camera-backend.sh fake via a
    new systemd unit so /dev/mycam/cam1..4 resolve with no manual steps —
    replacing the driver repo's previously fully-manual insmod/scp workflow.
    Hardware-verified: all 4 cameras probe cleanly and their captured frames
    are byte-identical to the reference images. The real backend's .ko builds
    too but stays inert (its devicetree overlay is untouched) since no
    MY-CAM004M hardware is attached yet.
    Also brings GAUG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
2026-08-17 CameraGridScreen: fix 2-3fps camera perf via persistent GL texture + decimation
    CameraView was a QQuickPaintedItem handing QPainter a fresh QImage every
    frame, which forces Qt's GL paint engine to reallocate a GPU texture on
    every single paint (QImage::cacheKey() changes unconditionally on
    detach()). Rewritten as a QQuickFramebufferObject with a persistent
    SurroundTexture updated via glTexSubImage2D, mirroring SurroundView's
    already-working pattern.
    CameraFeed now decodes/exposes frames at half resolution (kDecimation=2)
    instead of the driver's full 1920x1080 grant — CameraGridScreen only ever
    displays a feed at roughly a quarter of the window, so full-res decode was
    mostly wasted work. S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
    [camerafeed.cpp, camerafeed.h, cameraview.cpp, cameraview.h, main.cpp, surroundview.cpp]
2026-08-17 Remove unused simulated_cameras.png placeholder fallback
    Was shown full-screen on CameraGridScreen/Camera360Screen when every
    camera feed had failed or timed out. Dropped along with both usages;
    the underlying showPlaceholder/fallbackTimer state that also gates
    SurroundView/CameraView visibility is untouched.
2026-08-17 360 view: real car dims in inches, aspect-correct scale, car icon overlay
    Calibration switches from meters to inches (CameraCalibration's pos
    fields, SurroundGeometryConfig's vehicle/ground-extent fields) and the
    default rig now uses this car's actual measured dimensions (164in
    nose-to-tail, 75in mirror-to-mirror) instead of placeholder values.
    WarpMesh::build() previously normalized each screen axis independently
    to its own ground half-extent, which always fills the full [-1,1] NDC
    range on both axes regardless of the capture rectangle's real shape --
    silently stretching a non-square capture area to fit a differently-
    shaped viewport. Now takes the FBO's viewport size and computes one
    inch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
    [calibrationstore.h, cameracalibration.cpp, cameracalibration.h, surroundview.cpp, warpmesh.cpp, warpmesh.h]
2026-08-17 Camera360Screen/CameraGridScreen: fix reopen race that blanked to placeholder
    open() unconditionally restarted the 2s fallback timer and relied on
    onAnyStreamingChanged to cancel it once frames arrived. But these two
    screens share the same feeds[], so if one is opened while the other
    already left the feeds streaming, anyStreaming is already true and
    never changes value -- the change handler never re-fires, the timer
    fires unimpeded, and the screen blanks to the placeholder over a
    perfectly working stream. open() now checks current streaming state
    instead of blindly restarting.
    Reproduced on real hardware (opened CameraGridScreen, then
    Camera360Screen on top without closing it first) and con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
2026-08-18 Turn-signal camera overlays + page-indicator dots
    Blind-spot-style popups show cam3/cam4 centered on the speedo/tach
    needle pivot horizontally, screen-centered vertically, while the
    matching turn signal is latched on (debounced against real-hardware
    double-fire, held across the flasher's off-phase). Adds a debug L/R
    keyboard trigger for the signals on dev builds, and a shared
    PageIndicator dot row across the main/camera-grid/diagnostic screens.
2026-08-18 Add hazard signal — MCE18 DIN7, both turn signals, no camera overlay
    New hazard boolean sourced from DIN7 on the MCE18 expander (0x702
    frame) -- the one bit GAUGE-CLUSTER.md's table already had reserved
    for future use. Kept as its own CanBus property rather than folded
    into leftIndicator/rightIndicator, since the two need different
    display treatment.
    Turn-signal icons show sim.hazard in place of (not OR'd with)
    leftIndicator/rightIndicator while hazards are latched active, not
    just OR'd in: leftIndicator/hazard are independent waveforms with no
    shared phase (independent blink timers in the debug path, no
    guaranteed alignment from real CAN either), so a plain OR let left and
    right flash ou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
2026-08-18 Trip odometer: extra space before reset button, nudge button down 3px
2026-08-18 Turn signal cameras: gate on raw signal level instead of 1s latch
    Confirmed the CAN input is a static level (on while engaged, off the
    instant it's cancelled), not the flasher's own on/off waveform the
    overlay latch/hold design assumed. Camera overlays now bind directly to
    sim.leftIndicator/rightIndicator with no hold timer, so they open/close
    instantly with the signal. Dash icon blink is synthesized instead from a
    single shared QML clock (was previously relying on the CAN signal itself
    to oscillate).
    [canbus.cpp, canbus.h]
2026-08-18 Gear: rework encoding to a plain PRN1234567 string index, add debug Up/Down key stepping
    Replaces the -2=P/-1=R/0=N/1..8 scheme with a single index into
    "PRN1234567" (0=P 1=R 2=N 3..9=1st..7th), so the dash's gear glyph is a
    plain string lookup instead of an if/else chain. Adds debugGearUp()/
    debugGearDown(), wired to the Up/Down arrow keys alongside the existing
    L/R/H debug triggers, for exercising the gear indicator without real CAN
    hardware. On dev/simulate builds the first press latches a manual-override
    flag so the 2s auto-cycle self-test stops fighting the debug key.
    [canbus.cpp, canbus.h]
2026-08-18 BeaglePlay: enable onboard WL1807 WiFi, connect to Skynet
    The WL1807 (WiLink8) is physically on the board and SDIO-probed every
    boot already — it was only disabled because the firmware/wpa_supplicant
    side was never ported to the Yocto build (see prior ultima-no-wifi.cfg).
    Re-enables CONFIG_WLCORE/WLCORE_SDIO/WL18XX, adds wpa-supplicant, and
    bakes wpa_supplicant-wlan0.conf for the Skynet network with
    wpa_supplicant@wlan0.service enabled via ROOTFS_POSTPROCESS_COMMAND.
    linux-firmware's own wl18xx split package builds empty in this
    environment (WHENCE and the source file are both fine, but
    copy-firmware.sh drops it before do_install) — vendors just the one
    firmware file the driver actually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
    [ultima-no-wifi.cfg, ultima-wifi.cfg]
2026-08-19 BeaglePlay: reconfigure WiFi as a standalone AP ("Ultima RS")
    Replaces the same-day wpa-supplicant/Skynet STA setup with hostapd —
    WL1807 is single-radio, so being a Skynet client and hosting this
    board's own AP were never both available at once; AP-only was the
    explicit choice over a runtime mode-switch.
    SSID/passphrase are deliberately not in git: hostapd has no include=
    directive (confirmed against its source, despite the first draft
    assuming it did), so a small ultima-hostapd-config oneshot assembles
    the real config at boot from the static base plus /data/wifi-ap.conf,
    which isn't tracked and has to be provisioned once per device.
    Originally planned for 5GHz/channel 36 (avoids a DFS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
2026-08-19 Reverse gear: dedicated single-feed rear camera, 360 view now manual-only
    Reverse used to auto-open the full stitched Camera360Screen; that's
    not what a real backup camera shows. RearCameraScreen now auto-opens
    on reverse gear instead (cameraFeed2 raw, no stitching/calibration
    UI), and Camera360Screen only opens via the 360 icon tap.
    toggleCamera360() keeps the two mutually exclusive when the driver
    manually opens the 360 view mid-reverse: it hides the rear-cam screen
    first, and closing it hands back to the rear cam if still in reverse
    rather than dropping to the plain dash underneath.
2026-08-19 360 view: open by tapping the car instead of a dedicated icon, close on tap anywhere
    car_lights_off/car_lights_on now open Camera360Screen directly (routed
    through main.qml's toggleCamera360() so the reverse-gear/RearCameraScreen
    hand-back stays intact); the overlay itself closes on a tap anywhere except
    over the calibration panel, via a new closeRequested signal. Drops the
    now-unused icon360 button and its icon_360.png asset (already missing from
    disk, orphaned qrc entry).
    Also recenters the axle lift indicator at (445, 680).
2026-08-19 Dash: low-fuel warning icon turns fuel-pump badge red under 1/4 tank
    Overlays a red/white version of the fuel-pump badge (extracted from
    background_overlay.png so it lines up pixel-perfect) once fuelLevel
    drops below 0.25, mirroring the existing coolantWarn threshold pattern.
2026-08-19 BeaglePlay: abandon WiFi AP + captive portal, revert to Skynet client mode
    Real-device testing showed the auto-popup captive-portal UX is
    unreliable across OS/version combos and not worth iterating on through
    destructive reflash cycles. Bluetooth is the new plan for phone-facing
    settings. WiFi is back to wpa_supplicant STA-to-Skynet, with the
    passphrase kept out of git this time via a static-base + /data secret
    file assembled at boot (same pattern the AP work built for hostapd).
    Also fixes a bug hit along the way: emmc-install.sh's image write is a
    whole-disk dd, which was silently wiping /data (odometer state, WiFi
    credentials) on every reflash. Now backs up /data before the write and
    rest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
2026-08-19 BeaglePlay: wire up avm-benchmark bitbake target, ignore recipes-avm/
    build.sh gains an optional bind mount + target for avm-benchmark (a
    standalone CMake/Qt5 recipe under recipes-avm/, run via
    ./build.sh avm-benchmark). recipes-avm/ and test/avm-benchmark stay
    untracked/gitignored, same as the mycam004m sibling-repo pattern.
2026-08-19 BeaglePlay: regenerate boot splash from updated ULTIMA RS art
    splash.rgbx was a stale conversion of the old splash screen.png (headlights
    off, silver wheels). Re-ran the conversion documented in NOTES.md against
    the new art (headlights on, gold wheels) so the pre-Qt framebuffer splash
    matches what ships now.
2026-08-19 Dash: animate splash screen into gauge cluster on startup
    Adds a splash-to-cluster intro to main.qml: on launch, shows the "ULTIMA
    RS" splash art with a car cutout overlaid at the exact spot it occupies in
    that art (pixel-matched by diffing the two source PNGs, not eyeballed), so
    Qt's first frame is identical to what the pre-Qt framebuffer splash already
    painted and the modeset handoff stays invisible. Over ~1s the splash
    background fades out while the car cutout shrinks/moves/fades onto
    car_lights_off's own rect, handing off to the live dash. The existing
    needle self-test sweep now waits for this to finish before it runs.
    Bundles splash_screen.png/splash_car_start.png into ultima-app/src a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
2026-08-19 Camera sim: ULTIMA_CAM_IMAGE_DIR shows real photos instead of test bars
    Dev-only override for the non-Linux simulateTick() path -- when set,
    loads <dir>/camN.png once and shows it instead of the procedural
    sliding-bar pattern, so the macOS dev build can be pointed at the same
    real reference frames the on-target mycam004m-fake driver serves.
2026-08-19 Debug hook: /tmp/ultima-indicator.request toggles turn signals over SSH
    Same polled-file pattern as the screenshot/camtest triggers -- lets
    left/right/hazard be toggled on-device without a keyboard, by calling
    the same Q_INVOKABLE toggles main.qml's Keys.onPressed already uses.
2026-08-19 CameraView: real GLSL mirror-view reprojection for left/right overlays
    Replaces the raw fisheye passthrough on leftCamOverlay/rightCamOverlay with
    a per-pixel reprojection (mirror.frag) that reframes cam3/cam4 as level,
    narrow-FOV rearward mirror views instead of straight-out fisheye. Ported
    from a standalone ffmpeg v360 prototype, but the fit parameters didn't
    transfer directly — ffmpeg's internal rotation convention differs from this
    shader's, so roll needed its sign flipped (and a small magnitude retune)
    after visual comparison against the live macOS dev build. CameraGridScreen's
    raw 2x2 view is untouched (mirrorViewSide left unset there).
    [cameraview.cpp, cameraview.h]
2026-08-19 mirror.frag: horizontally flip left/right turn-signal cam overlays
    rotatedBasis() only re-aims the virtual camera (pure rotation, can't
    change handedness), so the reprojection was reading as a plain camera
    crop -- car's own fender toward the outer edge of leftCamOverlay/
    rightCamOverlay. A real side mirror reflects: fender toward the inner
    edge, open road toward the outer edge. Verified on both the macOS dev
    build (real fisheye reference frames) and on-hardware, real cam3/cam4
    footage.
2026-08-19 Docs: fix drift in CLAUDE.md/GAUGE-CLUSTER.md/NOTES.md
    CLAUDE.md's "No WiFi in this build" rule was wrong -- WL1807
    STA-to-Skynet client mode was enabled 2026-08-18/19. Correct the rule
    and fix three matching stale WiFi claims in NOTES.md.
    GAUGE-CLUSTER.md: document the turn-signal camera mirror-view overlay
    feature (CameraView's mirrorViewSide/mirror.frag) that shipped
    undocumented; fix references to the removed icon_360.png tap icon and
    simulated_cameras.png fallback; correct car_360.png's now-active role;
    fix the MCE18 fuel-sender scaling formula and the DIN0/DIN1/DIN7
    waveform-vs-level claim (confirmed static level by a later commit);
    fix the stale mapMax/boost-reads-0 note now that boo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
2026-08-19 Dash: show --:-- instead of a stale time flash at boot
    The system clock holds a stale boot-default value (e.g. the kernel's
    own build timestamp) until ultima-hwclock-load.service pulls the real
    time from the onboard BQ32002 RTC, which briefly flashed the wrong
    time on the dash clock every boot. SystemClock::timeIsValid() reads
    /dev/rtc0 directly and compares against the system clock -- the same
    signal ultima-hwclock-load itself trusts -- and clockText shows --:--
    until it agrees.
    First attempt compared against this binary's own compile-time
    build timestamp instead, on the theory that the stale default is
    always earlier. Broke hard on redeploy: the Docker build container's
    clock had drifted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
    [systemclock.cpp, systemclock.h]
2026-08-19 OdoStore: reset total odometer to 0
    Requested directly, not tied to a bug. Changed DEFAULT_TOTAL_ODO from
    2347.0 (already itself a fallback, not a live-tracked value -- the
    real odometer reading was lost in an earlier eMMC reflash before the
    /data backup fix existed) to 0.0, and reset the persisted value on
    target the same way.
    [odostore.cpp]
2026-08-20 Add Bluetooth: BLE advertising via USB dongle, Android GATT spec
    Peripheral-role BLE advertising ("Ultima RS") over a USB CSR8510 dongle,
    opened from a small glyph on the main dash. The originally-planned path
    (reflashing the onboard CC1352P7) turned out to be a dead end per TI's
    own docs: the network-processor firmware runs its own on-chip Host
    stack, so it can't feed BlueZ at all. The USB dongle needed zero custom
    code (btusb driver just picks it up).
    Confirmed working on real hardware via HCI trace and cross-checked from
    Windows. Neither iOS nor Android's built-in Bluetooth settings can pair
    with a bare advertising-only peripheral like this, so the on-screen text
    was corrected to stop im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
    [main.cpp]
2026-08-20 Bluetooth: pivot BLE app to MCE18 AUX control instead of config
    Replaces the never-implemented config-surfaces GATT design (time/odometer/
    calibration/WiFi) with a real Ultima AUX Control Service: 4 write
    characteristics for the MCE18's AUX1-4 outputs (AUX4 PWM-capable, this
    car's V4 unit), a state readback, and a status/error channel.
    CanBus gains its first CAN Tx path (setAux/allAuxOff/sendAuxFrame) to the
    MCE18's AUX-command frame, plus a 100ms defensive refresh while any output
    is non-zero, since the MCE18/CFE18 manual doesn't document whether the
    frame is a one-shot latch or needs a heartbeat. BluetoothManager forces all
    outputs off immediately on BLE disconnect rather than relying on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
    [canbus.cpp, canbus.h, main.cpp]
2026-08-20 Docs: update ANDROID-BLE-INTEGRATION.md status now that AUX control is implemented
    Written as a pre-implementation spec, then never revisited after the
    implementation commit — it still said the GATT service and CanBus Tx path
    "don't exist" and "need to be added." Updates the status section and the
    addService()/CAN-Tx passages to describe what's actually there: implemented,
    compiles on both toolchains, never run against the target's Qt5/BlueZ stack
    or a real MCE18.
2026-08-20 Bluetooth: BlueZ pairing agent, authenticated AUX writes, bonded-device persistence
    QBluetoothLocalDevice never actually registered a working BlueZ pairing
    agent (confirmed on real hardware: every pairing attempt failed with
    "No agent available for request type 2"), so pairing confirmation now
    goes through an explicit org.bluez.Agent1 implementation (BluetoothAgent)
    registered with IO capability DisplayYesNo. AUX write characteristics
    now also require AttAuthenticationRequired, closing the gap where a
    Just Works bond could energize a physical output without ever showing a
    confirmation code. Bonds now persist across reboots by bind-mounting
    /data/bluetooth over BlueZ's tmpfs-backed /var/lib/b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
2026-08-20 Bluetooth: unpair devices + live AUX status in the touchscreen UI
    BluetoothScreen.qml gains two cards in the screen's previously-empty
    right side: a live AUX1-4 status readout (CanBus's new auxStates
    property, NOTIFY'd on every change) so a connected companion app's BLE
    writes are visible on the dash without a scope on the physical output,
    and a bonded-devices list with a per-device FORGET action
    (BluetoothManager::forgetDevice(), Adapter1.RemoveDevice over D-Bus,
    which unpairs and disconnects in one call). Also fixes a real bug this
    session's testing exposed: BluetoothScreen.qml referenced
    bahnschriftFont/rangeFont without ever declaring them, so its text was
    silently falling back to the de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
    [canbus.cpp, canbus.h, main.cpp]
2026-08-21 Bluetooth: remove the feature entirely
    Reverses the Bluetooth work end to end: BluetoothManager/BluetoothAgent,
    BluetoothScreen.qml and its touchscreen glyph, the CanBus AUX-control Tx
    path that existed only to serve BLE-driven MCE18 output commands (no other
    caller), the Yocto bluez5/qtconnectivity/DISTRO_FEATURES wiring and bond
    persistence units, and ANDROID-BLE-INTEGRATION.md. Also drops the
    now-resolved "Bluetooth via CC1352P7" investigation from NOTES.md.
    [canbus.cpp, canbus.h, main.cpp]
2026-08-21 CAN: replace USB adapter with mikroBUS SPI click (MCP2515)
    Retires the ODrive USB-CAN adapter in favor of a MikroE CAN SPI 3.3V
    click on BeaglePlay's mikroBUS header, wired to the same Syvecs S7+
    CAN2 bus. Since Falcon boot skips U-Boot proper (no stage to apply a
    runtime .dtbo overlay), the MCP2515 device tree node is baked in at
    kernel build time via a patch against the stock upstream
    k3-am625-beagleplay.dts, alongside the matching kernel config and a
    udev rule keyed on the mcp251x driver instead of a USB VID/PID.
    Hardware-verified 2026-08-21 up through the SPI/kernel path (mcp251x
    driver correctly probes spi0.0 and times out only because the click
    board isn't physically connected yet); f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
    [ultima-can.cfg]
2026-08-21 build: fix mycam004m sibling-repo path and SMB ghost-file copytree failure
    Two pre-existing environmental bugs, unrelated to any specific feature,
    that block build.sh on this checkout:
    - MYCAM004M_SRC resolved via ../../mycam004m, which only works when
    UltimaGC is checked out under ~/code/ alongside its sibling repos.
    This checkout lives on a mounted network share instead, so the
    relative path silently missed and mycam004m.bb failed on a missing
    LICENSE from the empty fallback stub. Now also tries ~/code/mycam004m.
    - ultima-app/src's SMB mount accumulates stale, lock-stuck
    .smbdeleteAAA* files (macOS smbfs's rename-based delete-on-network-
    share artifacts) that broke do_unpack'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
2026-08-21 CAN: MCE18 protocol fix + temporary USB-CAN adapter for bench testing
    canbus.cpp's AIN0 (fuel sender) decode assumed raw 0-1023 ADC counts, but
    the unit's actual DSS configuration is the CANchecked 0-5000mV protocol —
    the extra raw-to-mV scaling step was double-converting. Read AIN0 as
    millivolts directly instead.
    Temporarily re-adds gs_usb (ODrive USB-CAN adapter) alongside the MCP2515
    SPI click's kernel config/udev rule, since the click isn't physically
    seated on the mikroBUS header yet. Needed a working CAN bus to test the
    MCE18 configuration and confirm real traffic end-to-end; drop this again
    once the click is seated and verified.
    GAUGE-CLUSTER.md records what bench testing (real MC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
    [ultima-can.cfg]
2026-08-21 Docs: add ODrive USB-CAN adapter datasheet
2026-08-22 Add MY-CAM004M docs
    [引脚.xlsx]
2026-08-22 Update docs
    [引脚.xlsx]
2026-08-24 Enable the real mycam004m camera backend at boot, UYVY end to end
    Camera hardware is attached and hardware-verified (see NOTES.md):
    - Compile-time k3-am625-beagleplay.dts patch adding the camera@31 node
    (Falcon boot never runs fdtoverlays, so the driver repo's runtime
    .dtso can't be used).
    - Real backend is now the boot default: mycam004m-real.conf force-loads
    j721e-csi2rx/cdns-dphy-rx/mycam004m (same udev-coldplug gap as
    CONFIG_DRM_TIDSS), select-camera-backend.service resolves
    /dev/mycam/cam1..4 to the real capture nodes.
    - New mycam004m-configure-pipeline oneshot: sets the active subdev
    format on the csi-bridge/ticsi2rx entities (they boot with a default
    active format that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
2026-08-24 ultima-app: camera capture/decode is UYVY, not YUYV
    Real hardware proved the N4 decoder emits UYVY byte order -- decoding
    it as YUYV was the green/magenta mess on the CAMERAS screen. Request
    and validate V4L2_PIX_FMT_UYVY, and swap the byte offsets in the
    (renamed) convertUYVYToRGB32 loop. Matches the same switch in the
    mycam004m driver repo and the pipeline bring-up script.
    [camerafeed.cpp, camerafeed.h]
2026-08-24 NOTES: first real picture through the camera path; driver fixes verified
    Documents the 2026-08-24 bring-up: the camera works (the 08-23 'cameras
    mute' verdict was reached on a config that cannot lock), the three
    driver bugs found live over I2C (no AFE bring-up, YUYV-vs-UYVY,
    arbiter enabling all four channels interleaves them onto stream 0),
    their implementation in the driver repo, and the end-to-end
    verification (30fps, all 1080 lines, app screenshot). Also records the
    VC-filtering answer from the 6.12 RX source, the camgrab2 tool, the
    no-live-module-reload gotcha, and the boot-regenerated SSH host key.
2026-08-24 Docs/assets: unzip MYD-LT527 BSP, MY-CAM004M manual, pin mapping; enclosure CAD, AVM models
    - docs/MY-CAM004M/MYD-LT527/: the NVP6324 vendor BSP reference tree,
    committed unzipped (replaces the .zip) since driver work greps it
    constantly; plus the English MY-CAM004M product manual.
    - docs/: MY-CAM to BeaglePlay pin mapping sheet (PDF + source PSD).
    - enclosure/: STEP/STL models for the enclosure and its components.
    - models/: AVM (A360K*) surround-view model files and extractions.
    [687124149022_Wurth_24pin_0p5_bottom_hinge.stp, CAN_SPI_click_3.3V_v100.step, Enclosure rev1.step, FH12-24S-0.5SH.stp, MCE18 Dummy.stl, MY-CAM Holder.step, MY-CAM Holder.stl, MY-CAM004M_PCB_65x50x1p6.step]
2026-08-24 NOTES: correct an overclaim about the 08-23 dead-camera verdict
    The earlier phrasing said the 08-23 'cameras are mute' conclusion was
    reached on a config that couldn't lock anything -- true of the driver's
    baked-in init, but that session had already gone further: it replayed
    the same full AFE bring-up live and still got no lock, plus an
    independent physical test (video-line DC bias not responding to light
    at all, across every unit) that no register config can explain away.
    This session's picture came from a different, known-good source (the
    BY-J box), not the original camera modules, so it proves the
    driver/pipeline is correct -- it doesn't reopen the original verdict.
2026-08-25 NOTES: flashed the image, found a cold-boot I2C probe race (worked around, not yet fixed)
    First true cold boot of the freshly-flashed image hit mycam004m probe
    failing with -EREMOTEIO -- every prior verification was a warm module
    reload on a board with settled power rails, never an actual cold
    power-on. A manual re-probe succeeded immediately and reproduced the
    same clean 30fps capture and app screenshot. Documented as a real,
    unfixed edge case (probe-time race, or insufficient power-on-delay
    margin on true cold start) rather than glossed over.
2026-08-25 Rename board hostname from beagleplay-ti to ultimagc
    Overrides base-files' default (${MACHINE}, i.e. "beagleplay-ti") for
    this machine so /etc/hostname, /etc/hosts, and mDNS (avahi derives its
    .local name from the system hostname) all say "ultimagc" instead.
    Verified against a real build (do_install output shows /etc/hostname =
    "ultimagc") and hot-patched onto the currently-booted SD card for
    immediate effect -- the live edit doesn't need reverting, since the
    next flash will carry the same value from source.
2026-08-25 Enclosure: update pin mapping doc, revise MY-CAM holder to two-piece print
    Replace the single-piece rev1 enclosure/holder STEP/STL with a
    top+bottom split (enclosure/print files/), add the USB hub support
    piece, and touch up the BeaglePlay pin mapping PSD to match.
    [Enclosure rev1.step, MY-CAM Holder Top.step, MY-CAM Holder bottom.step, MY-CAM Holder.iges, MY-CAM Holder.step, MY-CAM Holder.stl, USB Hub Support.step, bust_1.stl]
2026-08-26 mycam004m: load driver with fps=25 for the new AHD surround cameras
    The new "SZ-2053/3077S" surround-view cameras (GC2053 + Fullhan-class AHD
    encoder, from an Amazon BY-J 360 kit) output AHD 1080p at 25fps, not 30.
    The driver's compiled-in default is fps=30 (AHD_MD=0x02), at which these
    cameras only half-lock (NOVID clears but H_LOCK stays 0 -- no usable
    video). Ship /etc/modprobe.d/mycam004m-options.conf with
    `options mycam004m fps=25` so the autoloaded module programs AHD_MD=0x03
    (1080p25) and fully locks.
    Hardware-verified 2026-08-25: after re-pinning a camera's 4-pin barrel to
    match the MY-CAM CJ-BM4-M11 jack order (the cameras were a 5V pin-order
    mismatch, not a 12V/power problem as th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
2026-08-26 ultima-app: camera display 4fps -> 25fps (cached buffers, NEON, zero-copy)
    Root cause of the ~4fps camera views: V4L2 MMAP buffers are mapped
    uncached, and the scalar UYVY->RGBA convert did ~1M byte loads per frame
    from that mapping on the GUI thread (~240ms/frame). Fixes, all
    hardware-verified at 25fps (the cameras' full rate):
    - Request CPU-cacheable capture buffers (V4L2_MEMORY_FLAG_NON_COHERENT;
    j721e-csi2rx already allows cache hints). Convert: 240ms -> 8.9ms.
    - NEON UYVY->RGBA (vld4q_u8): 8.9ms -> 3.6ms.
    - Per-feed capture thread; the GUI thread now only receives a
    ready-QImage pointer swap.
    - Zero-copy display path: VIDIOC_EXPBUF dma-bufs imported as
    EGLImage/GL_TEXTURE_EXTERNA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
    [camerafeed.cpp, camerafeed.h, cameraview.cpp, cameraview.h, dmabuftexture.cpp, dmabuftexture.h, main.cpp, shadermanager.cpp]
2026-08-26 SetTimeScreen: add month/day/year steppers, SystemClock now sets full date
    Previously SystemClock::setTime() only took hour/minute and reused
    whatever date the system clock currently held. That's wrong during an
    RTC-oscillator-failure recovery (see NOTES.md's bq32k "Oscillator
    Failure" case): the system clock is stuck at its stale boot default,
    so tapping Save from the dash would silently write that wrong date
    back to the RTC along with the corrected time. setTime() now takes
    year/month/day too and validates the date before writing it.
    [systemclock.cpp, systemclock.h]
2026-08-26 CAN: mikroBUS click seated and SPI-verified on eMMC image
    MCP2515 now enumerates and initializes over SPI (can0/spi0.0 present,
    mcp251x+can_dev loaded) after rebuilding from clean HEAD, building the
    previously-missing eMMC SPL, and reflashing eMMC via the SD-boot detour.
    A real step up from the 2026-08-21 empty-socket -110 timeout. CAN2 wiring
    to the ECU, termination jumper, and bitrate/candump verification are still
    outstanding.
2026-08-26 Enclosure: add base plate CAD, drop bust print files
    Enclosure Base.step is the new enclosure base plate model. bust_1.stl/
    bust_2.stl were unrelated decorative print files, no longer needed.
    [Enclosure Base.step, bust_1.stl, bust_2.stl]
2026-08-27 ultima-app: WIP dashcam recording — UYVY->MJPEG encode spike (turbojpeg)
    Per-feed capture-thread JPEG encode of the 4 camera streams to disk,
    gated by ULTIMA_CAM_RECORD_FPS / ULTIMA_CAM_RECORD_DIR (opt-in, off by
    default). UYVY deinterleaves straight to planar 4:2:2 (TJSAMP_422, no
    resampling) into tjCompressFromYUVPlanes. Phase-accumulator decimation
    off the DQBUF cadence.
    Software H.264 (openh264) was tried and reverted the same day: ~233ms/
    frame @ 1080p (~3.5fps) vs a 15fps target on the A53 cores — not viable.
    turbojpeg measured ~67ms/frame.
    Still a throughput spike, not a recorder: writes a single overwriting
    <camId>.jpg per camera — no muxing/segmenting/rotation, no storage
    ta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
    [camerafeed.cpp]
2026-08-27 docs: add BeagleY-AI (AM67A/J722S) evaluation for HW dashcam recording
    Go/no-go paper eval motivated by the AM625 software-encode bottleneck on
    the dashcam-recording branch. Every claim tagged [TI-verified] vs
    [inferred].
    Findings: AM67A's Wave5 codec (HW H.264/H.265/MJPEG, 8x1080p channels,
    V4L2 M2M) solves the encode bottleneck — 4x1080p25 is ~41% of the 500 MP/s
    ceiling at ~zero CPU, and beats the TDA4VM (2x1080p, H.264-only). Real
    remaining risk is 4-camera simultaneous CSI-2 VC capture on J722S
    (validation plan Phases 0-2 on a ~$70 board). Falcon boot is family-
    capable (J722S shares the am62x bootflow) but not productized for J722S —
    self-provisioned wiring, same as the AM625 enab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
2026-08-27 docs(beagley-ai): add CSI connector compatibility finding
    BeaglePlay J17 and BeagleY-AI both use the standard 22-pin 0.5mm RPi CSI-2
    connector (verified from the project pin-map PDF + BeagleBoard docs), so
    the CSI-2 core maps 1:1 and a stock camera FFC seats on either. Not
    plug-and-play for this project though: the MY-CAM004M N4 board is a 24-pin
    custom harness with off-ribbon 5V/PWREN leads, and the CSI-RX/I2C/GPIO
    mapping is redone in DT regardless. Net: connector is not a blocker, no
    adapter needed.
2026-08-27 docs(beagley-ai): add CAN bus section (RPi MCP2515 HAT path)
    BeagleY-AI has no mikroBUS, so the current CAN SPI click can't seat.
    Native AM67A MCAN is routed to the CSI connectors (needs a breakout,
    competes with cameras) — not turnkey. Recommended path: RPi 40-pin
    MCP2515 SPI CAN HAT (e.g. Waveshare 2-CH Isolated, ASIN B087RJ6XGG),
    same MCP2515+SN65HVD230 chipset so mcp251x driver / 70-can.rules /
    CanBus carry over unchanged. Key gotcha documented: the HAT's crystal is
    8 or 12 MHz, not the 10 MHz the current DT hardcodes — read it off the
    board and update fixed-clock. Updated cost-of-switch + bottom line.
2026-08-28 beagley-ai: add new Yocto layer for BeagleY-AI (AM67A/J722S) bring-up
    New sibling layer meta-ultima-beagley-ai-src, kept apart from
    meta-ultima-beagleplay-src (same "unrelated concerns" reasoning as
    meta-falcon-beagleplay). Provides the tisdk-uenv fix for meta-arago's
    missing beagley-ai uEnv-sk.txt, the beagley-ai-scoped image/hostname/qtbase
    overrides, and a linuxfb-first ultima-app.service for first hardware
    bring-up. Verified: MACHINE=beagley-ai tisdk-base-image builds clean with
    ultima-app packaged and the correct 3-partition .wic. No board in hand yet
    to flash/verify on hardware. Full build-log detail in
    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
2026-08-28 docs(beagley-ai): add storage section (no onboard eMMC)
    BeagleY-AI has no eMMC — only microSD (with UHS-I) plus PCIe Gen2 x1
    NVMe or USB 3.1 as higher-speed options, both still SD-mediated at
    boot since the ROM can't chain-load straight to them. Documents the
    boot ROM order and the NVMe HAT connector caveat (RPi5-style
    flat-flex, not standard M.2).
2026-08-28 beagley-ai: fold build.sh support in, check Falcon feasibility
    build.sh now takes BOARD=beagley-ai (defaults to beagleplay-ti),
    auto-bootstraps tisdk/build-beagley-ai from a fresh volume (MACHINE
    flip, ti-falcon override commented out, shared sstate), and syncs both
    meta-ultima-* layers every run. Verified with a real end-to-end
    tisdk-base-image build through the script (8918/8918 tasks). Also
    fixes a pre-existing bug in the layer sync: a stray .smbdeleteAAA*
    ghost file (SMB rename-then-unlink artifact) could break the
    container's cp -a mid-traversal — now staged through rsync
    --exclude='.smbdelete*' first.
    Looked into porting Falcon boot mode to BeagleY-AI before attempting
    it. u-boot-bb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
2026-08-29 beagley-ai: flash first SD image, fix flash.sh sig-patch for this board
    Pulled the built tisdk-base-image out of the Docker volume and flashed it to
    the Mac's SD reader. Found before writing that flash.sh's MBR disk-signature
    patch (needed on beagleplay-ti to keep SD and eMMC PARTUUIDs from colliding
    under Falcon) would break boot here instead: beagley-ai's grub.cfg bakes in a
    static root=PARTUUID at wic build time rather than re-deriving it via Falcon's
    fdt fixup, and this board has no onboard eMMC to collide with anyway. Added
    SKIP_SIG_PATCH=1 to flash.sh for boards that don't need/support the patch, and
    wrote up the finding (plus the mtools-based method used to inspect the boot
    partition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
2026-08-29 beagley-ai: document first power-on — boot chain works, no /dev/fb0
    HS-FS auth, the custom .wks 3-partition layout, and the Wave5 encoder all
    verified working on real hardware first try. ultima-app crash-loops (SIGABRT,
    ~5s cycle) because no display driver ever creates /dev/fb0 — same class of
    bug BeaglePlay hit with tidss module-loading, never re-applied when this
    layer was created. Board powered off promptly once the crash-loop was
    identified.
2026-08-29 beagley-ai: fix crash loop offline, root-cause missing HDMI, hang on first fix attempt
    Masked ultima-app/ultima-splash via a grub.cfg kernel cmdline edit (FAT
    partition, no rebuild) - stable boot, SSH reachable. Root-caused /dev/fb0:
    GRUB never specifies a devicetree, so the kernel inherits U-Boot's own
    minimal internal DTB (main_i2c1 disabled, no HDMI bridge node) instead of
    the full kernel-target dtb our build produces, confirmed by diffing
    /sys/firmware/fdt against both candidates. Pointing GRUB at the right dtb
    directly caused a hard hang (silent, unreachable) immediately after
    ExitBootServices - reverted. Real fix is likely getting this board onto
    TI's native U-Boot boot flow (separate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
2026-08-30 beagley-ai: fix HDMI/display for real, correct earlier hang misdiagnosis
    The "hang" from the previous commit was a misdiagnosis - the test omitted
    bootargs entirely (no console=/earlycon), so the kernel booted fine but
    produced zero UART output, indistinguishable from a freeze. Confirmed by
    repeating with explicit console=ttyS2,115200n8 earlycon: boots clean.
    There is no SYSFW/secure-boot resource issue.
    Permanent fix in grub.cfg: add the devicetree line (loads the real
    kernel-target dtb instead of U-Boot's stripped internal one) plus
    console=/earlycon. Removed the systemd.mask workaround - no longer needed.
    Confirmed end to end on real hardware, including one fully unattended
    reboot: main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
2026-08-30 beagley-ai: bake display fix into the Yocto build (wks dtb= sourceparam)
    The GRUB devicetree + console/earlycon fix proven on real hardware was only
    ever applied by hand to the physical SD card. Fold it into
    ultima-beagley-ai.wks.in so a fresh build reproduces it:
    - part --source bootimg-efi ... dtb=k3-am67a-beagley-ai.dtb: bootimg-efi's
    own sourceparam for this, copies the dtb onto the FAT partition and adds
    the grub.cfg devicetree line automatically (no IMAGE_BOOT_FILES or
    grub.cfg bbappend needed).
    - bootloader --append: added console=ttyS2,115200n8 earlycon, since
    TI_WKS_BOOTLOADER_APPEND defaults to empty for this machine family.
    Rebuilt via BOARD=beagley-ai ./build.sh tisdk-b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
2026-08-30 beagley-ai: confirm baked-in display fix boots clean from a fresh image
    Reflashed with the freshly rebuilt image (not the stale local cache) and did
    a fully clean, unattended boot end to end. Closes the one open question from
    the previous commit: the plugin's linux-before-devicetree grub.cfg ordering
    is harmless. Verified via SSH: it66121/tidss/fb0 all present, zero service
    restarts, zero sig=6 crashes, ultima-app first frame swapped in 1.42s.
2026-08-30 beagley-ai: enable USB1 host controller, fixes touchscreen
    Board dts left the SoC's only USB3 host/OTG controller (usbss1/usb1,
    feeding all 4 physical USB-A ports via an onboard hub) and its underlying
    serdes_wiz0 PHY block both status=disabled — confirmed via dmesg (zero
    xhci/cdns/wiz lines, empty /sys/bus/usb/devices, not even a root hub) and
    by reading the actual dts, not guessing. Not a touch driver problem at all;
    nothing USB-attached could ever be detected.
    Ported the fix verbatim from TI's own same-SoC (J722S) EVM board dts, which
    already carries it: enable serdes_wiz0, then usbss1/usb1 with the dedicated
    USB1_DRVVBUS pin (a fixed SoC pin, not board-routed) and this board's
    already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
2026-08-30 beagley-ai: close out Falcon investigation as a dead end, land quiet cmdline instead
    Falcon on J722S/BeagleY-AI is not bounded config work like BeaglePlay's was.
    Diffed the real u-boot-bb.org tree against u-boot-ti-staging: the falcon SPL
    logic and binman template are portable (every API/firmware reference they'd
    need already exists in bb.org's tree), but the falcon fast-path depends on a
    TIFS stub firmware blob TI has never published for J722S/AM67A - confirmed
    against a live fetch of TI's ti-linux-firmware repo, including a branch
    updated 12 days prior. Only am62x/am62ax/am62px have it. No wiring fixes a
    firmware blob only TI can ship.
    With Falcon off the table, the GRUB/console lever isn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
2026-08-30 beagley-ai: Falcon boot working, 16.6 s -> 9.3-10.2 s to first frame
    The 2026-08-29 "dead end" verdict was wrong: Falcon on J722S needs no TIFS
    stub and no TI falcon code at all. The stock bb.org R5 SPL loads a FIT
    (tifalcon.bin) whose firmware is ATF and whose loadables are OP-TEE, the DM
    firmware, the kernel Image and the DTB; TF-A is rebuilt with
    PRELOADED_BL33_BASE=0x82000000 / K3_HW_CONFIG_BASE=0x88000000 so it jumps
    straight into the kernel with the DTB in x0. No A53 SPL, U-Boot proper or
    GRUB anywhere in the chain.
    - recipes-bsp/trusted-firmware-a: bbappend with the two address overrides
    (same pair meta-ti's ti-falcon override uses; defaults assume a kernel
    under ~31 MiB, ours is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
2026-08-30 beagley-ai: boot-time pass with the GPU on, 9.3 s -> 6.9 s cold to first frame
    The BeagleY-AI was still on linuxfb + the software Quick backend; turning
    eglfs_kms/PowerVR on took a warm reboot from 10.2 s to 14.1 s to first
    frame. This pass keeps the GPU and brings a cold power-on to 6.94 s
    (steady-state warm reboot 7.53 s, kernel-relative 5.17 s). Timed serial
    captures in boot-logs/, full profile and per-change numbers in NOTES.md.
    - kernel: ultima-boot.cfg fragment on bb.org_defconfig. init_kprobe_trace
    alone was 1.27 s of every boot (initcall_debug); kprobes/ftrace, KASLR,
    LSMs/IMA/audit, EFI/kexec/hibernation, PCI (dead on this DT), a dozen
    filesystems, allocation debug and module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
    [ultima-boot.cfg]
2026-08-30 beagley-ai: boot-time cycle 2 — 6.9 s -> 5.3 s cold power-on to first frame
    Root causes and fixes, in the order found (full story in NOTES.md
    "BeagleY-AI boot-time work, cycle 2"):
    - getrandom() blocked the app until 'crng init done' at 3.4 s (Qt hash
    seed, Mesa/PVR). The SoC TRNG sits behind OP-TEE; built the TEE stack
    into the kernel (CONFIG_TEE/OPTEE/HW_RANDOM_OPTEE=y) so the CRNG is
    ready at 0.24 s. main() 3.35 -> 2.43 (kernel-relative).
    - Recorded page-range readahead (new ultima-readahead recipe: record =
    mincore over /proc/pid/maps, replay = readahead(2); stale-size files
    now fall back to a whole-file read) replaces the whole-file prefetch;
    pack recorded on hardware. Ex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
    [ultima-boot.cfg]
2026-08-30 beagley-ai: document UHS/SDR104-in-R5-SPL dead end (main_gpio1 not in SPL power-domain table)
2026-08-30 remove BeaglePlay board support; BeagleY-AI is the sole target
    BeagleY-AI (AM67A/J722S) is hardware-verified and running, so the older
    BeaglePlay build, layer, scripts, and every reference to it are removed.
    - Fold the shared recipes (ultima-app, ultima-splash, ultima-data-mount,
    boot-trim) and the machine-agnostic image hardening into the single
    meta-ultima-beagley-ai layer; drop its ultima-beagleplay LAYERDEPENDS.
    - Relocate the Docker/TI-SDK build tooling (Dockerfile, run.sh, build.sh,
    flash.sh) into beagley-ai/ and make it single-board; flash.sh drops the
    eMMC MBR sig-patch.
    - Split the BeagleY-AI bring-up notes into a standalone beagley-ai/NOTES.md;
    delete beagleplay-falcon/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
    [ultima-boot.cfg, ultima-can.cfg, ultima-display.cfg, ultima-wifi.cfg]
2026-08-31 DiagnosticScreen: add CPU temp gauge, backed by a new SystemStats class
    SystemStats polls the SoC die temperature off sysfs (scanning
    /sys/class/thermal/thermal_zone*/type for a cpu/mpu/main-ish zone rather
    than hardcoding thermal_zone0 — this repo has no local J722S devicetree
    to confirm zone numbering against) and exposes it as a new `sysStats`
    context property, separate from CanBus since it's not a CAN signal.
    DiagnosticScreen.qml's channel list gets a `source` field so a tile can
    read from it instead of `sim`. No crit/warn thresholds on the new tile —
    no confirmed SoC throttle spec to draw a red line at.
    Verified on hardware: zone scan picks thermal_zone0 (type=main0-thermal,
    the on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
2026-08-31 beagley-ai: ultima-dvr-mount — hotplug automount for the dashcam recording drive
    udev rule mounts any block device labeled ULTIMA_DVR to /mnt/dvr via
    systemd-mount and unmounts it on removal. Label-matched on purpose: no
    auto-format, and unlabeled drives are left alone. Image wiring
    (IMAGE_INSTALL) lands with the camera-port commit that follows.
2026-08-31 beagley-ai: mycam004m camera on CSI0 — hardware-verified, real backend productized
    The camera port (2026-08-30) plus its bench verification and boot
    productization (2026-08-31), landed together now that the whole chain is
    proven on hardware: flash -> power on -> live AHD input-0 video on the dash
    with zero manual steps.
    Port: compile-time DT patch against the base .dts (Falcon boot runs no
    overlays) wiring the MY-CAM004M onto main_i2c2 + CSI2RX instance 0;
    mycam004m recipe builds real + fake backends from the external
    ~/code/mycam004m repo (bind-mounted by build.sh, same pattern as
    ultima-app). Both former unknowns are bench-confirmed: CSI0 IS instance 0,
    and the no-reset/pwren-GPIO power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
2026-09-01 beagley-ai/NOTES: correct the camera-warp hardware diagnosis
    The bench diagnosis moved after the productization commit; NOTES still had
    the stale version. Corrections:
    - The recurring N4 I2C dropout was a loose power connector on the MY-CAM004M
    board, not the FFC or the host (reseat -> 0 I2C errors next boot).
    - The camera analog warp is the board's ONE standing electrical fault. It
    rests on the A/B result alone (same camera+decoder+coax+FFC clean on the
    BeaglePlay, sheared on the AI, off the SAME 5V supply -> upstream supply
    exonerated, swap test moot). Since the analog input path is identical
    between hosts and a decoder-side register/EQ sweep changed nothing, the one
    host-depe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
2026-09-01 beagley-ai: camera self-heal (app measure + driver relock), boot into camera grid for debugging
    The N4 AFE's horizontal PLL lock is stochastically marginal on this board —
    a stable ~2px/line shear that H_LOCK doesn't flag. camerafeed.cpp now
    measures per-frame row-slip and, when it detects a sheared lock, pokes the
    driver's "relock" sysfs attribute (PD_VCH power-cycle on the streaming
    channel) to re-roll the lock, with hysteresis and a settle window so it
    doesn't fight the AFE mid-recovery.
    autorate=0 (mycam004m-options.conf) turns off the driver's rate watchdog,
    which was fighting this: on a transient unlocked poll it flipped 25p<->30p,
    and the wrong-rate decode was indistinguishable fro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
    [camerafeed.cpp, main.cpp]
2026-09-01 enclosure: remove obsolete CAD files
    [687124149022_Wurth_24pin_0p5_bottom_hinge.stp, CAN_SPI_click_3.3V_v100.step, Enclosure Base.step, FH12-24S-0.5SH.stp, MCE18 Dummy.stl, MY-CAM Holder Top.step, MY-CAM Holder bottom.step, MY-CAM Holder.iges]
2026-09-01 beagley-ai/ultima-app: remove mycam004m driver, CameraFeed shows placeholders
    Deletes the mycam004m Yocto recipe (kernel DT patch, systemd units,
    modprobe/backend-select scripts) and the driver bring-up narrative in
    NOTES.md — starting the camera driver over from scratch.
    CameraFeed no longer touches V4L2 at all: setActive() shows a placeholder
    image immediately (ULTIMA_CAM_IMAGE_DIR/<label>.png if set and decodable,
    else a drawn "NO CAMERA" card). CameraView/SurroundView/DmaBufTextureSet
    are unchanged — zeroCopy() always reports false, which routes them
    through the QImage fallback path they already had.
    Hardware-verified: flashed to the board, camera grid screen confirmed
    showing plac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
    [camerafeed.cpp, camerafeed.h, main.cpp]
2026-09-01 beagley-ai: clear remaining mycam004m/uvcvideo references
    Follow-up to 687924d: drops the orphaned kernel-module-uvcvideo
    RDEPENDS from ultima-app.bb (a leftover USB-UVC pin from an earlier
    camera spike, unrelated to mycam004m, with no consumer left in the
    app), and rewords the last mycam004m/MY-CAM004M mentions in NOTES.md
    to describe the camera driver generically instead of naming the
    removed module.
2026-09-02 camdriver: NVP6324 AHD→CSI-2 V4L2 driver for BeagleY-AI
    Out-of-tree V4L2 subdev driver for the Nextchip NVP6324 (Jaguar1/N4)
    4-ch AHD→MIPI-CSI-2 decoder on CSI0 of the BeagleY-AI (J722S), plus a
    standalone DRM/KMS QA viewer (qa/camqa) and the bring-up findings.
    Key config (module params in nvp6324.c), validated on hardware:
    - mipi_mclk=594: TX D-PHY lane rate. The stock 1242 Mbps (Nextchip's
    4x1080p rate) is a marginal eye on this board and floors at ~4500
    CRC/s + shear; 594 Mbps gives CRC=0 for one 1080p25 stream.
    - vc_mask=0x1: enable only the arbiter VCs that carry a camera;
    enabling signal-less VCs splits each frame across two DMA buffers.
    - program_at_probe=1: bring the MIPI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
2026-09-02 beagley-ai: build the NVP6324 camera driver into the image, autoload
    Wire the (now hardware-proven) out-of-tree NVP6324 driver into the
    BeagleY-AI image build:
    - recipes-kernel/nvp6324: module recipe building camdriver/nvp6324.c
    (bind-mounted via build.sh); KERNEL_MODULE_AUTOLOAD so it loads at boot.
    - tisdk-base-image.bbappend: install nvp6324 + v4l-utils + i2c-tools;
    drop the bring-up blacklist (driver is proven: cold-boot clean probe,
    full-frame 1080p25 on VC0, CRC=0).
    - ultima-falcon-fit.bb: bake camdriver/dts/*.dtso into the Falcon DTB
    (enables main_i2c2, the nvp6324 node, and CSI0's cdns/ti/dphy).
    - linux bbappend + nvp6324.cfg: pin the in-tree Cadence CSI2RX / TI SHIM /
    Cad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
    [nvp6324.cfg]
2026-09-02 beagley-ai: nvp6324-csi-setup oneshot for CSI-2 format propagation
    The autoloaded camera pipeline failed STREAMON with -EPIPE: the nvp6324 subdev
    sources UYVY 1920x1080 but the downstream Cadence CSI2RX bridge and TI SHIM
    pads default to 640x480, and V4L2 link validation rejects the mismatch. The
    chip is locked and streaming fine (0xA0=0x0E, 594 PLL, CRC=0) — the pipeline
    just needs the format pushed down the media graph once, which nothing on the
    image did. (The earlier "probe-time race" hypothesis was disproven by direct
    measurement; the program_at_probe ordering fix is unrelated and stays.)
    Add nvp6324-csi-setup: a systemd oneshot that waits (bounded ~20s) for the
    media graph to comple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
2026-09-02 ultima-app: live camera capture in CameraFeed via media-graph node resolution
    Re-integrates real V4L2 capture (it was stripped to placeholders when the old
    mycam004m driver was removed) against the NVP6324 -> J722S CSI2RX stack, and
    selects the capture node from the media graph instead of a fixed /dev/videoN.
    mediagraph.{h,cpp}: resolve a virtual channel (VC0..3) to its capture node by
    walking MEDIA_IOC_G_TOPOLOGY — BFS downstream over data links from the nvp6324
    source through the Cadence bridge to the TI SHIM's "context <vc>" entity, then
    follow that entity's V4L video interface to its devnode. The /dev/videoN
    numbers are probe-order (and video0..1 are the Wave5 VPU nodes here), so a
    fi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
    [camerafeed.cpp, camerafeed.h, main.cpp, mediagraph.cpp, mediagraph.h]
2026-09-02 dashcam: plan + Wave5 hardware-encoder bring-up (M0 proven on hardware)
    Add DASHCAM.md (feature design, in-app architecture, milestones) and
    beagley-ai/wave5-enc/ — the standalone M0 proof that the AM67A/J722S Wave5
    VPU sustains four simultaneous 1080p25 UYVY->H.264 encodes with headroom
    (single 198fps, 4x 137fps aggregate; output validated H.264, deterministic).
    The camera's native UYVY feeds the encoder directly (no conversion). Two
    non-obvious findings drive the M1 in-app encoder: the CAPTURE queue must
    STREAMON before OUTPUT (else the encoder silently emits nothing), and stock
    tools (v4l2-ctl, the image's GStreamer) can't drive it — hence wave5enc.c,
    the raw-V4L2 M2M harness that is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
2026-09-03 dashcam: M1 in-app recorder — Wave5 hardware H.264 to /mnt/dvr
    Continuously records every camera to the auto-mounted USB drive using the
    AM67A Wave5 hardware encoder proven in M0. See DASHCAM.md.
    - wave5encoder.{h,cpp}: Wave5Encoder drives the V4L2 mem2mem encoder (UYVY in,
    H.264 out, capture-before-output STREAMON, clean STREAMOFF teardown).
    SegmentWriter caches SPS/PPS and prepends them to each segment, rotating on
    an IDR past the segment length so every .h264 decodes standalone.
    - dashcamrecorder.{h,cpp}: polls /mnt/dvr and toggles recording on all feeds.
    - camerafeed.{h,cpp}: the capture device now opens on display OR recording;
    the capture thread starts an encoder lazily on t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
2026-09-03 dashcam: M2 retention janitor — free-space ring buffer
    ultima-dvr-cull: a systemd timer (every 5 min) fires a oneshot that deletes the
    oldest .h264 recordings under /mnt/dvr/ULTIMA whenever the drive drops below
    10% free, reaping emptied day dirs. Separate from ultima-app so neither can
    take the other down; Nice + idle I/O so it never competes with recording or
    the display; a clean no-op when no drive is mounted. Wired into IMAGE_INSTALL.
    See DASHCAM.md (M2).
    Hardware-validated: oldest-first order, threshold trigger + delete loop, only
    .h264 touched (a non-recording filler was left alone), empty dirs reaped, no-op
    with headroom. Recipe builds and packages clean.
2026-09-03 dashcam: M3 robustness — exFAT fsck-on-mount, RTC loader, hot-unplug
    exFAT has no journal and the drive is power-cut constantly in a car:
    - ultima-dvr-mount now preen-fscks (fsck.exfat -p, from exfatprogs) via a
    helper launched non-blocking (systemd-run) from the udev add rule, then
    mounts. exfatprogs added (RDEPENDS; meta-filesystems).
    - SegmentWriter closes the current file on a write failure, so a yanked drive
    stops pinning the mount and the recorder's mount poll stops recording
    promptly instead of spinning on write errors.
    - ultima-rtc-load: a boot oneshot that sets the system clock from the onboard
    DS1340 (rtc0) so segment filenames get a real date. A clean no-op until the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
    [wave5encoder.cpp]
2026-09-03 dashcam: record M1-M3 flashed-image validation in DASHCAM.md
    Full tisdk-base-image flashed and validated on the board: clean boot (ultima-app NRestarts=0, no kernel errors), udev exFAT fsck+mount at /mnt/dvr, Wave5 recording 1080p H.264 segments (SPS-prepended across rotations, standalone-decodable Baseline L4.2), cull timer enabled+firing, RTC loader ran (Result=success). Remaining items are hardware only: RTC coin cell for real timestamps, and M4 4-camera MIPI eye.
2026-09-14 gauge cluster: ABS warning lamp + 20psi boost rescale
    Top indicator row recentered to six lamps (600-1000, 80px pitch) with a new
    ABS lamp; CanBus gets an absWarn stub (unwired, DIN5 planned) matching the
    driveMode pattern. Boost gauge max dropped 30->20psi to match the ECU's real
    limit (new background_overlay.png art, dev-sim target capped to match), and
    the boost ring recolors red past 19psi via a same-geometry red twin of
    boost_circle.png rather than in-place Canvas recoloring, which Qt's
    clip()+compositeOperation interaction doesn't handle correctly.
    [canbus.cpp, canbus.h]
2026-09-15 board: enable onboard WiFi (cc33xx) and 3-camera CSI video
    WiFi: the board's real onboard radio is a TI cc33xx, not the WL1807 the old
    image notes assumed (wrong TI reference board). Add ultima-wifi-connect
    (wpa-supplicant + cc33xx firmware/tools, associates wlan0 at boot; DHCP is
    already Arago's stock 30-wlan.network) and a cc33xx-fw-tilinux recipe that
    installs the cc33xx blobs from ti-linux-firmware. The stock meta-ti cc33xx-fw
    ships a 1282-byte cc33xx-conf.bin the 6.12.43-ti kernel driver rejects (wants
    1353), so the FW download failed every boot and no wlan0 appeared. cc33xx-fw
    drops out cleanly (nothing else pulls it). Hardware-verified: wlan0 associates
    and gets DHCP from a cold boot.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
2026-09-16 camera: 4x 1080p25 on CSI0 at 1049 Mbps/lane with TX HS resistor trim
    All four AHD cameras stream at 25 fps from boot. 1049 Mbps/lane is a rate
    derived on this board: the chip's own 4ch profile (1242) sits on a Cadence
    RX band edge that drops the last word of every line, 756 is the vendor
    720P profile mislabeled, and the TX PLL has no usable /1 rate below 1049.
    - nvp6324.c: add the 1049 PLL/timing table; bake MIPI_TX_HRES_IN
    (bank 0x21 reg 0x08 bit7), which cuts the residual CRC/word-slip rate 3x.
    - nvp6324.conf / nvp6324.bb: vc_mask=0xF mipi_mclk=1049 link_freq_idx=1,
    module autoload restored (the 434d797 "cold boot hang" was the WiFi
    firmware bug plus the broken 756 config, not the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
    [nvp6324.c]
2026-09-17 gauge cluster: DVR not-recording badge + format-drive dialog
    Two related dashcam-status features on the cluster:
    - Not-recording badge: camera_icon.png shown bottom-right whenever the
    DVR isn't recording. DashcamRecorder exposes `recording` to QML
    (main.cpp context property); main.qml gates the badge on it and on the
    overlay screens.
    - Format-drive dialog: when a USB disk is plugged in that isn't set up
    for the DVR (no ULTIMA_DVR label), DashcamRecorder detects it (USB-bus
    sysfs path only, exactly one disk, none mounted; 2-poll debounce so it
    never races udev's blkid on a good drive) and DvrFormatDialog.qml
    offers to format it. On confirm it runs the new ultima-dvr-format
    h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
2026-09-24 boot: pin fb0 to 1600x720 with a built-in panel EDID so the splash draws
    Under falcon boot the HDMI connector is first probed ~0.85 s after power-on,
    before the Waveshare panel answers DDC. DRM falls back to its no-EDID modes,
    fbdev creates fb0 at 1024x768 and never resizes it, and ultima-splash refuses
    its 1600x720 blob ("expected 3145728"), so the pre-Qt splash never showed.
    Ship the panel's own EDID (dumped from the running board, 1600x720@59, checksums
    valid) built into the kernel via CONFIG_EXTRA_FIRMWARE, and select it with
    drm.edid_firmware=HDMI-A-1:... in the falcon bootargs. Built in rather than
    /lib/firmware because the probe races the rootfs mount by ~70 ms. Not
    video=HDMI-A-1:16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
    [ultima-edid.cfg]
2026-09-25 gauge cluster: limp mode box with plain-English cause + M/S debug keys
    Decode the Syvecs limpMode enum (0x604 bytes 6-7) from the CAN2 mapping
    sheet: CanBus::limpModeName() (Diagnostic screen) and limpModeMessage()
    (plain-English text), from one shared table. When limpMode != 0 the dash
    shows limp_bg.png centered at y=163 with the message in white all-caps
    inside it, shrunk to fit the trapezoid.
    Dev/debug keys: M steps limpMode through every code (latches the sim's
    random limp flip off), S pauses/resumes the simulator. Documented in
    GAUGE-CLUSTER.md along with the 0x604 enum. Also adds the CAN2 mapping
    xlsx to docs/ and a refreshed Ultima.psd.
    [Auto Bionics CAN2 Mapping.xlsx]
2026-09-25 gauge cluster: remove FPS counter overlay
    Drop the on-screen frameSwapped-driven FPS readout from main.qml and the
    z-order comments that referenced it.
2026-09-25 camerafeed: remove per-feed fps stats log
    Drop the every-2s 'fps arrived/published/decoded | convert ms' line and the
    counters/timers feeding it from the capture thread. ULTIMA_CAM_FPS_LOG stays:
    it still gates the decoder-lock slip log and CameraView's upload timing.
    [camerafeed.cpp, camerafeed.h]
2026-09-30 diagnostics: raw CAN frame monitor + TPS; confirm trans mode polarity (0=auto, 8192=manual)
    Diagnostics screen gets a tap-the-title raw CAN frame monitor (per-ID bytes,
    rate, age, decoded values) and a Throttle (TPS1) channel from 0x600 bytes 4-5.
    ManualAuto_U12 (0x605 bytes 4-5) polarity is now confirmed on the car:
    0 = Automatic, 8192 = Manual, so transmissionAuto is raw == 0 (was != 0).
    Drop the unconfirmed flag on the Trans Mode channel.
2026-09-30 docs: remove MY-CAM to BeaglePlay pin mapping PSD
2026-09-30 diagnostics: watch calSelect and tcSwitch (0x60A slots 2/3)
    Decode Frame 11 (0x60A): calSelect (bytes 2-3, signed enum 0-11, active
    tune/cal map) and tcSwitch (bytes 4-5, traction-control switch position).
    Shown as Cal Select / TC Switch tiles on the Diagnostics screen and as a
    0x60A row in the raw CAN frame monitor. Grid goes 5x4 -> 6x4 (246px tiles)
    to fit the two extra channels.
2026-10-03 drive mode: derive NORMAL/SPORT/SPORT+ indicator from calSelect (0x60A slot 2)
    calSelect 0/1/2 now maps to NORMAL/SPORT/SPORT+ on the dash; other values leave it blank. Drops the RACE mode and its red color, updates the simulator and docs.
2026-10-04 camera grid: cross layout (front top-center, rear below, left/right at sides)
    Replace the 2x2 grid with a per-camera cross layout and label tiles
    FRONT/REAR/LEFT/RIGHT.
2026-10-04 nvp6324-csi-setup: retry routing/format step to survive boot race
    On some boots the first media-ctl -R failed with "Unable to setup routes:
    No such file or directory", leaving the CSI-2 bridge/SHIM at their 640x480
    defaults so every camera STREAMON returned -EPIPE until the script was
    re-run by hand.
    Wrap the route + format sequence in apply_pipeline() and retry it up to 15
    times, 1s apart, logging each failed attempt. The sequence is idempotent.
    Exhausting the retries exits non-zero so the unit still shows failed.
    Uses explicit `|| exit 1` rather than set -e: errexit is ignored inside a
    function called from an until/if condition.
2026-10-04 camera grid: remove FRONT/REAR/LEFT/RIGHT tile labels
    Keep the NO SIGNAL / FAILED status text so a dead feed is still visible.
2026-10-04 nvp6324-csi-setup: single deadline loop; never conclude "absent" from one check
    On a boot the unit logged "not present ... after 20s; leaving pipeline unset"
    after only 2.3s: the wait loop broke on a true graph_ready, an immediate second
    graph_ready came back false (graph still being assembled), and the script
    treated the camera as absent, exiting 0 with the pipeline at its 640x480
    default so every camera STREAMON returned -EPIPE.
    Replace the separate wait loop + re-check + retry with one loop bounded by a
    30s /proc/uptime deadline. Each pass applies the pipeline if the graph shows
    the camera; success requires both in the same pass. Absent is only concluded
    after the deadline (exit 0, logge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
2026-10-04 nvp6324-csi-setup: format all four capture nodes (root cause of post-boot EPIPE)
    Each /dev/videoN context node defaults to 640x480, and the four CSI routes
    share one TI SHIM sink pad, so STREAMON on any context validates the link to
    every routed context's node against that node's own format. Until all four
    nodes are 1920x1080, every STREAMON returns -EPIPE. Pad formats were always
    correct and the nvp6324 driver is not involved.
    Confirmed with the kernel's own debug output (j721e-csi2rx "Width does not
    match (source 1920, sink 640)", from -DDEBUG builds of the two CSI modules)
    and a controlled test: streaming fails with 1, 2 or 3 of 4 nodes set and works
    only with all four. It explains the "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
2026-10-04 drive mode: VALET/SPORT/SPORT+/RACE mapping with colors, default VALET
    calSelect 0-3 now maps to VALET (green), SPORT (white), SPORT+ (orange),
    RACE (red). Unmapped values and the period before the first 0x60A frame
    show VALET. Simulator cycles all four modes.
2026-10-04 drive mode: blank indicator for calSelect outside 0-3
    VALET is still shown until the first 0x60A frame arrives.
2026-11-02 sound: alert sounds over HDMI audio (warnings, drive mode, turn ticks, dashcam)
    The dash now plays short alert sounds through the panel's HDMI audio
    (McASP1 -> IT66122), which the bb.org kernel already registers as ALSA
    card 0 -- no kernel or DT change needed.
    - SoundPlayer: worker thread talking to libasound directly (no
    QtMultimedia). Loads <name>.wav from $ULTIMA_SOUND_DIR, /data/sounds,
    then /usr/share/ultima/sounds and converts to the card's only accepted
    format (48 kHz stereo S32_LE); a name with no usable file falls back to
    a built-in synthesised tone. Opens ALSA lazily (no boot cost), keeps the
    HDMI stream alive with silence for 4 s after a sound so bursts aren't
    clipped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
2026-11-08 debug keys: latch turn-signal/hazard override against live CAN
    With CAN2 live, the next MCE18 frame (DIN0/DIN1/DIN7) reverted an L/R/H
    debug-key toggle within one frame period. A key press now latches the value:
    decodeFrame() keeps tracking the real DIN level but does not apply it until
    CAN actually changes that signal, so repeated frames with the same level no
    longer undo the toggle and a real stalk/hazard action still takes over.
    Per-signal state lives in one IndicatorSlot instead of three copies.
2026-11-08 sound: keep HDMI stream open, pre-open it, fix double first tick
    Measured on the board: opening the ALSA stream is ~1 ms but starting it on a
    cold card takes ~2 s (snd_pcm_prepare) and tearing it down takes 0.5-5 s
    (HW_FREE + close). Closing after 4 s idle blocked the single worker thread,
    so a blinker started just after the close sounded seconds late and the queued
    ticks then played as a rapid burst.
    - SoundPlayer: never close on idle; open the stream in the background as soon
    as the card exists (quiet retry every 2 s) so the first sound is not the one
    that pays the cold start.
    - SoundPlayer::play(name, maxAgeMs): requests older than maxAgeMs are dropped;
    turn-signal ticks use 400 ms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
